hringdrifi/skjar/README.md

# SKJÁR

**SKJÁR** は、横長のタッチディスプレイと小型 Linux コンピュータを一体にした、40% のメカニカルキーボード / Cyberdeck です。

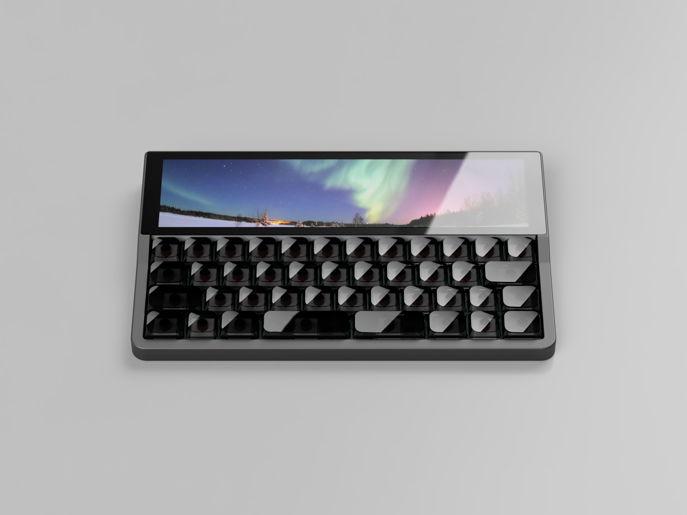
[picture p1: docs/images/render.png]
SKJÁR のレンダリング：上部に横長のディスプレイ、下に 42 キーの 40% キーボードを収めたケース


物理キーは文字入力に必要な最小限にとどめ、数字列・F キー・マクロ・メディア操作・ステータス表示などはタッチディスプレイ側に持たせます。PC につなげば普通の USB キーボードとして動き、本体側では Linux のアプリケーションが動きます。

> [!WARNING]
> **開発中のプロジェクトです。** 回路図・基板はまだ試作も動作確認もしていません。誤りが含まれている可能性が高いので、**このままの設計データで基板を発注したり、部品を買いそろえたりしないでください。** 内容は予告なく大きく変わります。

**状態：** 回路図を作成中。基板は部品の仮置きまで（配線は未着手）。決めたことは [docs/design-decisions.md](docs/design-decisions.md)、残っていることは [docs/open-items.md](docs/open-items.md) にあります。

---

## 名前の由来

古ノルド語の `skjár` から取りました。中世アイスランドで、半透明の膜を張った採光用の窓を指した言葉です。現代アイスランド語では「screen / display」を意味します。横長のディスプレイを主役にした本機に合わせた名前です。

---

## 設計思想

SKJÁR では、ディスプレイを「おまけ」として扱いません。物理キーとタッチ UI を合わせて、1つの入力システムにします。

一般的な 60% キーボードに画面を足すのではなく、

**必要最小限の物理キー ＋ 状況に応じて変わるソフトウェアキー**

という構成を基本にします。

---

## コンセプト

- 40% のコンパクトな物理キーボード
- 上部に 8.8″ の横長タッチディスプレイ
- Linux を搭載
- PC からは普通の USB HID キーボードとして見える
- 本体の Linux からも普通のキーボードとして見える（HID over I²C。素の Raspberry Pi OS のドライバで動く）
- キーごとの RGB バックライト
- タッチ UI を物理キーの拡張として使う
- Cyberdeck 的な自由度
- ケーブル1本でも全機能が動く（相手が 5 V / 1.5 A 以上を出せる場合）

---

## 構成

SKJÁR の構成：USB-C 2 口を TPS2121 で切り替え、RP2040 と CM0 を UART と I²C HID でつなぐ

| 部分 | 内容 |
|---|---|
| メインコンピュータ | Raspberry Pi Compute Module 0（CM0100000：CM0Lite、Cortex-A53 ×4 / 1 GHz、512 MB、Wi-Fi / BT）。microSD から起動 |
| キーボード用マイコン | RP2040（PC への USB HID、CM0 への HID over I²C、キーの RGB、電源の判断、CC の判定） |
| キー | Kailh Choc V2 系（ホットスワップ）×42。キーごとに RGB LED（SK6812MINI-E） |
| ディスプレイ | Waveshare 8.8inch DSI LCD または 8.8-DSI-TOUCH-A（480×1920、10点タッチ、DSI 2レーン） |
| 電源 | USB-C ×2、5 V 専用（PD なし）、上限 15 W。TPS2121 で切り替え |
| RTC | PCF8563T ＋ 32.768 kHz 水晶 ＋ CR2032 |
| 音声 | TLV320DAC3100（I²S コーデック。スピーカーアンプとイヤホン出力を内蔵）＋ スピーカー ＋ 3.5 mm イヤホンジャック |
| OS | Raspberry Pi OS Lite。デスクトップ環境は使わず、専用 UI を直接起動する。カーネルとドライバは標準のまま、オーバーレイと `config.txt` だけで大体の機能が動くようにする |

詳しい仕様と理由は [docs/design-decisions.md](docs/design-decisions.md) を見てください。

---

## タッチ UI でやりたいこと

数字列、F1〜F12、マクロキー、レイヤーの表示と切り替え、メディア操作、音量スライダー、輝度調整、アプリランチャー、PC のステータス表示、時計、CPU / RAM / ネットワークの表示、WPM 表示、アニメーション、動画再生、トラックパッドモード、ジェスチャ入力、アプリごとに変わる UI。

---

## リポジトリの構成

```text
README.md                 この文書
LICENSE, LICENSES/        ライセンスの説明と全文
docs/                     文書（CC BY-SA 4.0）
├─ design-decisions.md    設計判断の記録
├─ open-items.md          残件
├─ protocol.md            RP2040 ↔ CM0 の通信仕様
├─ pin-assignment.md      ピンの割り当てとシート間の信号
├─ schematic/             回路図のシートごとの仕様（部品、接続、定数）
├─ images/                図（構成図など）
└─ references/README.md   参照した一次資料の出典と要点
hardware/                 ハードウェア（CERN-OHL-S-2.0）
├─ pcb/                   KiCad 10 のプロジェクト（lib/：専用部品、production/：製造用データ）
├─ layout/                キー配列
└─ case/                  ケース
firmware/                 ファームウェア（MIT）
└─ rp2040/                キーボードと電源管理
software/                 CM0 側のソフトウェア（MIT）
├─ ui/                    専用 UI
└─ os/                    OS の設定とイメージ作成
```

他社の資料（データシート、図面、技適の試験成績書など）は、著作権の都合でリポジトリに含めていません。出典のリンクは [docs/references/README.md](docs/references/README.md) にあります。

---

## ライセンス

| 対象 | ライセンス |
|---|---|
| ハードウェア（回路図、基板、ケースの設計データ） | [CERN-OHL-S-2.0](LICENSES/CERN-OHL-S-2.0.txt) |
| ソフトウェア（ファームウェア、UI、スクリプト） | [MIT](LICENSES/MIT.txt) |
| 文書（この README と docs/ 以下） | [CC BY-SA 4.0](LICENSES/CC-BY-SA-4.0.txt) |

詳しくは [LICENSE](LICENSE) を見てください。
