hringdrifi/skjar/hardware/README.md

# hardware

SKJÁR のハードウェア設計データ。ライセンスは [CERN-OHL-S-2.0](../LICENSES/CERN-OHL-S-2.0.txt)。

| フォルダ | 内容 |
|---|---|
| [pcb/](pcb/) | KiCad 10 のプロジェクト（回路図と基板） |
| [layout/](layout/) | キー配列 |
| [case/](case/) | ケースの設計データ |
