hringdrifi/skjar/hardware/case/README.md

# case

ケースの設計データを置く。タイピングアングル、ケースの材質はまだ決まっていない（[docs/open-items.md](../../docs/open-items.md)）。
