hringdrifi/skjar/hardware/pcb/production/README.md

# production

JLCPCB に発注した版ごとの製造用データ（ガーバー、BOM、CPL）を置く。

フォルダ名は `rev<版>-<日付>`（例：`revA-20261201`）にする。
