hringdrifi/skjar/docs/schematic/rp2040.md

# RP2040 シート（rp2040.kicad_sch）

回路図を描くための仕様。GPIO の割り当ては [pin-assignment.md](../pin-assignment.md) の「3. RP2040 の GPIO」、決めた理由は [design-decisions.md](../design-decisions.md) を参照。

**[要決定]** は描く前に決める項目、**[要確認]** は描きながらデータシートで確かめる項目。

**手本：** [rp2040-reference.pdf](rp2040-reference.pdf)（画像は [rp2040-reference.png](rp2040-reference.png)）。2026-11-06 の回路図から書き出した版。回路図を変えたら書き出し直す。正は `hardware/pcb/rp2040.kicad_sch`。部品番号は 100 番台（U101、R101、C101 など）。

---

## 1. 部品

| 記号 | 部品 | シンボル | LCSC | 区分 |
|---|---|---|---|---|
| U101 | RP2040 | `MCU_RaspberryPi:RP2040`（QFN-56） | C2040 | Extended（Basic の代わりはない） |
| U102 | W25Q128JVPIQ（16 MB、WSON-8 6 × 5 mm） | `Skjar:W25Q128JVP`（自作。`Memory_Flash:W25Q128JVS` に露出パッドの 9 番（GND）を足したもの。`Package_SON:WSON-8-1EP_6x5mm_P1.27mm_EP3.4x4.3mm`） | C190862 | Extended（手持ち） |
| Y101 | 12 MHz 水晶 TAITIEN XXHBBCNANF-12.000000MHZ（負荷容量 20 pF、±10 ppm） | `Device:Crystal_GND24`（`Crystal_SMD_3225-4Pin_3.2x2.5mm`） | C521581 | Extended（手持ち） |
| SW101 | タクトスイッチ（BOOTSEL） | `Switch:SW_Push` | [要決定] | |
| 抵抗・コンデンサ | 0402 か 0603 | — | — | Basic から選ぶ |

## 2. 電源まわり（`+3V3` から）

| ピン | 接続 | 部品 |
|---|---|---|
| IOVDD（1, 10, 22, 33, 42, 49） | `+3V3` | **各ピンに 100 nF**（ピンの近くに置く） |
| USB_VDD（48） | `+3V3` | 専用のパスコンなし。隣の IOVDD（49）とピンの外ですぐにつなぎ、49 の 100 nF で兼ねる |
| ADC_AVDD（43） | `+3V3` | 100 nF |
| VREG_VIN（44） | `+3V3` | 1 µF |
| VREG_VOUT（45） | DVDD（23, 50）へ | VREG_VOUT に 1 µF、DVDD の各ピンに 100 nF |
| TESTEN（19） | GND | |
| GND（57、裏面のパッド） | GND | |

- **1.1 V のコア電源：** RP2040 内蔵のレギュレータで作る（VREG_VOUT → DVDD）。ネット `+1V1` は電源記号（`power:+1V1`）で描く。外付けのレギュレータは要らない。
- **USB_VDD のパスコンを省いた理由：** 右辺（43〜50）はピンが 2.6 mm に集まり、パスコンを置く場所が足りない。1 個減らせば残りをピンに近づけられる。USB はフルスピード（12 Mbps）だけで電流も小さいので、隣の 49 番の 100 nF（QSPI 側で電流の変化が大きいほう）を近くに置いて兼ねる。部品番号 C108 は欠番。
- **ADC_AVDD の雑音対策：** CC の判定は電圧の範囲が広いので、RC フィルタは入れずにコンデンサだけにする。

## 3. 水晶（12 MHz）

| ピン | 接続 |
|---|---|
| XIN（20） | 水晶の一端、負荷コンデンサで GND へ |
| XOUT（21） | 直列抵抗を通して水晶のもう一端へ、負荷コンデンサで GND へ |
| 水晶の GND 端子（2, 4） | GND |

- **負荷コンデンサ：** **27 pF**（C0G、C107045）を各 1 個。前に作った基板（Segl）で、同じ水晶・27 pF・1 kΩ の組み合わせで動いた実績がある。計算上の値（2 ×（20 pF − 浮遊容量 3〜5 pF）≒ 30〜33 pF）より少し小さいので、周波数はわずかに高めになるが、発振の余裕は増える。
- **XOUT の直列抵抗：** 1 kΩ（Raspberry Pi の設計資料と Segl と同じ）。起動が不安定なら、小さくすると余裕が増える。
- **Raspberry Pi の推奨回路との違い：** 設計資料の回路は ABM8-272-T3（負荷容量 10 pF・ESR 50 Ω）に 15 pF。負荷容量 20 pF の水晶は大きなコンデンサが要るぶん発振の余裕が小さいが、実績を優先した。駄目なら ABM8-272-T3（C20625731）と 15 pF に替える（フットプリントは同じ）。
- **ファームウェア側の対策：** 水晶の起動が遅い場合に備えて、pico-sdk の `PICO_XOSC_STARTUP_DELAY_MULTIPLIER` を大きめ（例：64）にしておく。

## 4. QSPI フラッシュ（W25Q128JVPIQ、WSON-8 6 × 5 mm）

裏面の露出パッド（9 番）は GND につなぐ（データシートでは未接続か GND でよい）。はんだの固定と放熱のため。基板ではパッドの中に GND のビアを打つ。

| RP2040 | W25Q128 | 
|---|---|
| QSPI_SS（56） | /CS（1） |
| QSPI_SD1（55） | DO / IO1（2） |
| QSPI_SD2（54） | /WP / IO2（3） |
| QSPI_SD0（53） | DI / IO0（5） |
| QSPI_SCLK（52） | CLK（6） |
| QSPI_SD3（51） | /HOLD / IO3（7） |
| `+3V3` | VCC（8）、100 nF |
| GND | GND（4）、露出パッド（9） |

- **配置：** RP2040 のすぐ近くに置き、配線は短く揃える。

## 5. BOOTSEL と RUN

| 信号 | 接続 |
|---|---|
| QSPI_SS（56） | **BOOTSEL スイッチ**を 1 kΩ を介して GND へ。押しながら Port A を挿すと UF2 の書き込みモードになる |
| RUN（26） | 10 kΩ で `+3V3` にプルアップ。テストパッドを付ける（GND に落とすとリセット） |
| SWCLK（24）/ SWDIO（25） | テストパッドだけ（CM0 にはつながない） |

- **普段のファーム更新：** CM0 から UART のコマンドで「UF2 の書き込みモードで再起動」を送れるので、BOOTSEL スイッチは、初回の書き込みとファームが壊れたときの復旧用。

## 5.1 CM0 の USB ブート要求

| 信号 | 接続 |
|---|---|
| `BOOT_EN`（GPIO23） | cm0 シートの Q202（2N7002）のゲートへ。High で CM0 の nRPI_BOOT を Low に引く |

- 要求はキーの組み合わせで出す（専用のスイッチ SW102 とプルアップ R104 は廃止。GPIO20 はキーの RGB に回した）。
- RP2040 は要求を受けたら、`BOOT_EN` を High にしてから GLOBAL_EN を解除する（電流宣言が Default でも、CM0 だけ ON にする）。

## 5.2 キーの RGB

| 信号 | 接続 |
|---|---|
| `RGB_DATA`（GPIO14） | keymatrix シートのバッファ（SN74AHCT1G125）へ。PIO で出す |
| `RGB_EN`（GPIO20） | keymatrix シートの 2N7002 のゲートへ。High で `+5V_LED` が ON（プルダウンは keymatrix シート側） |

- LED の電源を切っているときは、`RGB_DATA` を Low にしておく。

## 6. USB（Port A）

| RP2040 | 接続 |
|---|---|
| USB_DP（47） | 27 Ω を介して `USB_A_D+`（power シートから） |
| USB_DM（46） | 27 Ω を介して `USB_A_D-`（power シートから） |

- **27 Ω の位置：** RP2040 の近くに置く。
- **PC がつながっているかの判定：** `CC1_A` / `CC2_A` の電圧で判定し、つながっていないときは USB を有効にしない（自分で給電しているデバイスなので、相手がいないときに D+ をプルアップしてはいけないため）。

## 7. GPIO

| GPIO | ピン | 信号 | 接続先 | 備考 |
|---|---|---|---|---|
| 0 | 2 | `COL5` | keymatrix | 出力（RMK の COL2ROW で、順に High にする） |
| 1 | 3 | `COL4` | keymatrix | 出力（RMK の COL2ROW で、順に High にする） |
| 2 | 4 | `COL3` | keymatrix | 出力（RMK の COL2ROW で、順に High にする） |
| 3 | 5 | `COL2` | keymatrix | 出力（RMK の COL2ROW で、順に High にする） |
| 4 | 6 | `COL0` | keymatrix | 出力（RMK の COL2ROW で、順に High にする） |
| 5 | 7 | `COL1` | keymatrix | 出力（RMK の COL2ROW で、順に High にする） |
| 6 | 8 | `ROW1` | keymatrix | 入力。内部のプルダウンを使う |
| 7 | 9 | `ROW3` | keymatrix | 入力。内部のプルダウンを使う |
| 8 | 11 | `ROW5` | keymatrix | 入力。内部のプルダウンを使う |
| 9 | 12 | `ROW6` | keymatrix | 入力。内部のプルダウンを使う |
| 10 | 13 | `ROW0` | keymatrix | 入力。内部のプルダウンを使う |
| 11 | 14 | `ROW2` | keymatrix | 入力。内部のプルダウンを使う |
| 12 | 15 | `ROW4` | keymatrix | 入力。内部のプルダウンを使う |
| 13 | 16 | `KB_INT` | cm0 | オープンドレインで Low に引くだけ（プルアップは cm0 シート側）。テストパッド TP108 |
| 14 | 17 | `RGB_DATA` | keymatrix | キーの RGB のデータ（PIO） |
| 15 | 18 | `CM0_PWROFF` | cm0 | ゲートのプルアップは cm0 シート側 |
| 16 | 27 | `RP_TXD` | cm0 | UART0 TX。cm0 シートのバッファへ |
| 17 | 28 | `CM0_TXD` | cm0 | UART0 RX。**プルなし** |
| 18 | 29 | `LCD_EN` | power | プルダウンは power シート側 |
| 19 | 30 | `PWR_ST` | power | プルアップは power シート側 |
| 20 | 31 | `RGB_EN` | keymatrix | High でキーの RGB の電源が ON（プルダウンは keymatrix シート側） |
| 21 | 32 | `CM0_RUN_PG` | cm0 | **プルなし** |
| 22 | 34 | `CM0_HALT` | cm0 | **プルなし** |
| 23 | 35 | `BOOT_EN` | cm0 | Q202 のゲートへ（プルダウンは cm0 シート側） |
| 24〜25 | 36〜37 | `KB_SDA` / `KB_SCL` | cm0 | I2C0（ターゲット）。**プルなし**（プルアップは cm0 シート側）。テストパッド TP106 / TP107 |
| 26〜29 | 38〜41 | `CC1_A` / `CC2_A` / `CC1_B` / `CC2_B` | power | 各 1 kΩ の直列抵抗を介して ADC へ |

- **CC の直列抵抗（1 kΩ）：** 過電圧保護でその入力が遮断され、RP2040 の電源が切れているときでも、相手の Rp から ADC のピンに電流が流れ込みすぎないようにするため。
- **キーマトリクスの並び：** 基板で配線しやすい順に GPIO0〜12 を割り当てた（2026-11-06）。番号の順にはなっていないので、ファームウェアのピン定義はこの表（または [pin-assignment.md](../pin-assignment.md)）から取る。

## 8. テストパッド

`+3V3`、GND、RUN、SWCLK、SWDIO、`KB_SDA` / `KB_SCL`（GPIO24 / 25。TP106 / TP107）、`KB_INT`（GPIO13。TP108）。

## 9. シート外とつなぐグローバルラベル

| ラベル | 向き |
|---|---|
| `USB_A_D+` / `USB_A_D-` | 双方向（↔ power） |
| `CC1_A` / `CC2_A` / `CC1_B` / `CC2_B` | 入力（← power） |
| `PWR_ST` | 入力（← power） |
| `LCD_EN` | 出力（→ power） |
| `CM0_PWROFF` / `BOOT_EN` / `RP_TXD` / `KB_INT` | 出力（→ cm0） |
| `KB_SDA` / `KB_SCL` | 双方向（↔ cm0） |
| `CM0_TXD` / `CM0_RUN_PG` / `CM0_HALT` | 入力（← cm0） |
| `ROW0`〜`ROW6`、`RGB_DATA`、`RGB_EN` | 出力（→ keymatrix） |
| `COL0`〜`COL5` | 入力（← keymatrix） |
