hringdrifi/skjar/docs/schematic/display.md

# ディスプレイシート（display.kicad_sch）

**手本：** [display-reference.pdf](display-reference.pdf)（画像は [display-reference.png](display-reference.png)）。

## 1. 22 ピン DSI コネクタ（J301、0.5 mm ピッチ）

Raspberry Pi 5 / CM4 と同じピン配置（2026-11-05 に戻した。11-03〜11-05 は逆順だった）。8.8-DSI-TOUCH-A を付属の 22 ピン FFC（両端で接点の向きが逆）でつなぐと、基板の n 番がパネルの 23 − n 番につながる。

| ピン | 信号 | ピン | 信号 |
|---|---|---|---|
| 1 | GND | 12 | `DSI_D2_P` |
| 2 | `DSI_D0_N` | 13 | GND |
| 3 | `DSI_D0_P` | 14 | `DSI_D3_N` |
| 4 | GND | 15 | `DSI_D3_P` |
| 5 | `DSI_D1_N` | 16 | GND |
| 6 | `DSI_D1_P` | 17 | 未接続 |
| 7 | GND | 18 | 未接続 |
| 8 | `DSI_CK_N` | 19 | GND |
| 9 | `DSI_CK_P` | 20 | `I2C_DSI_SCL` |
| 10 | GND | 21 | `I2C_DSI_SDA` |
| 11 | `DSI_D2_N` | 22 | `+3V3_CM0`（100 nF） |

- **ピン番号の決め方：** どちらの端が 1 番かは、J301 の向きと割り当てで自由に決められる。決まっているのは、FFC の線の物理的な並び（ディスプレイの向きと通し方で決まる）。今の通し方では、J301 の端で 3V3 の線が基板の上側（奥）に来るので、奥の端の 22 番を 3V3 にした。ケーブルをねじらずに済む。
- **TOUCH-A 側のピン配置と照合済み：** [Wiki の Interfaces の図](https://www.waveshare.com/wiki/8.8-DSI-TOUCH-A)では、パネル側は 1 番 3V3、2 番 I2C_SDA、3 番 I2C_SCL … 22 番 GND。基板の n 番がパネルの 23 − n 番につながるので、22 本すべてが一致する。
  - 未接続の 17 / 18 番は、パネルの 6 / 5 番（RESERVE）に当たる。
  - 上下両面に接点があるコネクタだと、FFC を裏返して挿しても接点が当たり、電源と GND が入れ替わる。正しい面にしか接点が当たらない片面接点のコネクタにする。
- **3V3 は `+3V3_CM0` から取る：** CM0 が OFF のときはパネル側の I²C にも電圧がかからないので、CM0 に逆電圧がかからない。
- **コネクタの部品：** **Hirose FH12A-22S-0.5SH(55)**（2026-11-05。片面接点の上接点、フロントフリップ、高さ 2.0 mm、LCSC C3168813）。上接点（ケーブルの接点を基板と反対に向けて挿すもの）で、はんだ付けの足が差し込み口と反対側にある。ランドパターンは FH12 と共通で、1 番の位置も同じなので、フットプリントは KiCad 標準の `Connector_FFC-FPC:Hirose_FH12-22S-0.5SH_1x22-1MP_P0.50mm_Horizontal` のまま。本体は FH12 より少し幅が広い（22 ピンで 15.5 mm、FH12 は 15.1 mm）。
  - 置き方：基板の裏、CM0 の右。差し込み口が左（FFC の穴の方）、足が右、1 番が手前、22 番（3V3）が奥に来る向き（90°）。
  - FFC の通し方（2026-11-05）：ディスプレイは 0° で付ける（コネクタは左寄り）。TOUCH-A の背面のコネクタからケーブルは左に出る（3V3 の線は奥）。ディスプレイと基板の間で右へ折り返し、CM0 の上を通って、J301 の左の穴を S 字にくぐり、基板の裏で J301 に左から挿す。折り返しでケーブルの長さを調整する。折り目はどれもケーブルの長さの向きに直角で、斜めには折らない。
  - 面の向き：折り返し 1 回で面が 1 回裏返り、S 字では裏返らない。J301 の端ではケーブルの接点が基板と反対を向くので、上接点を使う（2 回裏返る前の通し方では下接点の FH12 だった）。
  - 線の並び：直角に折っても、穴をくぐっても、線の上下（奥と手前）の並びは変わらない。J301 の端では、奥から 3V3、SDA、SCL … D3、D2、CK、D1、D0、GND と並ぶ。
  - DSI の配線：CM0 は 180° 回して置くので、右の辺の DSI のピンは上から D3、D2、CK、D1、D0（各ペアは P が上）で、J301 の並びと同じ。J301 の足は CM0 と反対（右）を向くので、配線は FFC の穴の端を回り、J301 の下を F.Cu で通って、足の先でビアを打って折り返し、パッドに入れる。1 本ずつ同じ高さで折り返すので交差しない。
  - 実物が届いたら、挿す前に面と向きを確かめる。斜めに折ったりひねったりすると、接点の面と線の並びが変わる。

## 2. LCD の電源（J302）

ライトアングルの 2.54 mm 1×3 ピンヘッダ（`Connector_PinHeader_2.54mm:PinHeader_1x03_P2.54mm_Horizontal`）。1 番 `+5V_LCD`、2 番 `+5V_LCD`、3 番 GND（Raspberry Pi の 2・4・6 番と同じ並び）。挿し込み口を基板の穴の方に向けて配置する。

## 3. シートをまたぐネット

- グローバルラベル：`DSI_*`（10 本、入力）、`I2C_DSI_SDA` / `I2C_DSI_SCL`（双方向）
- 電源記号：`+5V_LCD`（power シートから）、`+3V3_CM0`（cm0 シートから）、GND
