hringdrifi/skjar/docs/open-items.md

# 残件

2026-11-01 時点。決まったことは [design-decisions.md](design-decisions.md) にある。

## 基板の配置の前に決めること
- [ ] 基板は仮の配置まで済み（`hardware/pcb/skjar.kicad_pcb`、228.6 × 146.2 mm。キー 12 個分の幅で、最下段の手前で切る。ディスプレイ（240.5 mm）は左右に約 6 mm ずつはみ出すので、ケースの縁で支える）。キーの間隔は仮に 19.05 mm、部品はすべて裏面。2026-11-05 にディスプレイを 0° に戻し、CM0 を中央へ移した（[design-decisions.md](design-decisions.md) の 4 章）。決めること：LCD の電源ケーブルの穴、USB-C・microSD・イヤホンジャックを基板の縁に合わせる微調整、移した部品の細かい位置
- [ ] キーのフットプリント（`CPG135001S30_<幅>U`。1U・1.25U・1.75U・2.25U・2.75U）は Choc V2 専用（V1 用の左右の足の穴は消した。スタビライザーとキーキャップが V2 前提のため）。ソケットのパッドが部品面（F.Cu）にあるので、基板では裏返して置いた。裏返したときに、スイッチのピンの位置が上から見て正しいかを確かめる
- [ ] キーの間隔（19.05 mm か 18 mm か）
- [ ] スペース（2.75u、2.25u）用の Choc スタビライザー：Kailh の Choc V2 用（CPG1353G24D01。Chosfox のクロスコアや Keebio の Choc V2 スタビと同じもの）を前提に、基板の穴（`CPG1353G24D01_<幅>U`）を置いた。Kailh の図面は見つからなかった。実物を測った値：左右の中心は 12 mm、基板に刺さる部分は 5.9 × 7.8 mm、プレートを通る部分は幅 5.9 mm・高さ約 14.2 mm。基板の穴は Keebio のフットプリント（中心から左右 12 mm、6.5 × 9.5 mm）に合わせ、角は 0.5 mm で丸めた。穴がソケットのパッド 1 に 0.25 mm かかるのは承知の上。プレートの穴（`CPG1353G24D01_<幅>U_Plate`。2.25U と 2.75U で穴は同じで、Fab の外形だけ違う）は実寸を元に描いた 1 つの輪郭で、スタビライザーの穴 6.0 × 14.05 mm（中心から左右 12 mm）、スイッチの穴 14.0 × 14.0 mm、その上側をつなぐワイヤーの溝（高さ 1.5 mm）。3D モデルはない。試作のプレートで、はまり具合を確かめる
- [ ] Choc ホットスワップソケット：仮に Kailh CPG135001S30（C5333465、Extended。ソケット自体は Choc V1 / V2 両対応だが、基板は V2 専用）を割り当てた。手持ちがあればそれにする
- [ ] キーの RGB（SK6812MINI-E）の配置：位置は決めた（スイッチの中心から 4.93 mm 上、[design-decisions.md](design-decisions.md) の 6.1）。基板に置くときに、穴が 1 個ずつ開いているかを確かめる。数珠つなぎの順番は回路図で行ごとに折り返した（1→12、23→13、24→34、42→35）ので、基板の配置もこれに合わせる
- [ ] Lofree Wizard に LED 窓があるか（光を通すか）を実物で確かめる。資料は見つからなかった
- [ ] ケース（タイピングアングルは 3.5° に決めた。[design-decisions.md](design-decisions.md) の 7 章）：[hardware/case/](../hardware/case/) に仮の形を作った。決めること：
  - 基板を留めるねじの位置（今は仮の 12 か所。部品の配置に合わせて 3 か所動かした（2026-11-03））。基板に穴を開けて、ほかの部品をよける
  - 厚さ（手前 15.4 mm、奥 24.8 mm）と、ガラスのまわりの縁の幅（1.4 mm）
  - 基板を斜めに差し込んで寝かせられるか（部品の配置を変えたあとに、傾ける・手前へずらす・上へ抜く動きで当たりを確かめる。2026-11-05 の配置では、5° まで傾け、5 mm ずらし、10 mm 上げるまで当たりなし。3D モデルのない J402・U4・Y402・SW101 は確かめていない）
  - USB-C・イヤホン・microSD の穴の大きさと高さ（USB-C は寸法図から 3D モデルを作った（2026-11-05）。イヤホンと microSD は寸法を仮に置いた）
  - BOOTSEL（SW101）を底の穴から押せるか（穴から約 10 mm 奥にある）
  - ディスプレイのスタッドのねじ（M2.5 の雌ねじと仮定）
- [ ] 2層・1枚（1.2 mm、差動線は GCPW。[design-decisions.md](design-decisions.md) の 7 章）で、USB（Port B → CM0）を 2〜3 cm 以内、DSI（CM0 → FPC）を 3〜5 cm 以内に引けるかを、配線して確かめる
- [ ] LCD の電源ケーブルの穴（まだ開けていない）。J302（x 118.1、y 52.6）の奥、x 116.3〜124.9、y 63.2〜67.6 に開ける前提で部品をよけてある（Cmts.User に印）。FFC の穴は J301 の左に開けた（x 167.4〜173.4、y 37.1〜57.3、2026-11-05）。J301（x 201.6、y 47.15）の高さは、8.8inch DSI LCD の DSI コネクタ（x 109.5、y 47.15）にそろえた。TOUCH-A のコネクタは x 101.1、y 45.5。付属の FFC は約 200 mm
- [ ] DSI（CM0 → J301）は FFC の穴の端を回るので、まっすぐより長くなる（見込み 40 mm 前後）。穴の長さ（20.3 mm）を FFC の幅（約 12 mm）に近づければ短くできる
- [ ] 作業済みのキーの配線のうち、COL2（B.Cu）がディスプレイの穴（DISP2 の右下、x 201.6、y 79.8）にかかる（DRC で 1 か所）。ディスプレイを 0° に戻して、前の 7 か所は消えた。配線を穴の外へ引き直す
- [x] 基板の取り付け穴（H1〜H12、`Skjar:MountingHole_M2_CaseBoss`）を、ケースのスクリプトの仮の 12 か所に置いた（2026-11-03）。M2 を上から締めて、ケースの柱（Ø5、インサート）に留める。部品・配線・ディスプレイの穴とキーのスイッチに当たらないこと、キーキャップを押し込んでもねじの頭（Ø4 以下）から 2.7 mm 以上離れることを確かめた。make_case.py は H の位置から柱を立てる。部品を動かして当たるようになったら、穴の方を動かしてケースを作り直す
- [x] J301 のピンの割り当てを Raspberry Pi と同じ順に戻した（2026-11-05。11-03 からは逆順だった）。ディスプレイを 0° に戻して FFC の通し方が変わり、3V3 の線が基板の上側（奥）に来るので、奥の端を 22 番（3V3）にした（[schematic/display.md](schematic/display.md)）
- [ ] ディスプレイの取り付け（TOUCH-A と 8.8inch DSI LCD の両方。[design-decisions.md](design-decisions.md) の 4 章）：スタッドを通す穴のフットプリント `Waveshare_8.8-DSI-TOUCH-A_Studs`（DISP1）と、確認用の 8.8inch DSI LCD のモデルと穴（DISP2）を、基板の中央・キーの上に置いた。コネクタやカバーの出っ張りの穴は、モデルを見ながら手で開ける。決めること：
  - ディスプレイと基板の間の高さ（ケースの設計と合わせて決める。3D モデルの高さもそれに合わせる。今はスタッドの底が基板の表面）
  - 基板上のフットプリントの位置（J301 と、TOUCH-A の FPC の位置を合わせる）
  - 8.8inch DSI LCD を 0° で付けたとき（DISP2 の今の高さ。2026-11-03 に公式 STEP から調べた 180° のときの範囲を、ディスプレイの中心で点対称に移したもの、2026-11-05）：
    - DSI コネクタは基板の座標で x 107〜112、y 35.5〜58.5 に来る。J301 までは約 70 mm で、Pi 5 用の「DSI-Cable-12cm」（15 → 22 ピン）は上での折り返しと穴の S 字を入れて届くかが際どい。実物で確かめる。このケーブルも TOUCH-A のケーブルも、Pi 5 の 22 ピンにそのまま挿せる作りなので、22 ピン側の端の接点の面と信号の並びの関係は同じ
    - ドライバ基板の部品のうち、次のものは基板の表面より下まで出るので、基板に穴が要る：DSI コネクタ（上の範囲）、40 ピンのコネクタ（x 199〜205、y 37.5〜61.5）、USB-C（x 97〜103.5、y 61.5〜70.5）、4 ピンのコネクタ（x 105〜117、y 74.5〜83）、2 ピンのヘッダ（x 119〜124、y 78.5〜82.5）、スイッチ（x 145〜153、y 77〜83）、小さな部品（x 200.5〜204、y 65.5〜74.5 と x 116〜120、y 65〜67）。今の配置では、どれも裏の部品のコートヤードにかからない
  - 2D 図面の背面図は上下が逆に描かれている（8.8inch DSI LCD の公式 STEP と比べてわかった）。TOUCH-A の自作 3D モデルは図面から起こしたので、FPC コネクタの上下が逆の可能性がある。実物で確かめる
- [ ] 電池ホルダーの向き（MY-2032-08 か -08-R か）
- [ ] アンテナの貼り付け位置（CM0 から 60 mm 以内。TOUCH-A のアルミ背面を避ける）
- [ ] 熱の逃がし方（裏面の CM0 からケースの底板へ逃がす案）
- [ ] ケースの材質
- [ ] microSD のスロットを、ケースの外からカードを抜き差しできる位置に置く。2026-11-05 に TF-01A（プッシュプッシュ）に変え、本体の前を基板の縁にそろえた（[schematic/cm0.md](schematic/cm0.md) の 5a）。後ろの壁（厚さ 2.43 mm）のままだと、ロックしたカードは壁の外面より約 0.4 mm 内側、飛び出したカードは外へ約 2.7 mm。壁を J201 の前だけ 1 mm ほど削れば、ロック時に約 0.6 mm、飛び出し時に約 3.7 mm 出る。削るかを決める
- [ ] 3.5 mm イヤホンジャックの位置（ケースの外から挿せる位置）

## 回路図を描きながら決めること
- [x] 22ピン FPC コネクタ（J301）：Hirose FH12A-22S-0.5SH(55)（C3168813、片面の上接点）にした（2026-11-05。11-03 からは下接点の FH12-22S-0.5SH(55)、C597981）。FFC の通し方が変わり、J301 の端で接点が基板と反対を向くため。両面接点だと、FFC を裏返して挿しても接点が当たり、3V3 と GND が入れ替わるので使わない。向きは [schematic/display.md](schematic/display.md)。実物の FFC で、接点を基板と反対に向けて挿したときに 3V3 の線が 22 番（奥）に来るかを確かめる
- [ ] タクトスイッチ（SW101、BOOTSEL）：仮に TS-1187A-B-A-B（C318884、Basic、5.1 × 5.1 × 1.5 mm）を割り当てた。ケースの穴から押せるかで確定する
- [ ] 22 ピン DSI の FFC の向き（1 番ピンと接点の面）を実物で確かめる。ピン配置は CM4 IO ボードの資料（J16）と、8.8-DSI-TOUCH-A の Wiki のピン表（FFC で反転）の両方と一致を確認済み。8.8″ 液晶はカーネルのドライバで 2 レーン・480 × 1920（D2 / D3 は配線するが使わない）
- [ ] スピーカーとコネクタ（J401）：コネクタは仮に PicoBlade 53261-0271（C177225、1.25 mm）を割り当てた。スピーカーの候補は 3520BOXCF-2P1.25（C49247026、35 × 20 × 3.7 mm、8 Ω 1 W）など。プラグが PicoBlade 互換かを図面で確かめる
- [ ] TPS2121 出力側のコンデンサ（C4）：仮に 470 µF 10 V ポリマー MA10V470M6X8（C46550459、6.3 × 7.7 mm）を割り当てた。1000 µF にしても切り替え時の電圧の落ち込みはほとんど変わらず、突入電流（ソフトスタートで約 0.37 A → 0.78 A）が増えるだけ
- [ ] RTC の時計の精度の確認（PCF8563 のデータシートの特性は負荷容量 8 pF の水晶が前提。選んだ水晶は 9 pF なので差は小さいが、OSCI に調整用のコンデンサが要るか、試作で測って判断する）
- [ ] 電池ホルダーのパッド寸法の確認
- [ ] 自作フットプリントの寸法の確認（LCSC / EasyEDA から作ったもの）：U3 TPS2121（`Skjar:Texas_RUX_VQFN-HR-12_2.5x2mm_P0.5mm`。TI の推奨ランドパターンと照合する）、U201 CM0（`Skjar:RaspberryPi_CM0_Castellated`。データシートの推奨と同じ 0.6 × 2.4 mm・1 mm ピッチ）、J301、BT401
- [ ] J402（PJ-320D-4A）の S 端子が、プラグのスリーブに触れる端子かを図面で確かめる（イヤホンの検出はスリーブで R2 と S がつながることを使う）
- [ ] 12 MHz 発振器（Y402）の部品：仮に YXC OT2EL89CJI-111YLC-12M（C5280582、3225 4 ピン、1.8〜3.3 V）。手持ちがあればそれにする
- [ ] **RP2040 がリセットされると、CM0 の電源がいきなり切れる**（2026-11-12、死活の整理で気づいた）。`GLOBAL_EN` を引く N-MOSFET のゲートはプルアップで、RP2040 が何もしなければ CM0 は OFF（[design-decisions.md](design-decisions.md) の 2.5）。RP2040 のリセット中（ウォッチドッグでの再起動、UF2 での書き換え、BOOTSEL）はピンが手放しになるので、Linux が書き込み中でも電源が落ちる。案：ゲートの抵抗の向きを変えて手放しのときは ON にする（電源を入れた瞬間、電流の判定より前に CM0 が起動する）、リセットをまたいで状態を保つ部品を足す、ファームの書き換えは CM0 を止めてからに限る（運用で避ける）

## 実物で確認すること
- [ ] LCD の最大電流と突入電流（バックライト 0〜100%）
- [ ] 4.5〜4.7 V で LCD と CM0 が正常に動くか
- [ ] 最大負荷のときの電圧（テストパッドで測る）
- [ ] CM0 のシャットダウン時間
- [ ] CM0 で DSI が 60 Hz で出るか
- [ ] CM0 の外形寸法の照合。フットプリントの F.Fab に描いた CPU・無線モジュール・アンテナコネクタの位置（データシートの図 2 から）と eMMC の位置（BGA153 の 13 × 11.5 mm。EDATEC の資料の 10 ページの上面図の枠を基準に、eMMC 付きの写真で読んだ枠の中のずれ（チップは枠の下端に寄り、上に約 0.45 mm の隙間）を当てはめた。CM0Lite では未実装）、3D モデルの基板の厚さ（仮に 1.0 mm）と部品の高さも確かめる
- [ ] 1.5 A のときのバックライト上限値
- [ ] TOUCH-A の取り付け穴の位置
- [ ] ED-ANT-C の入手（EDATEC への問い合わせ）
- [ ] rpiboot で、CM0Lite の SD カードを USB ストレージとしてパソコンに見せられるか
- [ ] 使う microSD カードの選定（A1 / A2、高耐久品）と、起動の確認

## ソフトウェア
- [ ] TLV320DAC3100 のデバイスツリーのオーバーレイ。下書きは [software/os/overlays/](../software/os/overlays/)。MCLK（12 MHz の発振器）を使い、コーデックをクロックを出す側にしたので、標準の `simple-audio-card` だけで動く見込み。実機で確かめる
- [ ] キーボードモードとサイバーデックモード（[protocol.md](protocol.md) の 2.6）の残り：PC への USB HID で実際に出力先を分ける、サイバーデックモードのキーマップ（レイヤー 3〜5。いまはレイヤー 0〜2 の写し）を決める、今のモードをキーの RGB でも示すか
- [ ] USB のリモートウェイクアップ：PC がスリープしているとき（`USB,0`）にキーを押したら PC を起こす。いまはスリープで「PC につないで」の表示になる。RMK と embassy-usb の対応を調べる
- [ ] コンソールの自動ログイン（`raspi-config` の Boot / Auto Login）にするか。UI を閉じるたびにログインするのは手間。ルートを読み取り専用にするときの扱いと合わせて決める
- [ ] 起動の速さ（OS のイメージを作るときに直す）。試作機（Pi 4B、Raspberry Pi OS Lite 64-bit、2026-11-11）で `systemd-analyze` は 41 秒（カーネル 4 秒＋ユーザー空間 37 秒）。分かったこと：
  - Zero 2 W（CM0 と同じ SoC、2026-11-12）では 48.5 秒（カーネル 5.8 秒＋ユーザー空間 42.7 秒、cloud-init は止めていない）。`systemd-analyze blame` で NetworkManager 20.4 秒、cloud-init 4.9 秒、rpi-resize-swap-file 3.5 秒、skjar-weather 3.0 秒と、下の 4B と同じ原因で、CPU が遅い分だけ長い。UI 自体の起動は約 0.9 秒（うち背景の絵が 0.7 秒）、電光掲示板が流れている間の CPU は 1 コアの 13〜15%
  - cloud-init（Raspberry Pi Imager のカスタマイズ）が毎回の起動で約 5 秒。`/etc/cloud/cloud-init.disabled` で止めて 31 秒になった。イメージには cloud-init を入れない
  - 残りの大半は NetworkManager の約 18 秒。接続の設定（eth0 と Wi-Fi）が netplan（`/etc/netplan/90-NM-*.yaml`）にあり、NetworkManager が起動のたびに書き直す。そのたびに netplan が `systemctl daemon-reload`（1 回約 3 秒）を頼み、4 回で約 17 秒。イメージでは、接続の設定を NetworkManager の keyfile（`/etc/NetworkManager/system-connections/`）だけで持ち、netplan を通さない（試作機では、SSH が切れると困るので試していない）
  - systemd-resolved は入っていない。NetworkManager の `dns-mgr: DNS plugin did not become ready` の警告は、待たされた結果で、原因ではなかった
  - `skjar-ui@.service` は `After=systemd-user-sessions.service` で、これが `network.target` の後なので、UI もネットワークの準備を待つ。UI はネットワークを使わないので、フレームバッファ・タッチ・UART が揃えば出すように並べ直す
  - 待ち時間を感じさせない案：RP2040 がキーの RGB で起動中の光り方を出す（CM0 の `HELLO` まで）。虹色の画面（`disable_splash=1`）とカーネルの文字・ロゴ（`quiet logo.nologo vt.global_cursor_default=0`）を消す。UI をネットワークより先に出す。それでも黒い時間が長ければ、Plymouth で SKJÁR のロゴ（パネルが縦長なので回す設定が要る）
  - `skjar-weather` / `skjar-news` が、タイマー（起動の 1 分後）より前の起動直後に動いている。path ユニットが、起動時に `.request` があると動かしているらしい。起動直後の取得でよいか、やめるかを決める
- [ ] HID over I²C を確かめる（ファームは [firmware/rp2040/](../firmware/rp2040/)、オーバーレイは [software/os/overlays/](../software/os/overlays/)。アドレス 0x2C、レジスタの番地とレポートは [protocol.md](protocol.md) の 2 章に試作の値を書いた）。確かめたら、値を決定にする
  - 2026-11-12、XIAO RP2040 と Pi 4B（i2c-gpio、約 100 kHz）で、`i2c-hid` が `I2C HID v1.00 Keyboard [hid-over-i2c 1209:0001]` として認識し、`evtest` で物理キー（`KEY_Q`）の押した・離したが届いた。UI のタッチキー（F1、F6）も、UART の `TK` から RMK を通って I²C で届いた。UI の Pad（トラックパッド）も、`PTR` からマウス（`hid-over-i2c 1209:0001 Mouse`、`REL_X` / `REL_Y`）として届いた。ただし動きのレポートの間隔が 20〜30 ms（UI は 10 ms ごとに送る）で、I²C の速さで間引かれているらしい
  - `delay-us` 2（約 250 kHz）も試した（2026-11-12）：認識はされるが、マウスの間隔は 20〜30 ms のままで、動かしている途中でレポートが止まった（dmesg にエラーなし）。100 kHz（`delay-us` 5）のままにする。間隔はパネルのタッチで決まっていた：Goodix（`10-005d Goodix Capacitive TouchScreen`）の報告がちょうど 24 ms ごと（約 42 回 / 秒）で、マウスのレポートはその 1 回に 1〜2 個（1 回の動きが ±127 を超えると分けて送る）。I²C は 1 レポート約 1.5 ms で余裕がある。24 ms ちょうどなので、パネルのドライバが一定の間隔で読む方式かもしれない（速くできるかは未確認）
  - 止まったとき、RP2040 のログは `hid_i2c: queue full, dropping the oldest report` の繰り返し（Pi が読みに来ない）。Pi を再起動しても `i2c_hid_of` がキーボードを登録できず、RP2040 を抜き差しするまで戻らなかった。I²C の読み出しが 1 回こじれると、RP2040 の I²C のターゲットが固まるらしい。RP2040 側で立ち直る仕組み（読みに来ない・バスが止まったままなら I²C をやり直す、など）が要る
  - 残り：Caps Lock の LED（出力レポート）、Consumer Control（音量キー）（`delay-us` 2 で約 250 kHz）、CM0（Zero 2 W）でも同じか
  - RP2040 だけが再起動すると（ファームの書き換えなど）、キーが効かなくなる。RP2040 は `i2c-hid` の `RESET` を受けるまで入力を捨てるが、`i2c-hid` が `RESET` を送るのは見つけたときの 1 回だけ（2026-11-12、XIAO を書き換えたあとに起きた。`/sys/bus/i2c/drivers/i2c_hid_of/` の unbind / bind で戻った）。案：UI が UART で RP2040 の再起動に気づいたら（`ALIVE` の番号が 0 に戻る、`HELLO` を送り直す）、同じ unbind / bind をする
- [ ] RMK のレポートの行き先に、USB と並べて HID over I²C を足す仕組み（RMK の改造か、上流への提案）
- [ ] Vial を有効にする（RMK の `vial` と `storage`。PC への USB HID を作るときに合わせて。[design-decisions.md](design-decisions.md) の 3 章）。キーマップのフラッシュの領域と、Vial 用の JSON（`VIAL_JSON_PATH`）
- [ ] キーボードモードのトラックパッド：UI の Pad タブ（指の判定、スクロールの帯、L / M / R）、UART の `PTR` / `WHEEL`、RP2040 のマウスのレポート（HID over I²C のレポート ID 3）は試作した。残り：実機のタッチパネルでのマルチタッチの確認と、速さ・加速・スクロールの量の調整、PC への USB HID、オートマウスレイヤーを使うか、トラックパッドを出力先が PC のときだけにするか
- [ ] キーの RGB の明るさの上限（電流宣言ごと。全点灯で約 1.5 A）を実測で決める
- [ ] CC の判定の時間の扱い（[design-decisions.md](design-decisions.md) の 2.3 には電圧の範囲しか決めていない）。数値は USB Type-C の規格のもの
  - **つないだとき：** 相手は Rp を出してから最大 275 ms で VBUS を出す（tVBUSON）。相手が DRP なら、役割が決まるまで Rp が点いたり消えたりする。CC が 100〜200 ms 安定してから判定する（tCCDebounce）。RP2040 には VBUS を直接見る線がない。B は `PWR_ST` で間接的にわかるが、B から給電しているときに A の VBUS があるかは見えない
  - **抜いたとき：** Rp はすぐ消えるが、VBUS はコンデンサのぶん遅れて下がる。CC が 10〜20 ms 消えたら抜けたとみなす（tPDDebounce）
  - **つないだまま宣言が下がったとき**（PC が 3 A から 1.5 A に下げるなど）：受ける側は 60 ms 以内に電流を減らす（tSinkAdj）。下げる判定は速く、上げる判定はゆっくりにする
  - Rp を VBUS から取っている安い充電器や変換ケーブル（56 kΩ）では、VBUS の立ち上がりや電圧の落ち込みにつれて CC の電圧も動く。判定がふらつかないよう、範囲の境目にヒステリシスを持たせる
  - 起動したときは CM0 も LCD も初期状態が OFF なので、判定が済むまで待てば安全側に倒れる。危ないのは、動いている最中の変化（上の 3 つ目と、今より弱い電源を B につないだとき）
  - 今より弱い電源を B につないだときは、CC_B を見て先回りで負荷を落とすと決めた（[design-decisions.md](design-decisions.md) の 2.4）。USB-A → C の変換ケーブルで、後追いの対処（`PWR_ST` の割り込みで LCD を切る）が間に合うかを実物で確かめる
- [ ] CM0 の USB ブート要求のキーの組み合わせ（SW102 の代わり）
- [ ] タッチ UI の試作（LVGL、[software/ui/](../software/ui/)）を実機で確かめる：パネルとタッチの向き、描き換えの速さと CPU の負荷、バックライトのデバイス
- [ ] タッチキー（Keys タブ、2 段 × 12 キー。[design-decisions.md](design-decisions.md) の 4 章）の使い勝手：実物の画面で 18.32 mm のピッチと、外側の列のずれ（約 4 mm）が気にならないか。レイヤー 1・2 のタッチキーの割り当て（いまは仮）
- [ ] Vial でタッチキーを変えられるようにする：Vial 用の JSON に 7〜10 行目を 2 段 × 12 キーとして並べる、Vial で変えたあとに `TKL` を送り直す
- [ ] Widget strip（Keys タブの、ヘッダーとタッチキーの間の 1920 × 80 px。[design-decisions.md](design-decisions.md) の 4 章）。ポモドーロ・タイマー、ニュースの電光掲示板、打鍵の速さ、天気は試作した。残り：
  - **次の予定**（カレンダー）：連携の仕掛けを決める。候補は、iCal（.ics）の URL を取ってくる道具（ニュースや天気と同じく、ファイルに書いて UI が読む）、Google カレンダーの API（認証が要る）、PC 側から送る、など。非公開の予定の URL や認証情報をどこに置くか（リポジトリには入れない）も決める
  - 天気：場所はウィジェットの一覧から選べるようにした（2026-11-10）。一覧にない場所を画面で入れるか（いまは `ui.conf` に書く）。打鍵の速さ：今日の打鍵数を、UI を起動し直しても残すか
  - microSD の音楽の再生（再生・止める・次の曲、曲名の表示。音は TLV320DAC3100。曲を置く場所は、データのパーティション）
  - ポモドーロ：時間（25 / 5 / 15 分）を変えられるようにするか、終わったときに音も鳴らすか、Keys 以外のタブにいるときに残り時間をヘッダーにも出すか
  - ニュース：ジャンルはウィジェットの一覧から選べるようにした（2026-11-10）。一覧にない RSS を画面で足すか（いまは `fetch_news.py --feed <URL>`）。ルートを読み取り専用にしたあと、news.txt をデータのパーティションに置く。実機に IPA ゴシック（`fonts-ipafont-gothic`）を入れるのを、OS のイメージを作る手順に入れる。CM0 で日本語のフォントを丸ごと読むメモリ（IPA ゴシックで約 6 MB）と、字を描く重さ
  - 実機のタッチパネルでのスワイプの具合（`widgets.c` の `SWIPE_START` / `SWIPE_MIN`）と、電光掲示板を流し続けたときの CPU の負荷
- [ ] 隠し機能の動画（UI の時計を 5 回叩く）を実機で確かめる：CM0 で 30 fps で描けるか（640 × 480 を回して描く）、音とコマのずれ（aplay が鳴り始めるまでの遅れ）、キーのライトの向きと順番（LED の数珠つなぎの順は基板から求めた）、明るさの上限（いまは 1 色 48/255）
- [ ] 背景の画像と半透明のボタン（試し。UI の System タブの Look）を続けるか：実機で描き換えの速さを見て決める。続けるなら、画像の選び方（UI から選ぶ、など）
- [ ] 透過キーの表示：UI には一番上のレイヤーしか届かないので、透過キーは「今のレイヤー → レイヤー 0」の順に見ている。レイヤーを 2 つ以上重ねる使い方をするなら、有効なレイヤーの一覧を送る
- [ ] CM0 と RP2040 の間の UART の形式は案を書いた（[protocol.md](protocol.md) の 1 章）。CM0 側（UI）と RP2040 側（`cm0_link.rs`）の試作がある。2026-11-12、XIAO RP2040 と Pi 4B で、`HELLO` から状態（`USB`、`OUT`、`LAYER`）のやり取りまで通じた（RP2040 が「PC がない」と言い続ける不具合を直した：USB の接続前に来たサスペンドの記録が残っていた）。タッチキー（`TK`）、`ACT`（Typing の打鍵数）、モードの切り替え（Open console で `OUT,CM0`）も通じた。出力レポート（Caps Lock の LED）も届いた。`USER` と Consumer Control（音量キー）は、XIAO ではレイヤー 2 のキーが押せないので未確認。`PWR` と、シャットダウンの依頼（I²C の電源キー）を出すきっかけは、CC と電源の判定を作るときに足す
  - **モードの決め方を作り直した（2026-11-12）：** Open console で UI が閉じて `ALIVE` が止まると、3 秒後にキーボードモードに戻ってしまう穴があった。RP2040 がモードを決め、「UI が出ているか（`HELLO` / `ALIVE` / `BYE`）」と「CM0 のカーネルが I²C を読みに来るか」から送り先を決める形にした（[protocol.md](protocol.md) の 2.6）。実機で確かめること：Open console ですぐコンソールにキーが行くか、UI が落ちても PC へのキーが途切れないか、UI が落ち続けたらコンソールに移るか、Pi で `systemctl kill` で UI を固めたとき、ウォッチドッグで起動し直すか、`KEY_POWER` で `poweroff` するか（systemd-logind が i2c-hid のキーボードを電源キーとして見るか）。UI の起動時間は Zero 2 W で約 0.9 秒（落ちてから戻るまで約 2 秒）だったので、UI がいないとみなすまでを 3 秒にした
- [ ] CM0 のウォッチドッグ（「動作中」の信号が途絶えたときの扱い）
- [ ] いきなりの電源断への備えの細部（方針は [design-decisions.md](design-decisions.md) の 1.5）：パーティションの分け方と容量、Overlay File System の設定、データの領域を書き込みにする・戻す仕組み、書き込み中の表示、OS の更新を Port B の給電があるときだけにする仕組み
