hringdrifi/skjar/docs/protocol.md

# RP2040 ↔ CM0 通信仕様

RP2040 と CM0 の間のやり取りを、ここに1か所だけ定義する。RP2040 のファームウェアと CM0 のソフトウェアは、どちらもこの文書に従う。

| 経路 | 線 | 使い道 |
|---|---|---|
| UART | `RP_TXD` / `CM0_TXD`（CM0 の GPIO15 / 14） | 状態のやり取り、タッチキー、コンソール（1 章） |
| HID over I²C | `KB_SDA` / `KB_SCL` / `KB_INT`（CM0 の GPIO23 / 24 / 25） | 物理キーを CM0 の Linux に渡す（2 章） |

詳しい背景は [design-decisions.md](design-decisions.md) の「3. RP2040 ↔ CM0 の接続」を参照。

---

## 1. UART

**形式は案（2026-11-09）。** CM0 側は [software/ui/](../software/ui/)、RP2040 側は [firmware/rp2040/](../firmware/rp2040/)（`cm0_link.rs`）の試作が使っている。どちらも実機では未確認。

### 決まっているやり取り

| 方向 | 内容 |
|---|---|
| CM0 → RP2040 | タッチキーの入力（RP2040 が HID として PC に送る） |
| CM0 → RP2040 | 「動作中」の定期的な通知（途絶えたときの扱いは未定） |
| RP2040 → CM0 | シャットダウンの要求 |
| RP2040 → CM0 | 1.5 A のときのバックライトの上限値 |
| RP2040 → CM0 | 電源の状態（使用中のポート、電流宣言） |
| CM0 → RP2040 | LCD の電源を切る依頼（長時間の待機時など） |
| CM0 → RP2040 | RP2040 を UF2 の書き込みモードで再起動する要求 |

- 物理キーの入力は UART では送らない（2 章の HID over I²C で送る）。
- CM0 の起動の早い段階のログ（コンソール）も、この UART に出る。やり取りの形式は、ログが混ざっても読み飛ばせるように決める。

### 1.1 線の設定

- 115200 bps、8N1、フロー制御なし。CM0 側は mini UART（`/dev/serial0` → `ttyS0`）。PL011 は Bluetooth が使う。
- CM0 のカーネルのログ（`console=serial0,115200`）は残す。シリアルのログイン（`serial-getty@ttyS0`）は止めて、UART は UI（`skjar-ui`）が開く。
- カーネルのログは UI の書き込みの途中にも割り込みうる。そのため、どちらの向きも、下の形の行だけを読み、それ以外の行と、壊れた行は捨てる。

### 1.2 行の形

```
$SK,<コマンド>[,<引数>...]*<CRC>\n
```

- ASCII の 1 行で 1 メッセージ。`\r` は無視する。1 行は 64 バイトまで。
- 受ける側は、行の中の最後の `$SK,` から読む（ログが改行なしで前に付いても拾えるように）。
- `<CRC>`：`$` の次から `*` の前まで（`SK,` を含む）の CRC-8（多項式 0x07、初期値 0x00、反転なし）を、16 進の大文字 2 桁で書く。
- 数値は、特に書かないかぎり 10 進。HID の使用法のページとコードは 16 進（`0x` を付けない）。
- 知らないコマンドは捨てる（新しいコマンドを足しても、古い相手が止まらないように）。
- 例：`$SK,ALIVE,0*3E`、`$SK,KEY,07,1E,1*9B`（タッチキーの「1」を押した）。CRC の確認値は、`123456789` で 0xF4。

### 1.3 CM0 → RP2040

| コマンド | 引数 | 内容 |
|---|---|---|
| `HELLO` | — | UI が起動した（RP2040 とつながり直したときも送る）。RP2040 は UI が出ているとみなし（2.6）、今の状態（`PWR`、`BLMAX`、`USB`、`OUT`、`TKL`、`LAYER`）をすべて送り直し、押されたままのタッチキーをすべて離す。`OUT` が返事になる：`PC` なら UI のまま、`CM0`（PC がない）なら、電源を入れたときの UI は閉じてコンソールへ、手で起動した UI は「PC につないで」を出す |
| `ALIVE` | `<seq>`（0〜255、毎回 1 増やす） | UI が動いている。1 秒ごと。**UI だけが送る**（コンソールの間は誰も送らない）。RP2040 は 3 秒途絶えたらタッチキーとボタンを離し、UI がいないとみなす（2.6） |
| `BYE` | — | UI を閉じる（Open console）。RP2040 は `ALIVE` の途切れを待たずに、UI がいないとみなす。届かなくても、`ALIVE` が途切れれば同じことになる（速くするためだけ） |
| `TK` | `<index>,<1 か 0>` | 画面のタッチキー（Keys タブの 2 段 × 12 キー）を押した（1）・離した（0）。`index` は 0〜23（上の段が 0〜11、下の段が 12〜23、どちらも左から）。RP2040 は、キーマップの 7 + index / 6 行目、index % 6 列目のキーとして RMK に渡す（レイヤーと Vial が効く） |
| `KEY` | `<page>,<usage>,<1 か 0>` | 割り当てが固定のキー（Media タブのボタン）を押した（1）・離した（0）。`page` は `07`（キーボード。修飾キーは E0〜E7）か `0C`（Consumer） |
| `LEDF` | `<42 文字の 16 進>` | キーのライトの 1 コマ（隠し機能の動画と、ポモドーロの区切りの点滅）。1 文字が 1 キーの明るさ 0〜15 で、キーの順は RMK のマトリクスの 行 × 6 ＋ 列。30 回 / 秒ほど送る（1 行 55 バイト、約 1.7 KB / 秒）。RP2040 は白で光らせ、0.3 秒届かなければ消して LED の電源を切る |
| `PTR` | `<dx>,<dy>,<buttons>` | トラックパッドの動きとボタン。`dx` / `dy` は −127〜127 の相対値（右・下が正）。`buttons` はビット 0 が左、1 が右、2 が中のボタンで、押している間ずっと立てる |
| `WHEEL` | `<v>,<h>` | スクロール（−127〜127）。`v` は正で上へ、`h` は正で右へ（HID のマウスのホイールと AC Pan と同じ向き） |
| `LCD` | `0` / `1` | LCD の電源を切る・入れる依頼 |
| `UF2` | — | RP2040 を UF2 の書き込みモードで再起動する |

- タッチキーは、物理キーの出力先にかかわらず、いつも UART で RP2040 に送る。RP2040 は、物理キーと同じ出力先（PC の USB HID か、CM0 への HID over I²C）に出す。
- トラックパッド（`PTR`、`WHEEL`）も同じ。RP2040 はマウスのレポートにして、物理キーと同じ出力先に出す。`HELLO` を受けたときと、`ALIVE` が 3 秒途絶えたときは、ボタンをすべて離す。
- 指の動きの判定（1 本指で移動、叩いて左クリック、2 本指でスクロール、2 本指で叩いて右クリックなど）は CM0 の UI がする。RP2040 は届いた値をそのまま出すだけ。

### 1.4 RP2040 → CM0

| コマンド | 引数 | 内容 |
|---|---|---|
| `ALIVE` | `<seq>`（0〜255） | 動作中の通知。1 秒ごと。CM0 は 3 秒途絶えたら、RP2040 とつながっていないものとして、状態の表示を消す |
| `PWR` | `<A か B>,<3A / 1.5A / DEF>` | 使用中のポートと、その電流宣言 |
| `BLMAX` | `<0〜255>` | バックライトの上限（255 で上限なし。1.5 A のとき下げる。2.4） |
| `USB` | `<1 か 0>` | PC につながっているか（PC の USB に認識されていて、スリープしていない）。変わったときと `HELLO` を受けたときに送る。UI は 0 なら「PC につないで」を出す |
| `OUT` | `<PC / CM0>` | キーとトラックパッドの今の送り先。`PC` がキーボードモード（Port A の USB HID）、`CM0` がサイバーデックモード（HID over I²C）。決めるのは RP2040（2.6）。変わったときと `HELLO` を受けたときに送る |
| `LAYER` | `<n>` | RMK の今のレイヤー（有効なレイヤーのうち一番上） |
| `TKL` | `<layer>,<index>,<code>` | タッチキー `index` の、レイヤー `layer` での割り当て。`HELLO` を受けたときに、すべてのレイヤー・すべてのタッチキーの分を送る（Vial でキーマップを変えたあとも送り直す予定）。`code` は下の表 |
| `USER` | `<n>,<1 か 0>` | Vial の USER キー（RMK の `User(n)`）を押した・離した。UI は USER0〜3 で Keys / Pad / Media / System のタブを開く |
| `ACT` | — | 文字や機能のキー（修飾キー、レイヤーキー、USER キー、メディアキー、マウスキー以外）が押された。UI は設定によって元のタブに戻る。続けて押されたぶんは 1 回にまとめる |
| （`SHUTDOWN`） | — | 使わない（2026-11-12）。シャットダウンの依頼は、UART ではなく HID over I²C の電源キー（Consumer の Power、Linux の `KEY_POWER`）で出す。UI がいない（コンソールの）間も、カーネルが動いていれば systemd-logind が `poweroff` する。終わると `CM0_HALT`（GPIO26）が High になる |

`TKL` の `code`（キーの動作。UI がキーの表示にする。software/ui/src/keylabel.c）：

| 形 | 内容 |
|---|---|
| `K<hh>` | キー（RMK の `HidKeyCode` の 16 進。0x04〜0xE7 は HID の使用法と同じ、0xA5〜0xBE はシステム・メディア） |
| `K<hh>+<mm>` | 修飾キー付きのキー（`mm` は修飾キーのビット。ビット 0 が LCtrl … 7 が RGui） |
| `C<hhh>` / `S<hh>` | Consumer / System Control |
| `M<mm>` | 修飾キーだけ |
| `L<n>` / `G<n>` / `D<n>` / `O<n>` | レイヤー（押している間 / 切り替え / 既定 / 1 回だけ） |
| `U<n>` | USER キー |
| `<tap>/<hold>` | タップとホールドで違う動作（例：`K2C/L1` はタップでスペース、長押しでレイヤー 1） |
| `-` / `T` / `?` | 何もしない / 透過（下のレイヤーを見る） / 表示できない種類 |

---

## 2. キー入力（HID over I²C）

RP2040 が I²C の HID デバイス（ターゲット）になり、CM0 の Linux は標準の `i2c-hid` ドライバで普通のキーボードとして扱う。プロトコルは Microsoft の「HID over I2C Protocol Specification」v1.0 に従う。

### 2.1 バス

| 項目 | 内容 |
|---|---|
| CM0 側 | `i2c-gpio`（ソフトウェアの I²C）。SDA = GPIO23、SCL = GPIO24（標準のオーバーレイの初期値）。速度は約 100 kHz |
| RP2040 側 | I2C0 のターゲット。SDA = GPIO24、SCL = GPIO25 |
| 割り込み | `KB_INT`：RP2040 の GPIO13 → CM0 の GPIO25。**Low で通知**（レベル） |
| プルアップ | `KB_SDA` / `KB_SCL` は 4.7 kΩ、`KB_INT` は 10 kΩ。どれも `+3V3_CM0` へ |
| I²C のアドレス | **0x2C**（試作の値）。このバスには RP2040 しかいないので、自由に決めてよい |

- **`i2c-gpio` にする理由：** Raspberry Pi の I²C ハードウェアはクロックストレッチに正しく対応しておらず、ターゲットの RP2040 は読み出しのたびに SCL を引き延ばすため。
- **帯域：** 入力レポート 1 回は 11 バイト程度（長さ 2 ＋ レポート ID 1 ＋ キーボード 8）で、100 kHz で約 1 ms。キー入力には十分。

### 2.2 RP2040 のピンの約束（CM0 に電流を流し込まないため）

CM0 が OFF のときは `+3V3_CM0` が 0 V になり、3 本とも 0 V になる。RP2040 は常に電源が入っているので、次を守る。

- **High を出さない。** I²C はもともとオープンドレイン。`KB_INT` も、出力値を 0 に固定し、出力の有効・無効を切り替えてオープンドレインを真似る（RP2040 には本物のオープンドレインがない）。
- **内部プルアップを使わない。** pico-sdk のサンプルにある `gpio_pull_up()` を真似しない。リセット直後の初期設定のプルダウンも切る。

### 2.3 レジスタ

HID ディスクリプタのレジスタの番地だけを、デバイスツリーの `hid-descr-addr` で Linux に伝える。ほかのレジスタの番地は、HID ディスクリプタの中で RP2040 が決める。CM0 は 2 バイト（リトルエンディアン）の番地を書いてから、続けて読む。

| レジスタ | 内容 |
|---|---|
| HID ディスクリプタ | 30 バイト。各レジスタの番地、レポートディスクリプタの長さ、最大の入力 / 出力の長さ、VID / PID |
| レポートディスクリプタ | HID のレポートの定義（2.4） |
| 入力 | CM0 が番地なしで読むと、先頭 2 バイトの長さに続いて入力レポートが返る |
| 出力 | CM0 から出力レポート（LED の状態）を受け取る |
| コマンド / データ | `RESET`、`SET_POWER`、`GET_REPORT`、`SET_REPORT` |

試作では次の番地にしている（[firmware/rp2040/src/hid_i2c.rs](../firmware/rp2040/src/hid_i2c.rs)）。

| レジスタ | 番地 |
|---|---|
| HID ディスクリプタ | 0x0001 |
| レポートディスクリプタ | 0x0002 |
| 入力 | 0x0003 |
| 出力 | 0x0004 |
| コマンド | 0x0005 |
| データ | 0x0006 |

- 最大の入力の長さは 11 バイト、最大の出力の長さは 4 バイト（長さ 2 ＋ レポート ID 1 ＋ LED 1）。
- VID / PID は、試作では pid.codes のテスト用（0x1209 / 0x0001）。製品の値は未定。

### 2.4 レポート（案）

| レポート ID | 向き | 内容 |
|---|---|---|
| 1 | 入力 | キーボード（修飾キー 1 バイト、予約 1 バイト、キー 6 個） |
| 1 | 出力 | キーボードの LED（Num / Caps / Scroll Lock など）。キーの RGB で表示できる |
| 2 | 入力 | Consumer Control（音量、メディア操作など） |
| 3 | 入力 | マウス（ボタン 5 個、X、Y、ホイール、AC Pan。どれも −127〜127 の相対値）。トラックパッド（1 章の `PTR` / `WHEEL`）と RMK のマウスキー |

### 2.5 動作の流れ

1. **CM0 が OFF のとき**（`CM0_RUN_PG` が Low）：I²C のターゲットを止め、`KB_INT` は離しておく（Low に引かない）。たまったキー入力は捨てる。
2. **CM0 が起動したとき：** Linux が `SET_POWER`（ON）と `RESET` を送る。RP2040 は `RESET` を受けたら `KB_INT` を Low にし、長さ 0 の入力（2 バイトとも 0）を返す。RP2040 は `RESET` を待たずに入力を積む（RP2040 だけが再起動したとき、i2c-hid は `RESET` を送り直さないため。2026-11-12）。Linux の起動時は、`RESET` で積んだものを捨てる。
3. **キーを押したとき：** RP2040 が入力レポートを用意して `KB_INT` を Low にする。CM0 が入力レジスタを読んだら、次のレポートがなければ `KB_INT` を離す。RP2040 は、CM0 が最後に読み切った時刻を覚えておく（カーネルが生きているかの目安。2.6）。
4. **出力レポート**（Caps Lock などの LED）を受けたら、キーの RGB に反映する。
5. **CM0 が止まるとき：** シャットダウンや再起動のとき、i2c-hid が `SET_POWER`（SLEEP）を送ってくる。RP2040 は止まる途中とみなし、積むのをやめる。止まり終わったら（`CM0_HALT` か `CM0_RUN_PG` の変化）1 に戻る。
6. **シャットダウンの依頼：** RP2040 は電源キー（Consumer の Power、0x30。Linux の `KEY_POWER`）を押して離したことにする。systemd-logind が `poweroff` する。

### 2.6 キーの送り先（モード）

物理キー・タッチキー・トラックパッドは、PC（Port A の USB HID）か CM0（この章の HID over I²C）のどちらかに送る。どちらに送っていても、UART（1 章）は状態のやり取りとタッチキーに使う。

| モード | 送り先 | 画面（tty1） | キーマップ |
|---|---|---|---|
| キーボードモード | PC（USB HID） | タッチ UI | レイヤー 0〜2 |
| サイバーデックモード | CM0（HID over I²C） | コンソール | レイヤー 3〜5 |

**決めるのは RP2040**（2026-11-12）。いつも電源が入っていて、UI や CM0 が落ちても動き続けるため。Linux 側は、画面を変える操作（Open console、`skjar`）と、UI が出ていることの知らせ（`HELLO` / `ALIVE` / `BYE`）だけを送る。一度きりの依頼で切り替えるのではなく、「UI が出ているか」という続いている信号から決めるので、行が届かなくても、ずれたまま残らない。

**決まり（RP2040）：**

| 状態 | 送り先 |
|---|---|
| UI が出ている（`HELLO` か `ALIVE` を受けて、まだ `BYE` も 3 秒の途切れもない） | PC があれば USB、なければ I²C（UI は「PC につないで」を出している） |
| UI がいない（`BYE` を受けた、`ALIVE` が 3 秒途切れた）、CM0 のカーネルが生きている | I²C（コンソール） |
| UI がいない、カーネルが生きていない（CM0 の電源 OFF・起動中・止まる途中・固まった） | PC があれば USB、なければ I²C |

- **カーネルが生きているか：** UI がいない間だけ、RP2040 は 2 秒ごとに、今と同じ内容のキーボードのレポートを I²C に置く（キーの状態は変わらないので、Linux では何も起きない）。i2c-hid が 6 秒以内に読みに来れば生きている。`SET_POWER`（SLEEP）を受けたあと（止まる途中）は、生きていないとみなす。
- **3 秒（`UI_TIMEOUT`）：** UI が落ちて systemd が起動し直す（`RestartSec=1` ＋ UI の起動）より長くする。その間は USB のままなので、PC で打っているキーは途切れない。Zero 2 W（CM0 と同じ SoC）で、UI の起動は約 0.9 秒（うち背景の絵が 0.7 秒）、落ちてから戻るまで約 2 秒だった（2026-11-12）。押されたままのタッチキーとボタンも、同じ 3 秒で離す。
- **`BYE`：** Open console で UI を閉じるとき、3 秒を待たずにすぐ切り替えるためだけに送る。届かなくても、3 秒後には同じになる。
- **`HELLO` の返事（`OUT`）：** PC があれば `OUT,PC`。なければ `OUT,CM0` で、電源を入れたときの UI（`skjar-ui@boot`）は閉じてコンソールへ移り（`BYE` を送る）、手で起動した UI（`skjar`）は「PC につないで」を出して残る。
- **キーマップ：** RMK の「既定のレイヤー」を送り先に合わせる。USB ならキーボードモードの 0、I²C ならサイバーデックモードの 3。RP2040 は、キーマップの 11 行目（マトリクスにない行）に置いた `DF(0)` / `DF(3)` のキーを押したことにして切り替える。既定のレイヤーより下のレイヤーは効かないので、2 つのキーマップは混ざらない。どちらも Vial で変えられる。
- **切り替えるとき**は、元の送り先に「全部離した」を送ってから、新しい送り先に今の状態を送り直す。
- **PC がつながっているか**は、USB の状態（認識された・スリープした・リセットされた）で見て、UART の `USB` で UI に知らせる。本番では、Port A の CC の電圧で、何かが挿さっているかも見る（挿さっていないときは USB を有効にしない）。
- 表示：今の送り先は、タッチ画面のヘッダーの札で示す。キーの RGB で示すかは未定。

**場合ごとの動き：**

| 場合 | 動き |
|---|---|
| 電源を入れた、Port A に PC | CM0 の起動中も、物理キーは PC で使える。UI が `HELLO` → `OUT,PC` → UI のまま |
| 電源を入れた、PC なし | UI が `HELLO` → `OUT,CM0` → UI を閉じてコンソール |
| キーボードモードで PC を抜いた | I²C になる。UI は「PC につないで」と Open console を出す |
| Open console | UI が `BYE` → すぐ I²C → UI が閉じて getty |
| コンソールで `skjar` | UI が `HELLO` → PC があれば `OUT,PC` ですぐ USB |
| UI が落ちた | systemd が 1 秒後に起動し直す。3 秒以内に `HELLO` が来るので、USB のまま。画面にはコンソールが一瞬出る |
| UI が落ち続けた | systemd が 60 秒に 5 回で諦め、コンソールが残る → 3 秒後に I²C（画面と揃う）。`skjar` で再挑戦できる |
| UI が固まった | 3 秒後に I²C。systemd のウォッチドッグ（`WatchdogSec=5`）が止めて起動し直す |
| CM0 が固まった | カーネルが読みに来ないので、PC があれば USB。CM0 は自分のハードウェアのウォッチドッグで再起動する。本番では、RP2040 も CM0 の電源を入れ直す（下） |
| シャットダウン（`poweroff`、UI の Power off、電源が弱いときの電源キー） | i2c-hid の `SET_POWER`（SLEEP）で止まる途中と分かる。PC があれば USB |
| RP2040 だけが再起動した | `RESET` を待たずに I²C を送れるので、キーはすぐ効く。UI が出ていれば `ALIVE` で USB、コンソールならカーネルが読みに来るので I²C |

**CM0 の電源を入れ直す（本番。試作は線がないので、ログに出すだけ）：**
- 動いていた CM0 が固まった：UI がいない状態で確かめ始めてから 6 秒、カーネルが一度も読みに来ない（止まる途中ではない）。
- 起動の途中で止まった：RP2040 が自分で CM0 の電源を入れてから 2 分たっても、カーネルが読みに来ない。RP2040 だけが再起動した（CM0 の電源を入れていない）ときは見ない。
- 入れ直しは 3 回まで（1 回目はすぐ、2 回目は 1 分後、3 回目は 5 分後）。それでも戻らなければ、CM0 の電源を切ったままにし、キーボードとしてだけ動かす（キーの光で知らせる）。回数は、CM0 が `ALIVE` を送ってきたら（正常に戻ったら）0 に戻す。

### 2.7 CM0 側の設定

`i2c-gpio` のバスの下に、`hid-over-i2c` のデバイスを定義するオーバーレイ（[skjar-keyboard-overlay.dts](../software/os/overlays/skjar-keyboard-overlay.dts)）。

```dts
keyboard@2c {
	compatible = "hid-over-i2c";
	reg = <0x2c>;                  /* I²C のアドレス */
	hid-descr-addr = <0x0001>;     /* HID ディスクリプタのレジスタの番地 */
	interrupt-parent = <&gpio>;
	interrupts = <25 8>;           /* GPIO25、IRQ_TYPE_LEVEL_LOW */
};
```
