hringdrifi/skjar/docs/pin-assignment.md

# ピンの割り当てとシート間の信号

回路図を描くための叩き台（2026-10-30）。基板の配置を決めるときに、配線が素直になるよう入れ替える可能性がある。

決めた理由は [design-decisions.md](design-decisions.md) を参照。

---

## 1. 電源のネット

| ネット名 | 作るところ | 内容 | 使うところ |
|---|---|---|---|
| `VBUS_A` / `VBUS_B` | power | 各 USB-C の VBUS | power（TPS2121 の IN2 / IN1） |
| `+5V` | power | TPS2121 の出力。常に入っている 5V | 全シート |
| `+5V_LCD` | power | LCD 用の負荷スイッチ（TPS22965）の出力 | display |
| `+5V_LED` | keymatrix | キーの RGB 用。`+5V` を P-MOSFET（AO3401A）で切った出力 | keymatrix のみ |
| `+3V3` | power | `+5V` から作る常時 ON の 3.3V（RP2040 用のレギュレータ） | rp2040、peripherals（RTC の電源の片側）、プルアップ |
| `+3V3_CM0` | cm0 | CM0 の 3.3V 出力。CM0 が OFF のときは 0V | cm0（GPIO_VREF、UART のバッファ）、display（FPC の 3V3） |
| `VBAT` | peripherals | CR2032 | peripherals のみ |

---

## 2. シート間の信号（グローバルラベル）

回路図では、シートをまたぐ信号はグローバルラベル、`+5V` / `+3V3` / GND は電源記号、シートの中だけのネットはローカルラベルで扱う。グローバルラベルは、各シートの中でネットごとに最低1つ残す（同じシートの中のピン同士は線でつないでよい）。

| 信号名 | 出す側 → 受ける側 | 内容 |
|---|---|---|
| `USB_A_D+` / `USB_A_D-` | power → rp2040 | Port A の USB（Full Speed） |
| `USB_B_D+` / `USB_B_D-` | power → cm0 | Port B の USB（High Speed、90 Ω 差動） |
| `CC1_A` / `CC2_A` / `CC1_B` / `CC2_B` | power → rp2040 | 各ポートの CC の電圧（ADC で読む） |
| `PWR_ST` | power → rp2040 | TPS2121 の ST（High：Port B から給電、Low：Port A から給電） |
| `LCD_EN` | rp2040 → power | LCD 用の負荷スイッチの ON。プルダウンして初期状態は OFF |
| `CM0_PWROFF` | rp2040 → cm0 | GLOBAL_EN を Low に引く N-MOSFET のゲート。**High で CM0 が OFF**。プルアップして初期状態は OFF |
| `BOOT_EN` | rp2040 → cm0 | CM0 の USB ブート要求。cm0 シートの N-MOSFET（Q202）で nRPI_BOOT を Low に引く。要求はキーの組み合わせで出す |
| `RP_TXD` | rp2040 → cm0 | RP2040 の UART TX。cm0 シートのバッファ（SN74LVC1G125、+3V3_CM0 で動作）を通して CM0 の GPIO15 へ |
| `CM0_TXD` | cm0 → rp2040 | CM0 の GPIO14 → RP2040 の UART RX |
| `CM0_RUN_PG` | cm0 → rp2040 | CM0 の RUN_PG（電源正常、CPU 動作中） |
| `CM0_HALT` | cm0 → rp2040 | シャットダウン完了の通知（CM0 の `gpio-poweroff`） |
| `DSI_D0_P/N` 〜 `DSI_D3_P/N`、`DSI_CK_P/N` | cm0 → display | DSI（4レーン分を配線。100 Ω 差動） |
| `I2C_DSI_SDA` / `I2C_DSI_SCL` | cm0 ↔ display | パネルのタッチとバックライト（CM0 の SDA0 / SCL0） |
| `I2C1_SDA` / `I2C1_SCL` | cm0 ↔ peripherals | RTC と音声 IC（TLV320DAC3100、0x18） |
| `RTC_INT` | peripherals → cm0 | RTC の割り込み（アラーム） |
| `I2S_BCLK` / `I2S_LRCLK` | peripherals → cm0 | I²S のクロック。TLV320DAC3100 が 12 MHz の MCLK から作って出す（コーデックがマスター） |
| `I2S_DOUT` | cm0 → peripherals | TLV320DAC3100 へのデジタル音声 |
| `CODEC_RST` | cm0 → peripherals | TLV320DAC3100 のリセット（Low でリセット。100 kΩ でプルダウン） |
| `HP_DET` | peripherals → cm0 | イヤホンの検出（Low で挿入。100 kΩ で `+3V3_CM0` にプルアップ） |
| `KB_SDA` / `KB_SCL` | rp2040 ↔ cm0 | キー入力の I²C（HID over I²C。CM0 側は `i2c-gpio`。4.7 kΩ で `+3V3_CM0` にプルアップ） |
| `KB_INT` | rp2040 → cm0 | キー入力の割り込み（Low で通知。10 kΩ で `+3V3_CM0` にプルアップ） |
| `ROW0`〜`ROW6`、`COL0`〜`COL5` | rp2040 ↔ keymatrix | キーマトリクス（7 行 × 6 列 ＝ 42 キー、13 本） |
| `RGB_DATA` | rp2040 → keymatrix | キーの RGB（SK6812MINI-E）のデータ。keymatrix シートのバッファ（SN74AHCT1G125、`+5V_LED` で動作）で 5 V にする |
| `RGB_EN` | rp2040 → keymatrix | キーの RGB の電源（`+5V_LED`）の ON。High で ON。プルダウンして初期状態は OFF |

---

## 3. RP2040 の GPIO

| GPIO | 信号 | 方向 | 備考 |
|---|---|---|---|
| 0 | `COL5` | 出力 | キーマトリクスの列 |
| 1 | `COL4` | 出力 | キーマトリクスの列 |
| 2 | `COL3` | 出力 | キーマトリクスの列 |
| 3 | `COL2` | 出力 | キーマトリクスの列 |
| 4 | `COL0` | 出力 | キーマトリクスの列 |
| 5 | `COL1` | 出力 | キーマトリクスの列 |
| 6 | `ROW1` | 入力（プルダウン） | キーマトリクスの行 |
| 7 | `ROW3` | 入力（プルダウン） | キーマトリクスの行 |
| 8 | `ROW5` | 入力（プルダウン） | キーマトリクスの行 |
| 9 | `ROW6` | 入力（プルダウン） | キーマトリクスの行 |
| 10 | `ROW0` | 入力（プルダウン） | キーマトリクスの行 |
| 11 | `ROW2` | 入力（プルダウン） | キーマトリクスの行 |
| 12 | `ROW4` | 入力（プルダウン） | キーマトリクスの行 |
| 13 | `KB_INT` | 出力（オープンドレイン） | Low で CM0 にキー入力を知らせる |
| 14 | `RGB_DATA` | 出力 | キーの RGB のデータ（PIO） |
| 15 | `CM0_PWROFF` | 出力 | High で CM0 が OFF |
| 16 | `RP_TXD` | 出力 | UART0 TX |
| 17 | `CM0_TXD` | 入力（**プルなし**） | UART0 RX |
| 18 | `LCD_EN` | 出力 | |
| 19 | `PWR_ST` | 入力（割り込み） | |
| 20 | `RGB_EN` | 出力 | High でキーの RGB の電源が ON |
| 21 | `CM0_RUN_PG` | 入力（**プルなし**） | |
| 22 | `CM0_HALT` | 入力（**プルなし**） | |
| 23 | `BOOT_EN` | 出力 | High で CM0 の nRPI_BOOT を Low に引く |
| 24 | `KB_SDA` | I2C0 SDA（ターゲット、**プルなし**） | HID over I²C |
| 25 | `KB_SCL` | I2C0 SCL（ターゲット、**プルなし**） | HID over I²C |
| 26 | `CC1_A` | ADC0 | |
| 27 | `CC2_A` | ADC1 | |
| 28 | `CC1_B` | ADC2 | |
| 29 | `CC2_B` | ADC3 | |

- **合計：** 30 / 30 本（予備なし）。GPIO20 は、CM0 の USB ブート要求のスイッチ（`BOOT_SW`）を廃止して空けた。
- **CM0 から来る信号はプルなしにする：** CM0 が OFF のときに、RP2040 から CM0 に電圧をかけないため。
- **キーマトリクスの並び：** 基板で配線しやすい順に GPIO0〜12 を割り当てた（2026-11-06）。番号の順にはなっていないので、ファームウェアのピン定義はこの表から取る。
- **キーマトリクスの向き：** RMK の COL2ROW は、列を順に High にして、行をプルダウンで読む（QMK の COL2ROW の逆）。ダイオードの向き（列 → 行）は同じ。
- **UART0：** TX / RX は GPIO16 / 17 を使う（RP2040 で UART0 を割り当てられるピンの組）。

---

## 4. CM0 の GPIO と専用ピン

| GPIO（ピン番号） | 信号 | 備考 |
|---|---|---|
| GPIO2（114）/ GPIO3（113） | `I2C1_SDA` / `I2C1_SCL` | RTC。CM0 の内部で 1.8 kΩ のプルアップあり |
| GPIO14（110） | `CM0_TXD` | UART の TX |
| GPIO15（108） | ← `RP_TXD` | UART の RX。バッファの出力を受ける |
| GPIO18（105） | `I2S_BCLK` | PCM_CLK（入力。コーデックから受ける） |
| GPIO19（79） | `I2S_LRCLK` | PCM_FS（入力。コーデックから受ける） |
| GPIO21（73） | `I2S_DOUT` | PCM_DOUT |
| GPIO17（107） | `HP_DET` | イヤホンの検出 |
| GPIO22（102） | `CODEC_RST` | 音声 IC のリセット |
| GPIO23（101）/ GPIO24（98） | `KB_SDA` / `KB_SCL` | `i2c-gpio`（標準のオーバーレイの初期値）。4.7 kΩ で `+3V3_CM0` にプルアップ |
| GPIO25（94） | `KB_INT` | キー入力の割り込み。10 kΩ で `+3V3_CM0` にプルアップ |
| GPIO26（76） | `CM0_HALT` | `gpio-poweroff` |
| GPIO27（104） | `RTC_INT` | |
| SDA0（42）/ SCL0（43） | `I2C_DSI_SDA` / `I2C_DSI_SCL` | GPIO44 / 45。内部で 1.8 kΩ のプルアップあり |
| DSI（2〜15） | `DSI_*` | |
| USB_P（36）/ USB_N（35） | `USB_B_D+` / `USB_B_D-` | |
| USB_OTG（38） | 未接続 | 内部でプルアップされ、デバイスとして動く |
| GLOBAL_EN（62） | ← N-MOSFET のドレイン | 内部で 10 kΩ を介して 5V にプルアップされている |
| RUN_PG（61） | `CM0_RUN_PG` | テストパッドも付ける |
| nRPI_BOOT（121） | ← N-MOSFET（Q202）のドレイン | 内部でプルアップあり。RP2040 の `BOOT_EN` で Low に引く |
| WiFi_ON（116）/ BT_ON（117） | 未接続 | 内部でプルアップされ、有効になる |
| LED_nACT（118） | テストパッド（または LED） | |
| GPIO_VREF（120） | `+3V3_CM0` | 3.3V の信号にする |
| SD_VREF（122） | `+3V3_CM0` | SD カードは 3.3 V の信号 |
| SD_CLK / SD_CMD / SD_DAT0〜3（124〜131） | microSD スロット（J201） | CM0Lite 専用。eMMC 版では使われない |
| GPIO0〜1、4〜13、16、20、23〜25 | 未使用 | テストパッドを付ける候補 |

---

## 5. 自作したシンボル（`hardware/pcb/lib/skjar.kicad_sym`）

| シンボル | ピン | 照合した資料 |
|---|---|---|
| `RaspberryPi_CM0` | 132（4ユニット：Power / Display/Camera / GPIO / System） | CM0 データシート Table 5 |
| `TPS2121RUX` | 12 | TPS2121 データシート 6章（RUX パッケージ） |
| `TPS22965DSG` | 9（8 ＋ 裏面の放熱パッド＝GND） | TPS22965 データシート 6章 |
| `TLV320DAC3100` | 33（32 ＋ 裏面の放熱パッド＝GND） | TLV320DAC3100 データシート（SLAS671C）の Pin Functions |

- **同じ名前のピンが複数ある場合：** 2本目以降を同じ位置に重ねて非表示にしている。
  - CM0：5V（67, 68）、CM0_3.3V（41, 119）、CM0_1.8V（64, 65）、GND（43本。データシートの Table 5 で確認済み。Power ユニットの下側）、NC（70, 71）
  - TPS2121：OUT（1, 8）
  - TPS22965：VIN（1, 2）、VOUT（7, 8）、GND（5, 9）
  - TLV320DAC3100：SPKVDD（21, 24）、SPKP（22, 26）、SPKM（19, 23）、SPKVSS（20, 25）
  - シンボルエディタでは、重ねたピンの番号が灰色で重なって表示される。
- **フットプリント：** TLV320DAC3100 は KiCad 標準の `Texas_RHB0032E_VQFN-32-1EP_5x5mm_P0.5mm_EP3.45x3.45mm` を設定済み。ほかは、回路図がある程度できてから用意する。
