hringdrifi/skjar/firmware/README.md

# firmware

マイコンのファームウェア。ライセンスは [MIT](../LICENSES/MIT.txt)。

| フォルダ | 内容 |
|---|---|
| [rp2040/](rp2040/) | キーボード（HID）と電源管理のファームウェア |
