hringdrifi/skjar/software/README.md

# software

CM0（Linux）側のソフトウェア。ライセンスは [MIT](../LICENSES/MIT.txt)。

| フォルダ | 内容 |
|---|---|
| [ui/](ui/) | 専用 UI |
| [os/](os/) | OS の設定とイメージを作るスクリプト |
