hringdrifi/skjar/docs/schematic/cm0-reference.png

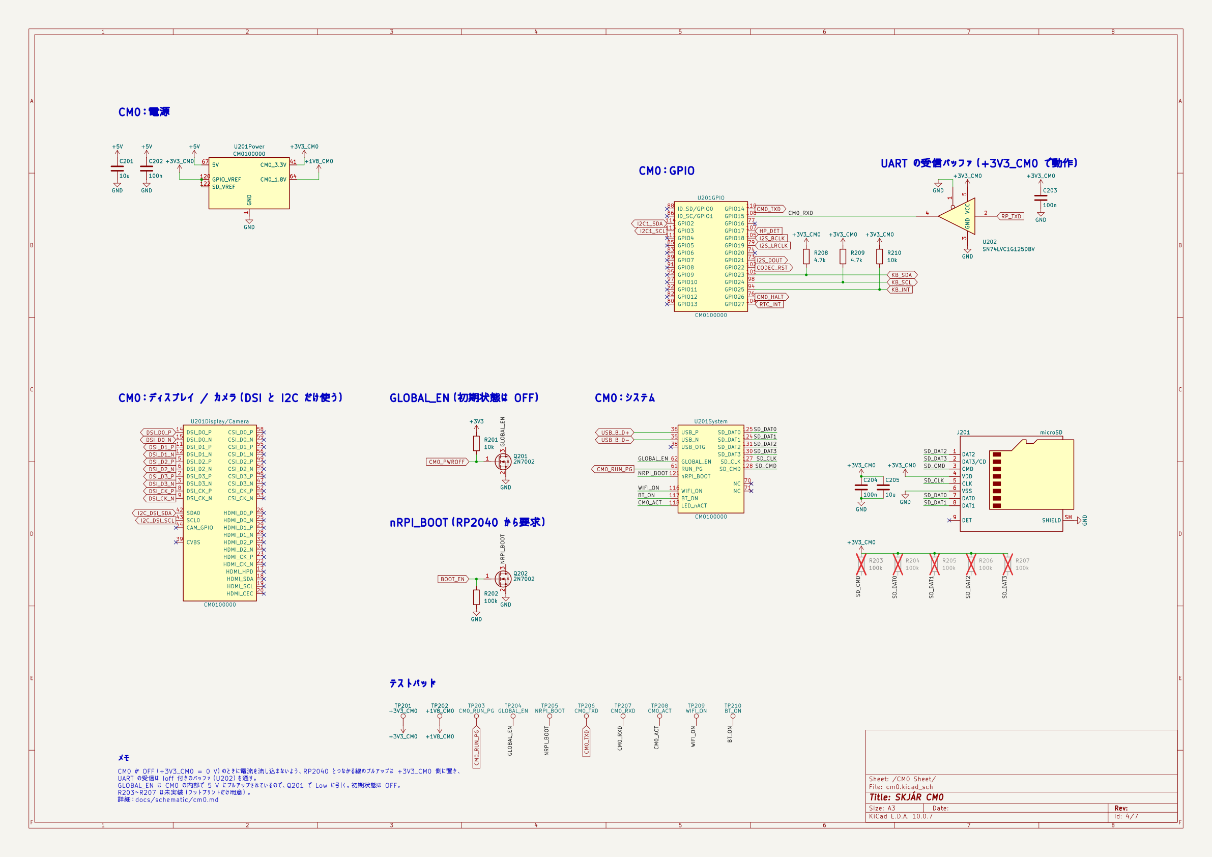
docs/schematic/cm0-reference.png
