hringdrifi/skjar/docs/schematic/display-reference.png

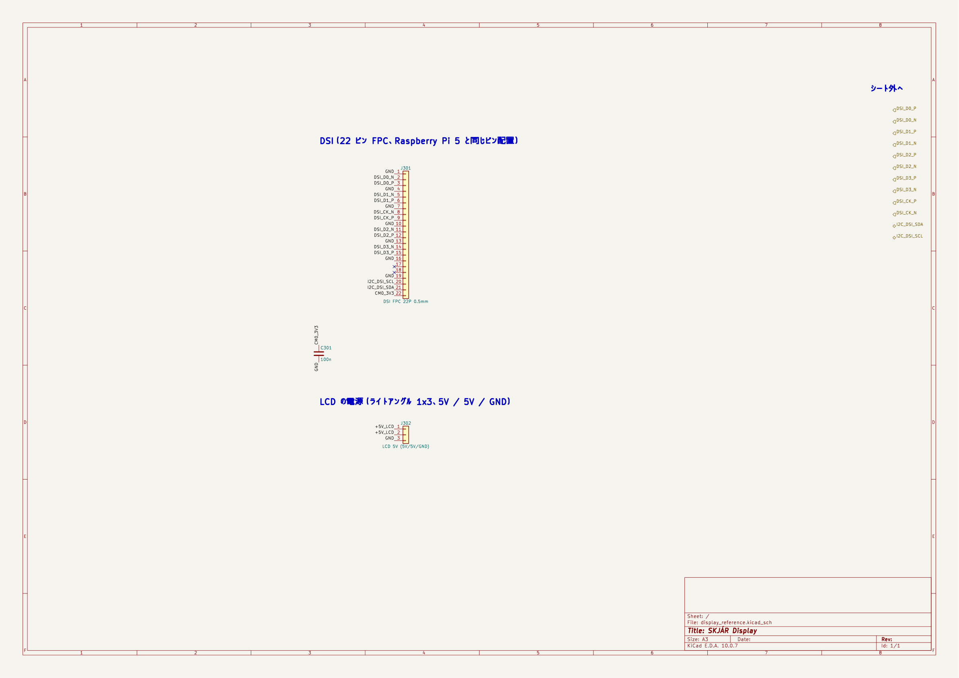
docs/schematic/display-reference.png
