hringdrifi/skjar/docs/schematic/peripherals-reference.png

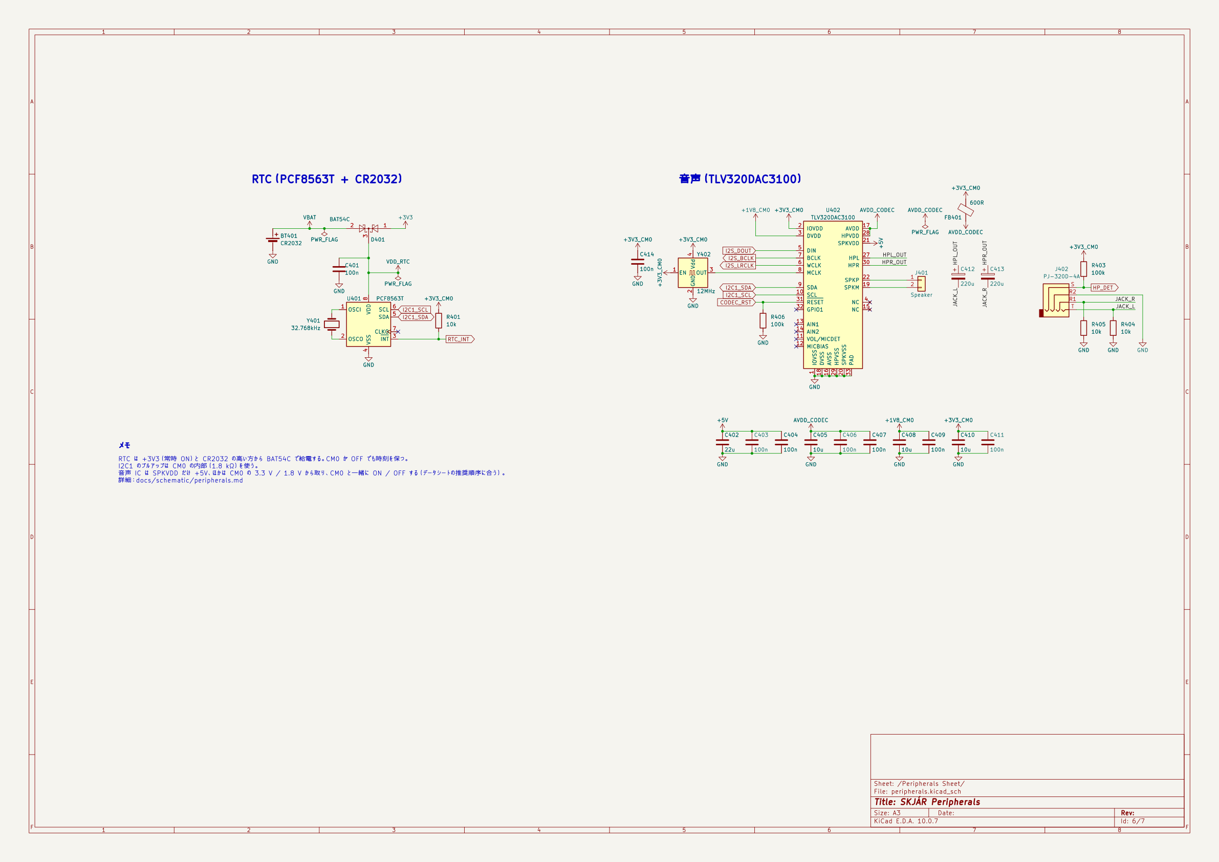
docs/schematic/peripherals-reference.png
