hringdrifi/skjar/docs/schematic/power-reference.png

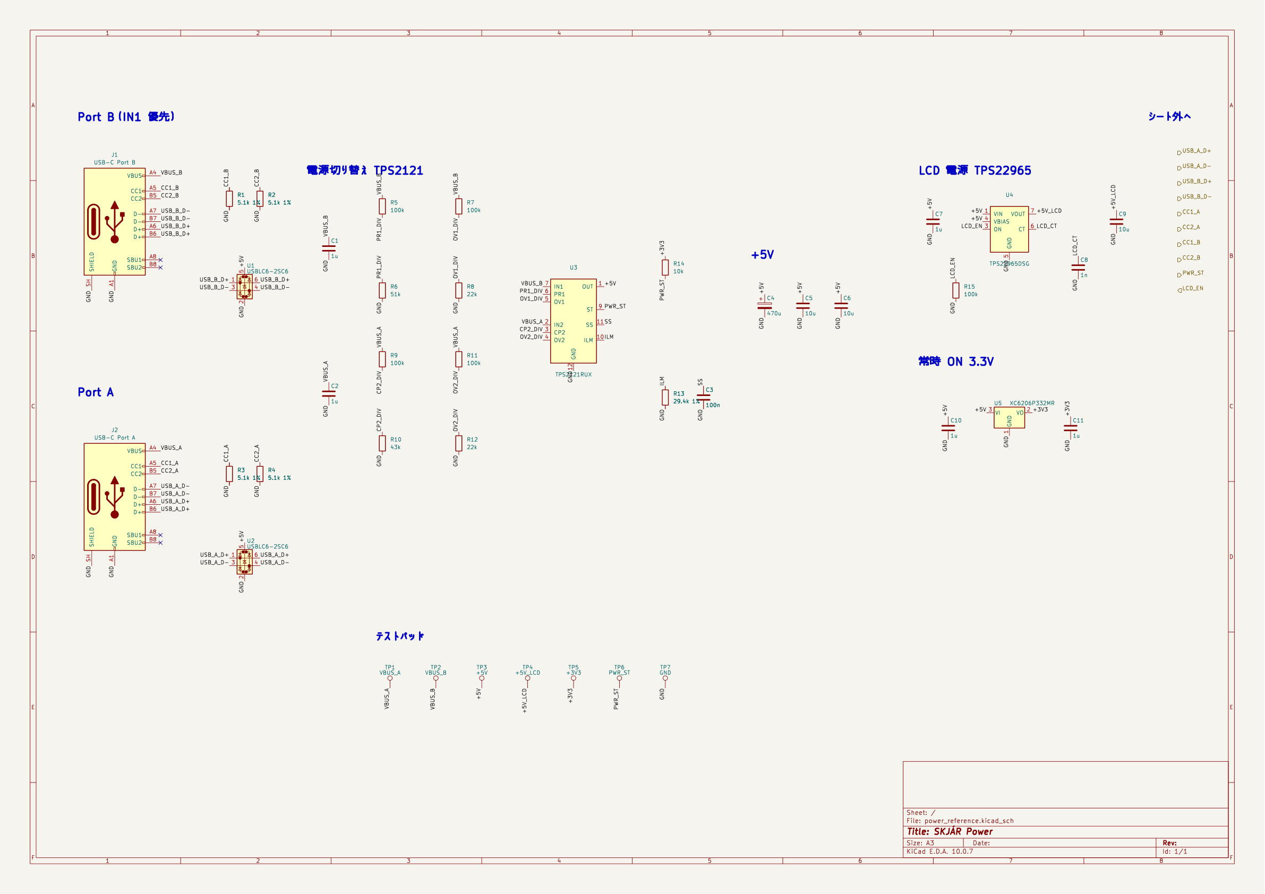
docs/schematic/power-reference.png
