hringdrifi/skjar/docs/schematic/rp2040-reference.png

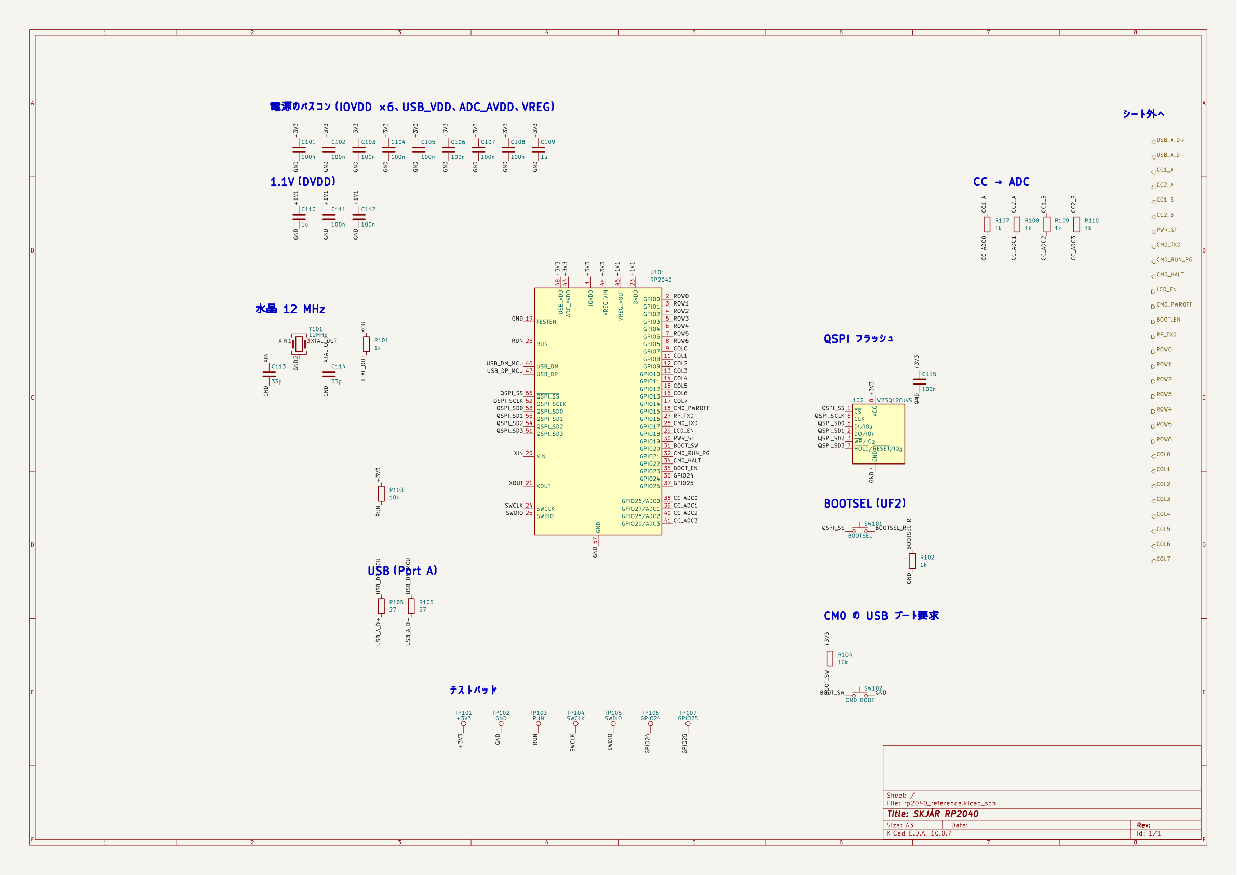
docs/schematic/rp2040-reference.png
