hringdrifi/skjar/hardware/case/skjar-case-onepiece.step

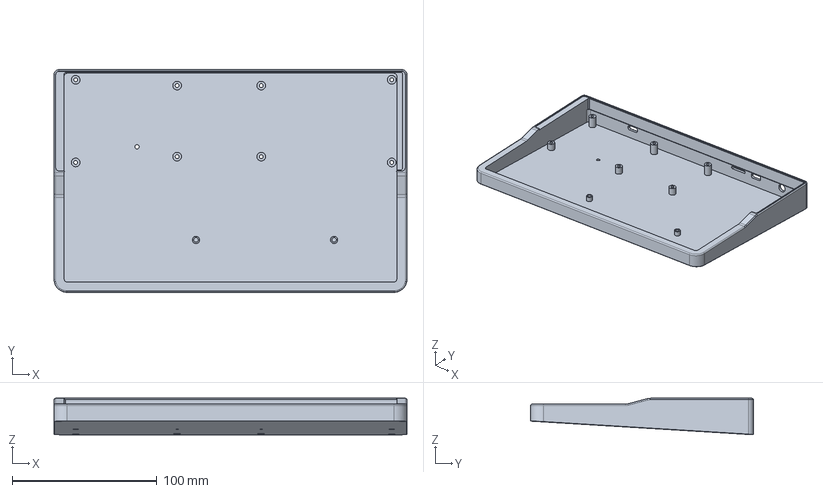
[picture p7: CAD file, 2026-11-06]
hardware/case/skjar-case-onepiece.step
243.5 x 153.6 x 25.2 mm
