hringdrifi/skjar/(list of files, cad)

Other CAD files:
hardware/case/skjar-case.step
