hringdrifi/skjar/docs/schematic/cm0-reference.pdf

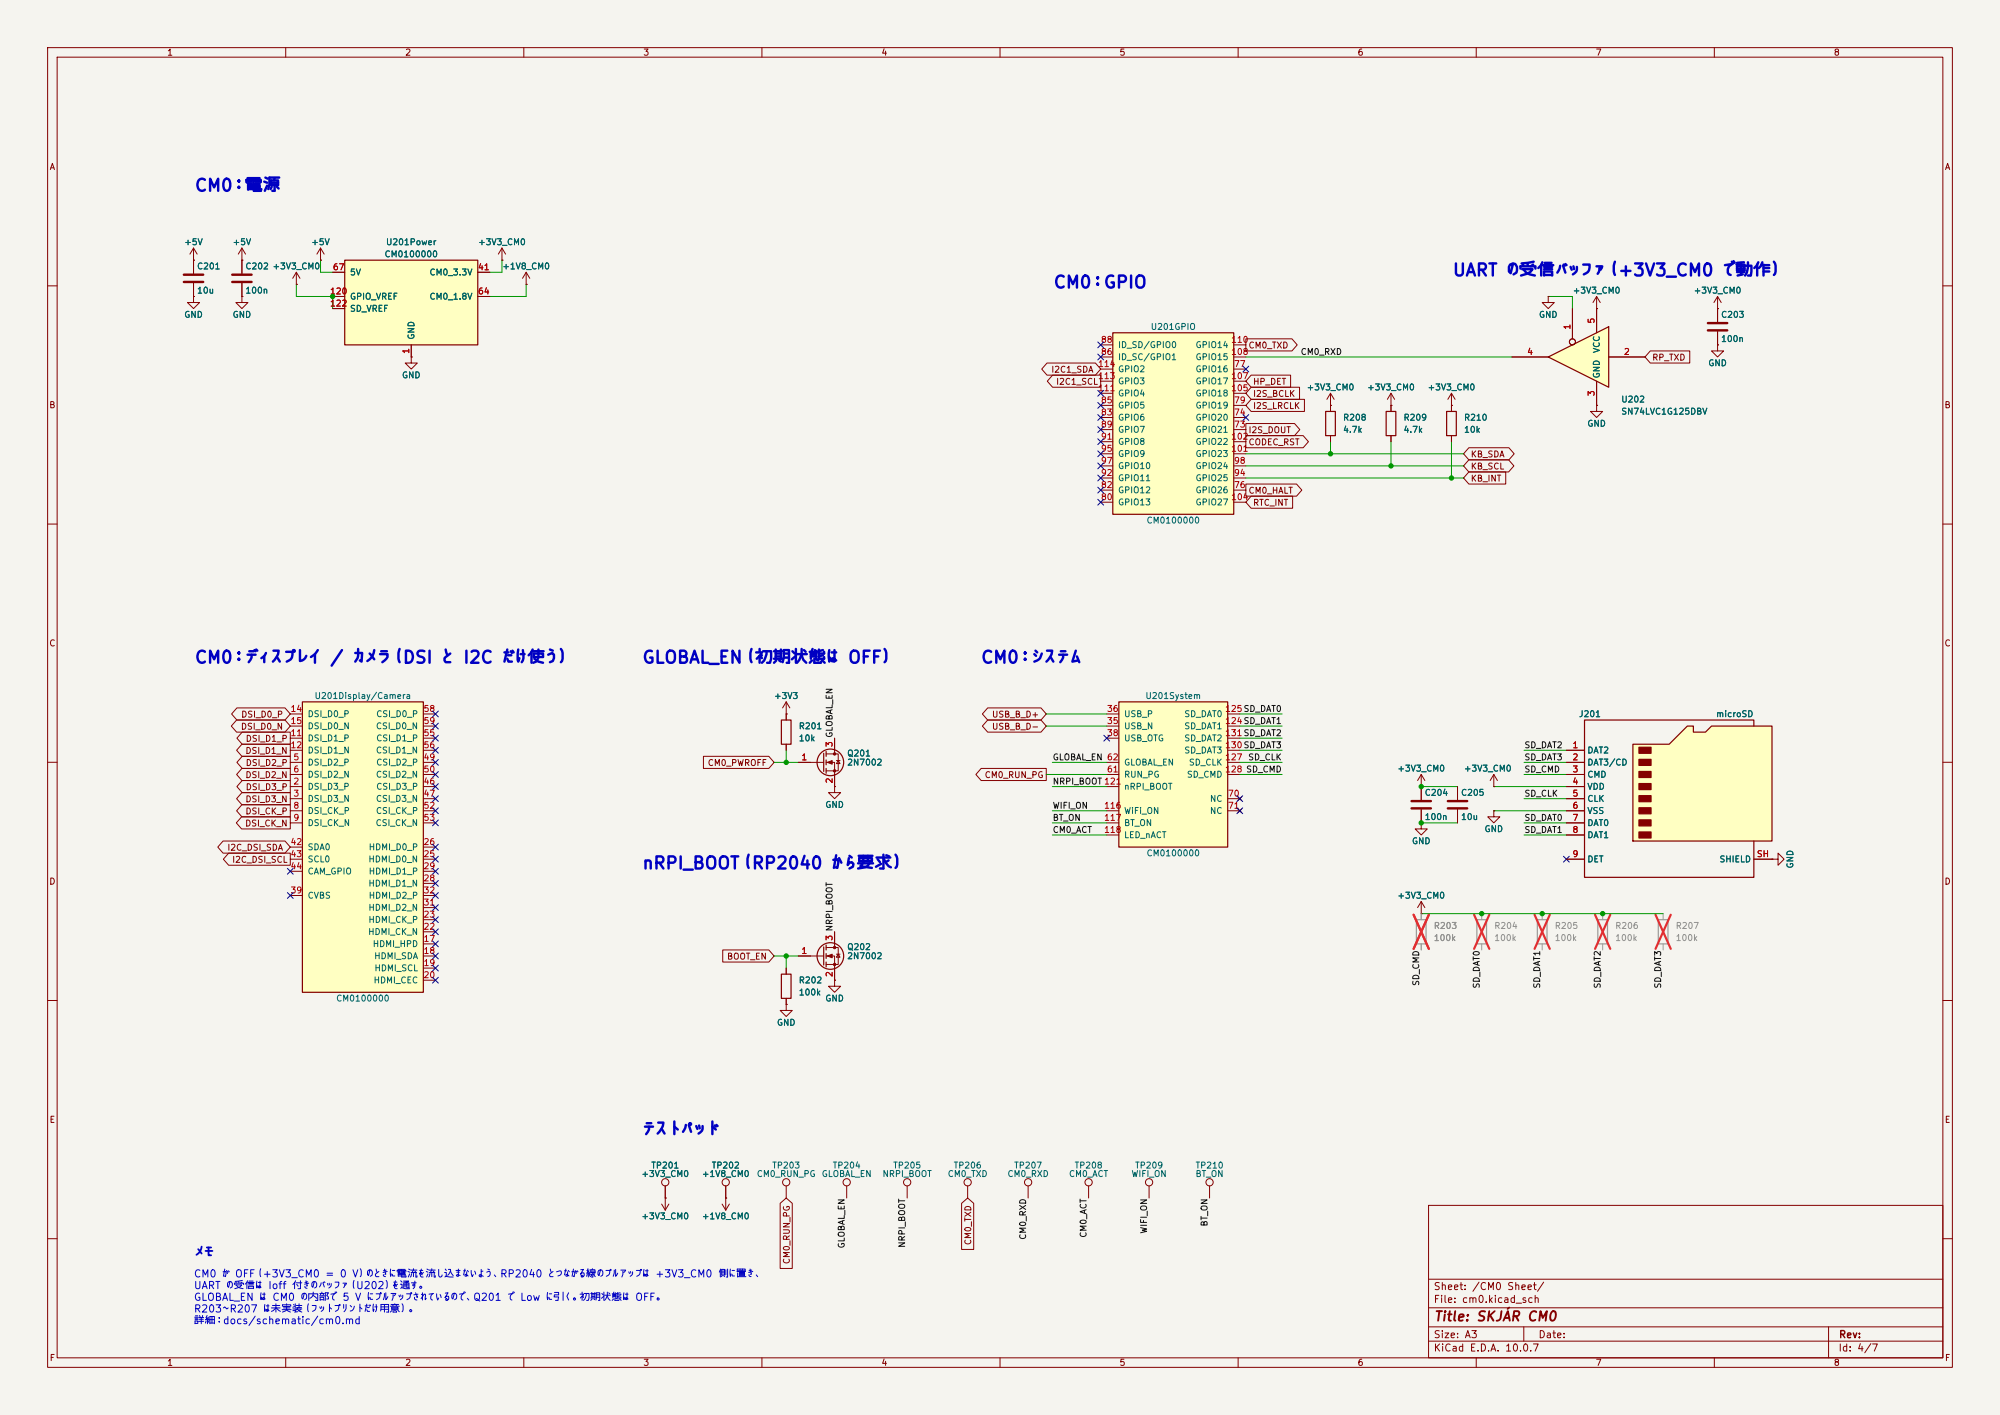
[picture p8: page 1]

CM0：ディスプレイ / カメラ（DSI と I2C だけ使う）

CM0_ACT CM0 が OFF（+3V3_CM0 = 0 V）のときに電流を流し込まないよう、RP2040 とつながる線のプルアップは +3V3_CM0 側に置き、

UART の受信は Ioff 付きのバッファ（U202）を通す。
GLOBAL_EN は CM0 の内部で 5 V にプルアップされているので、Q201 で Low に引く。初期状態は OFF。
R203〜R207 は未実装（フットプリントだけ用意）。
詳細：docs/schematic/cm0.md

Size: A3 | Rev: | F Date:
KiCad E.D.A. 10.0.7 | Id: 4/7
