hringdrifi/skjar/docs/schematic/rp2040-reference.pdf

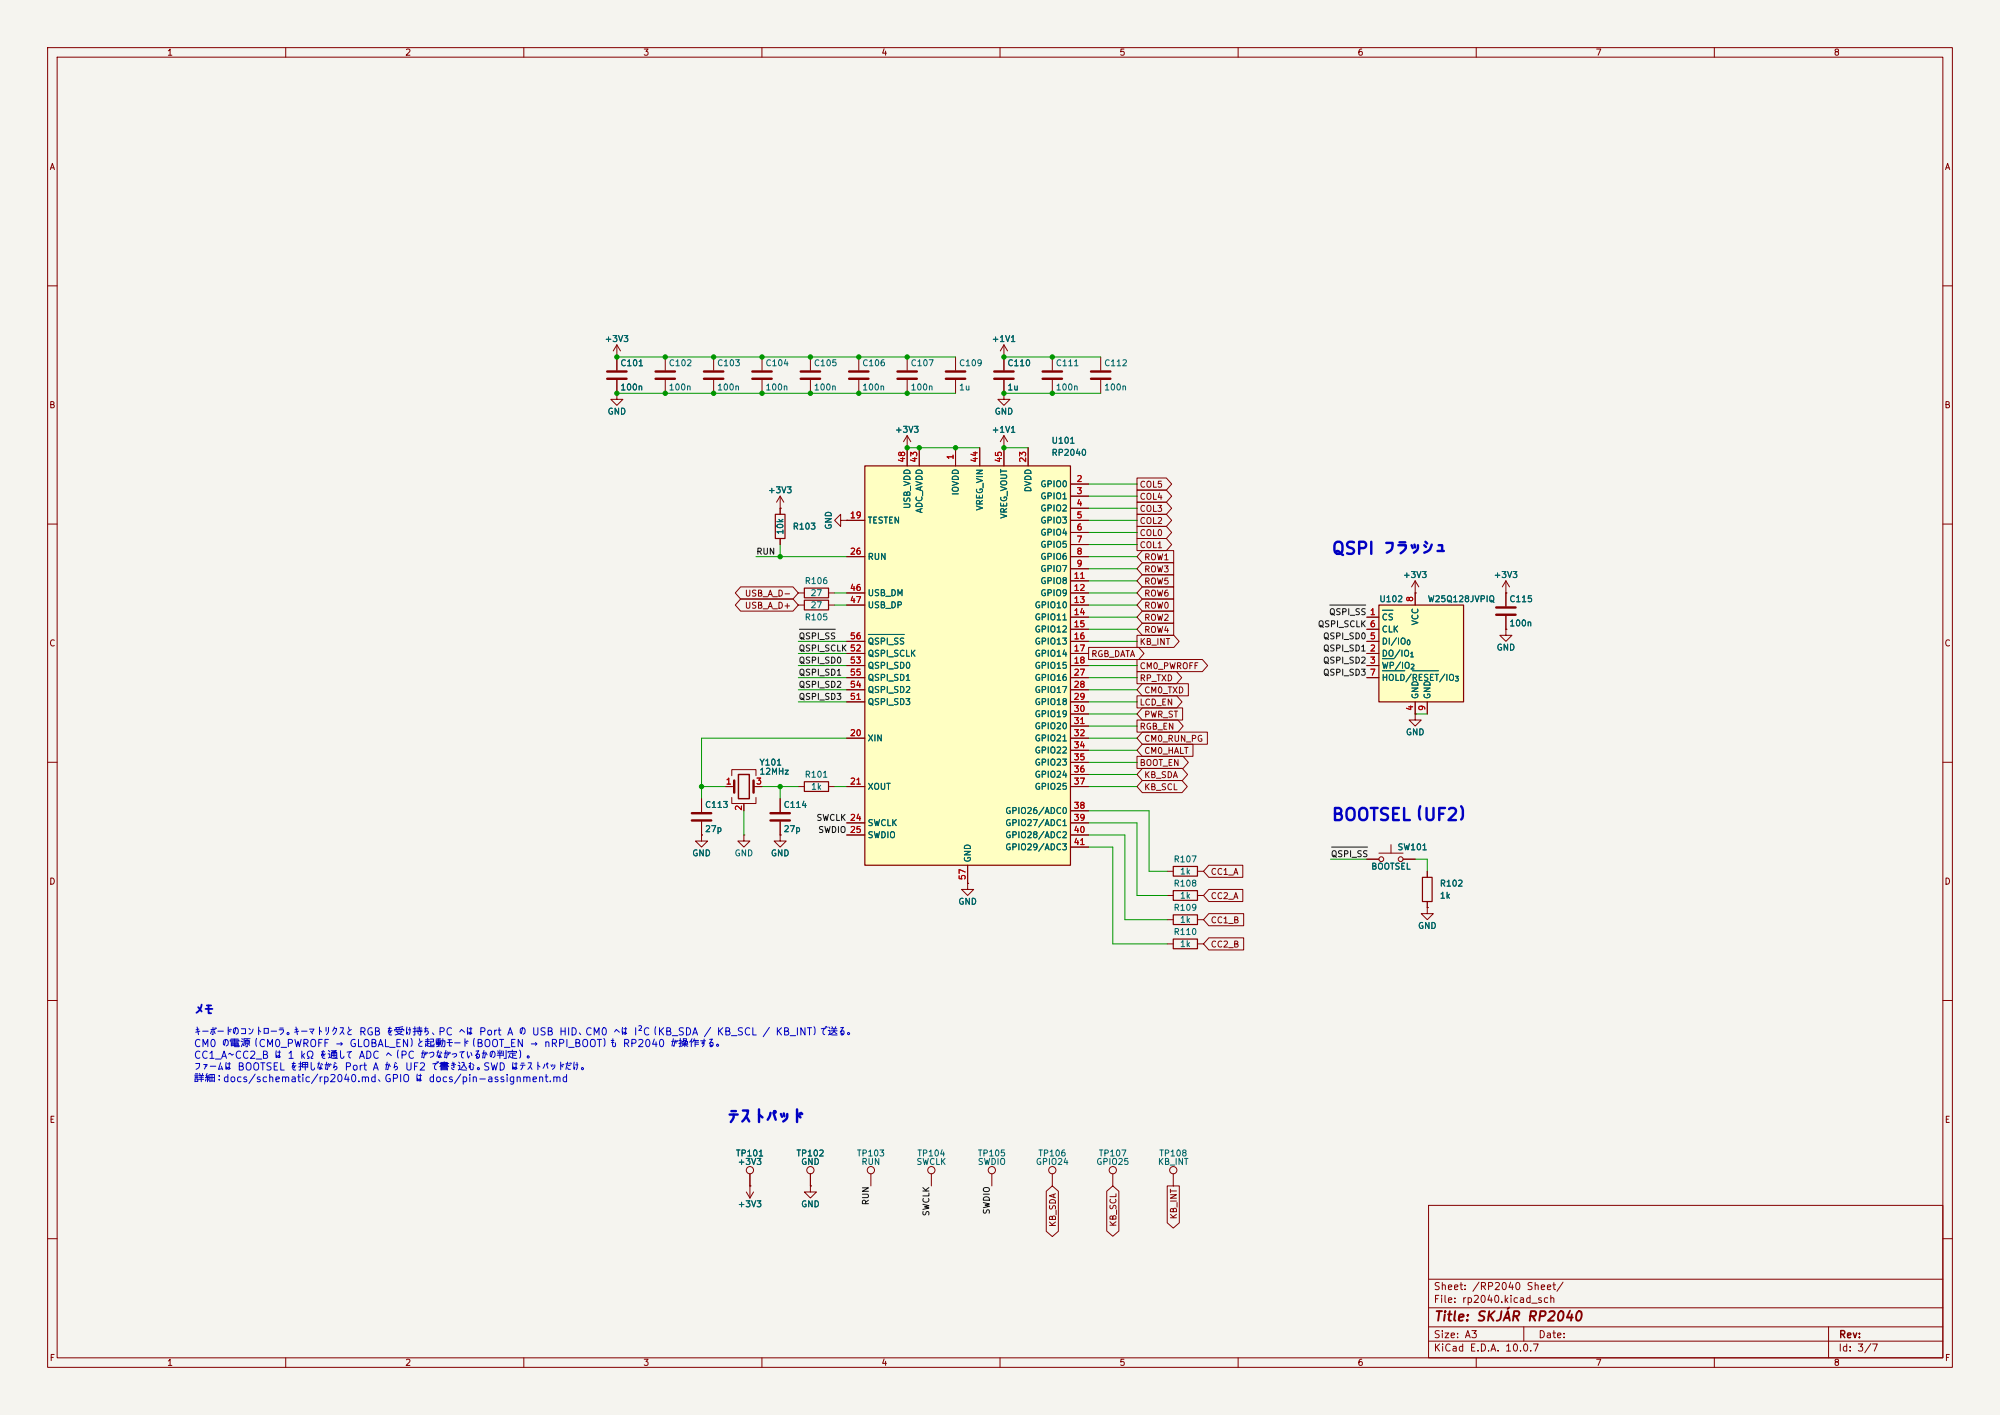
[picture p9: page 1]

4 DI/IO0 5 CLK 6 HOLD/RESET/IO3 7 VCC

キーボードのコントローラ。キーマトリクスと RGB を受け持ち、PC へは Port A の USB HID、CM0 へは I²C（KB_SDA / KB_SCL / KB_INT）で送る。
CM0 の電源（CM0_PWROFF → GLOBAL_EN）と起動モード（BOOT_EN → nRPI_BOOT）も RP2040 が操作する。
CC1_A〜CC2_B は 1 kΩ を通して ADC へ（PC がつながっているかの判定）。
ファームは BOOTSEL を押しながら Port A から UF2 で書き込む。SWD はテストパッドだけ。
詳細：docs/schematic/rp2040.md、GPIO は docs/pin-assignment.md

Size: A3 | Rev: | F Date:
KiCad E.D.A. 10.0.7 | Id: 3/7
