hringdrifi/skjar/docs/schematic/keymatrix-reference.pdf

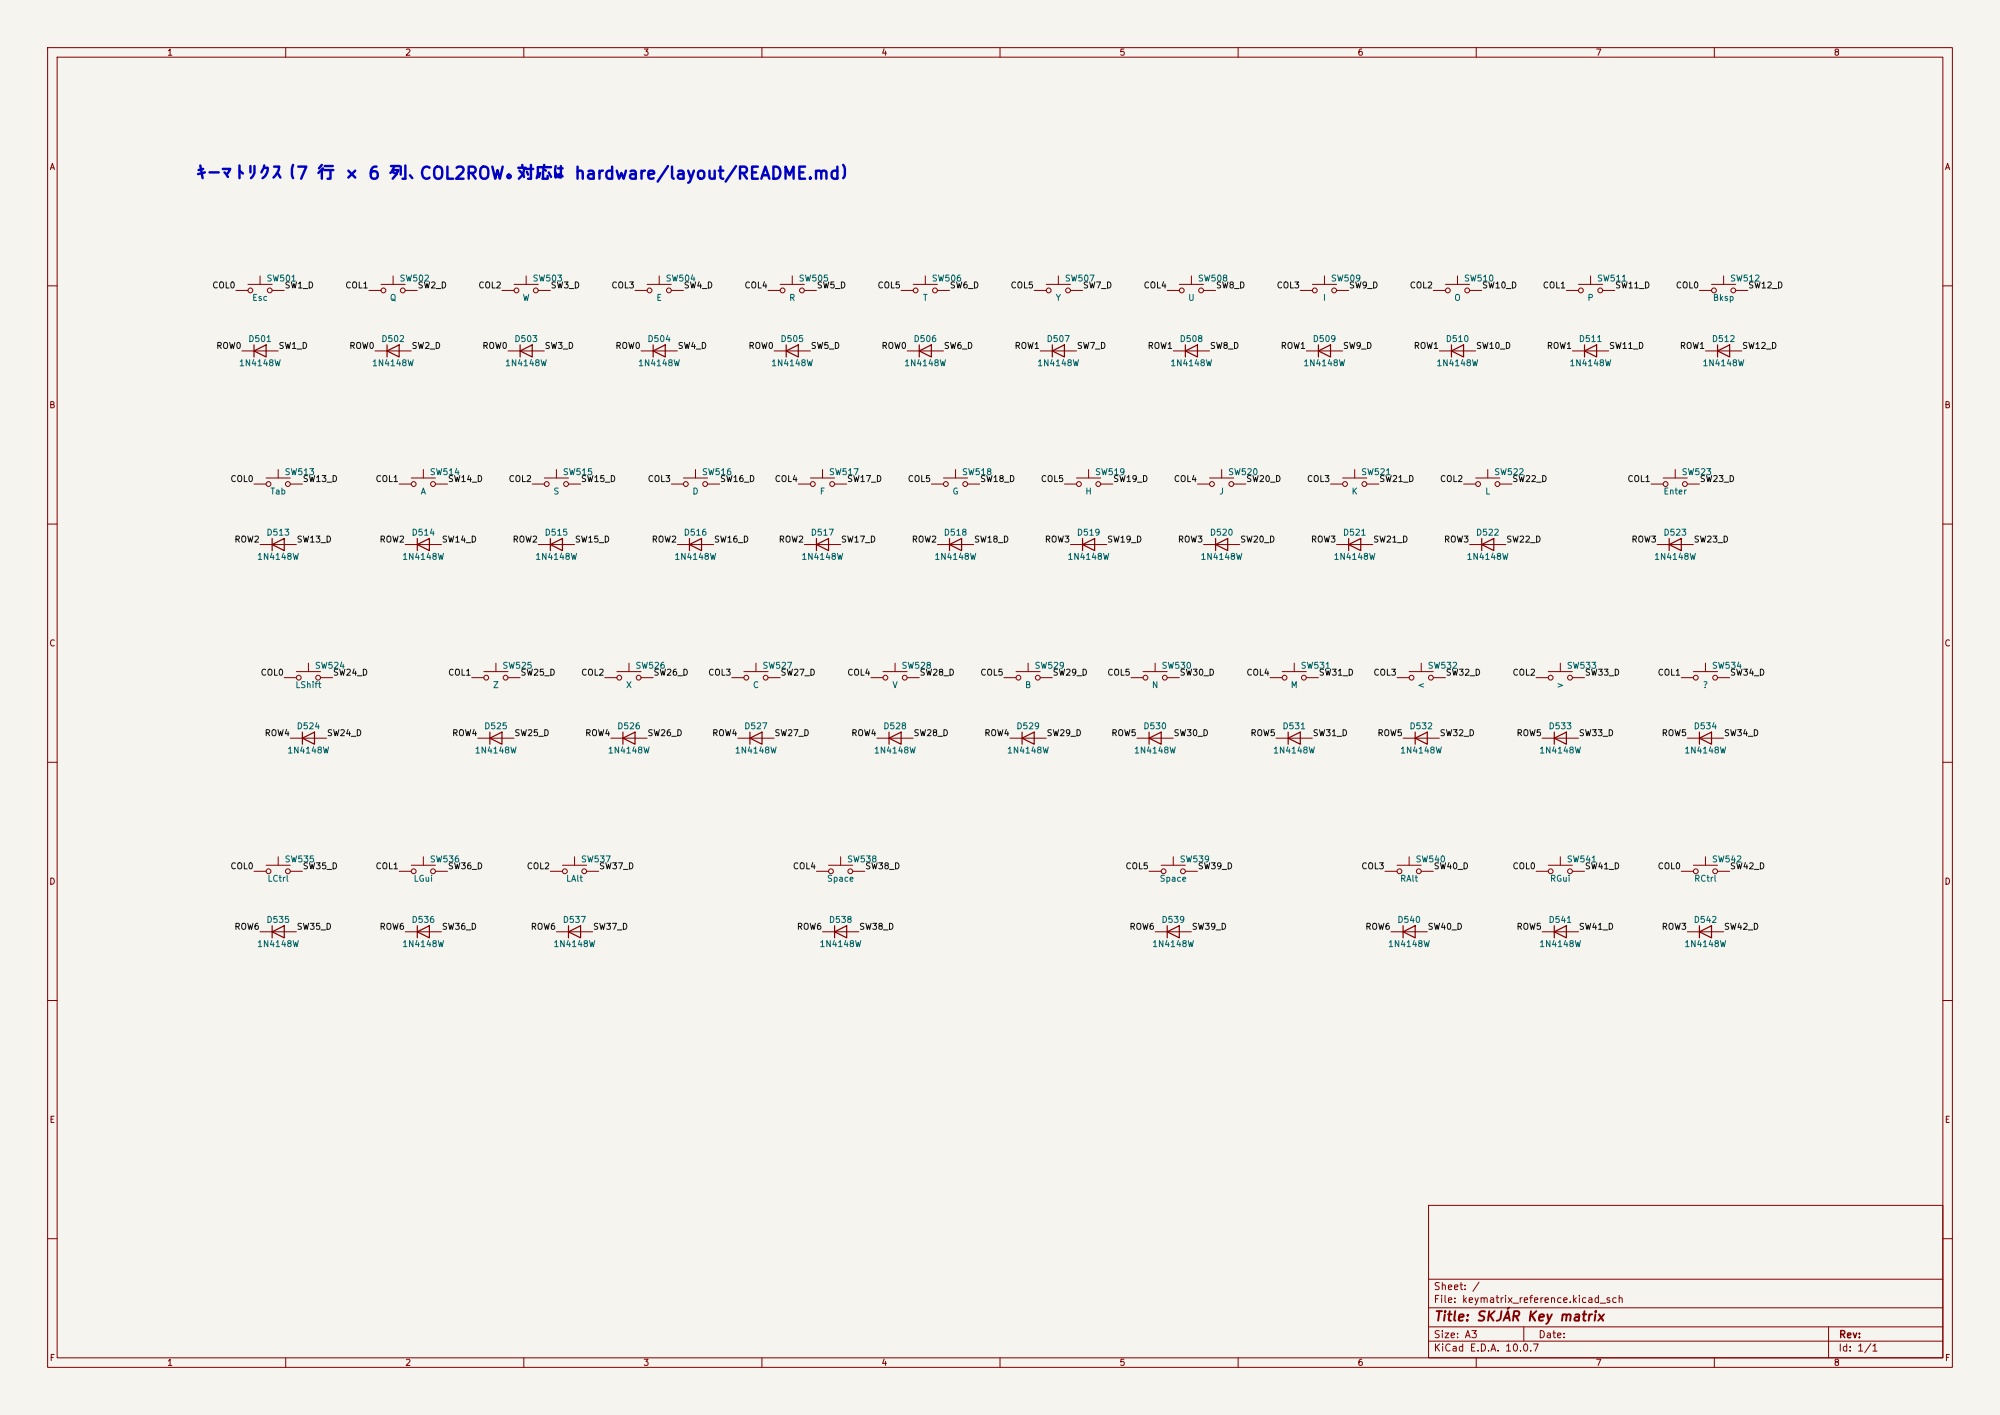
[picture p10: page 1]

SW19_D キーマトリクス（7 行 × 6 列、COL2ROW。対応は hardware/layout/README.md）

Sheet: /
File: keymatrix_reference.kicad_sch
Title: SKJÁR Key matrix

Size: A3 | Rev: | F Date:
KiCad E.D.A. 10.0.7 | Id: 1/1
