hringdrifi/skjar/docs/schematic/display-reference.pdf

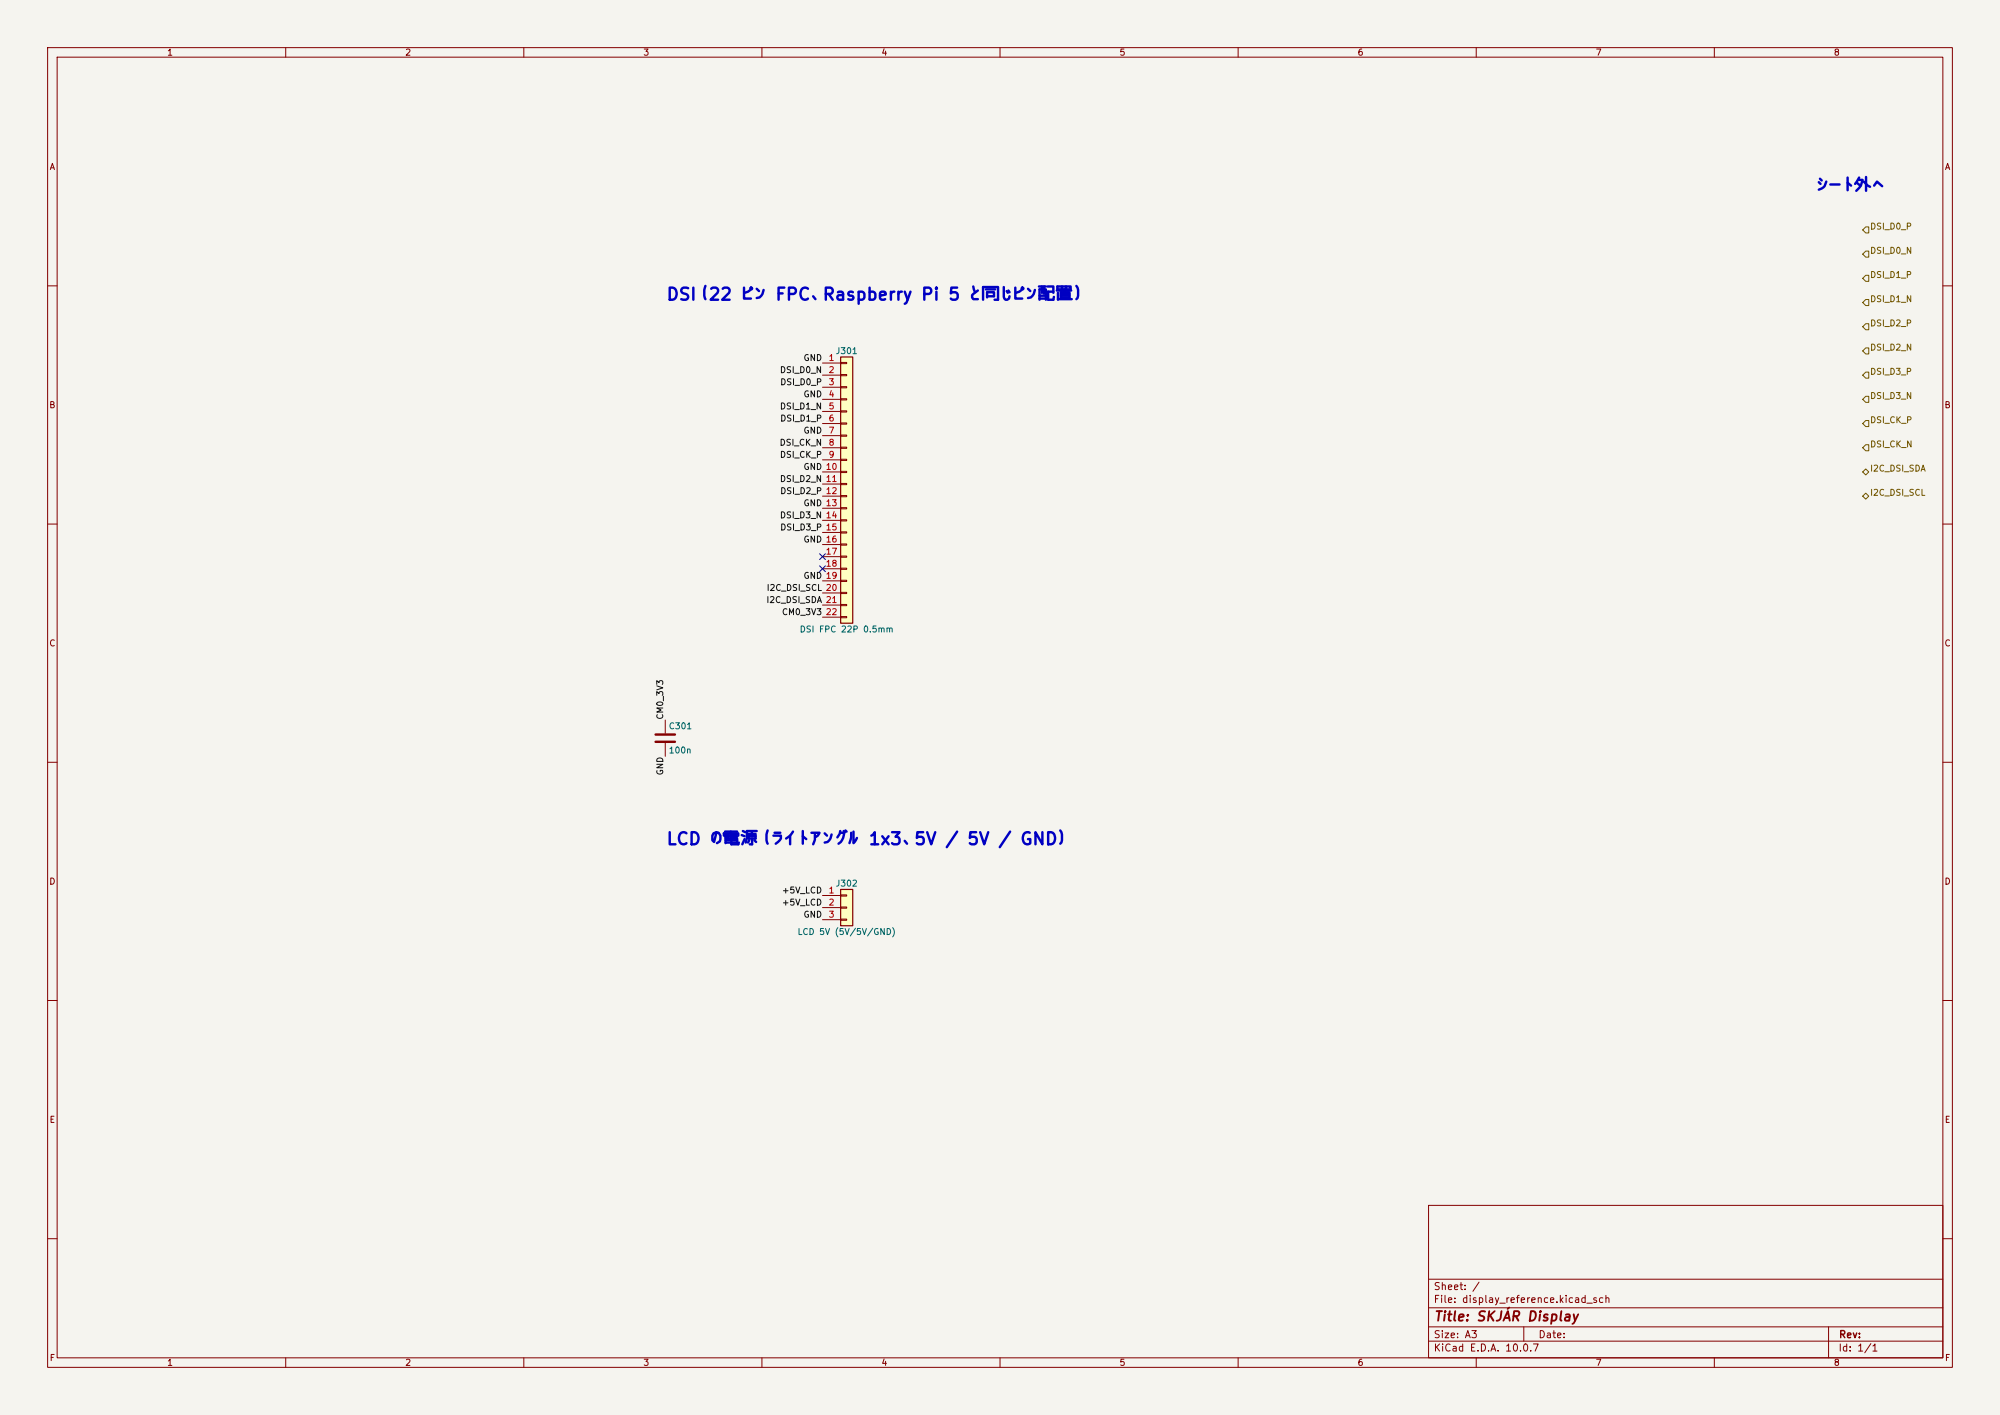
[picture p11: page 1]

DSI（22 ピン FPC、Raspberry Pi 5 と同じピン配置）

LCD の電源（ライトアングル 1x3、5V / 5V / GND）

Size: A3 | Rev: | F Date:
KiCad E.D.A. 10.0.7 | Id: 1/1
