hringdrifi/skjar/docs/schematic/peripherals-reference.pdf

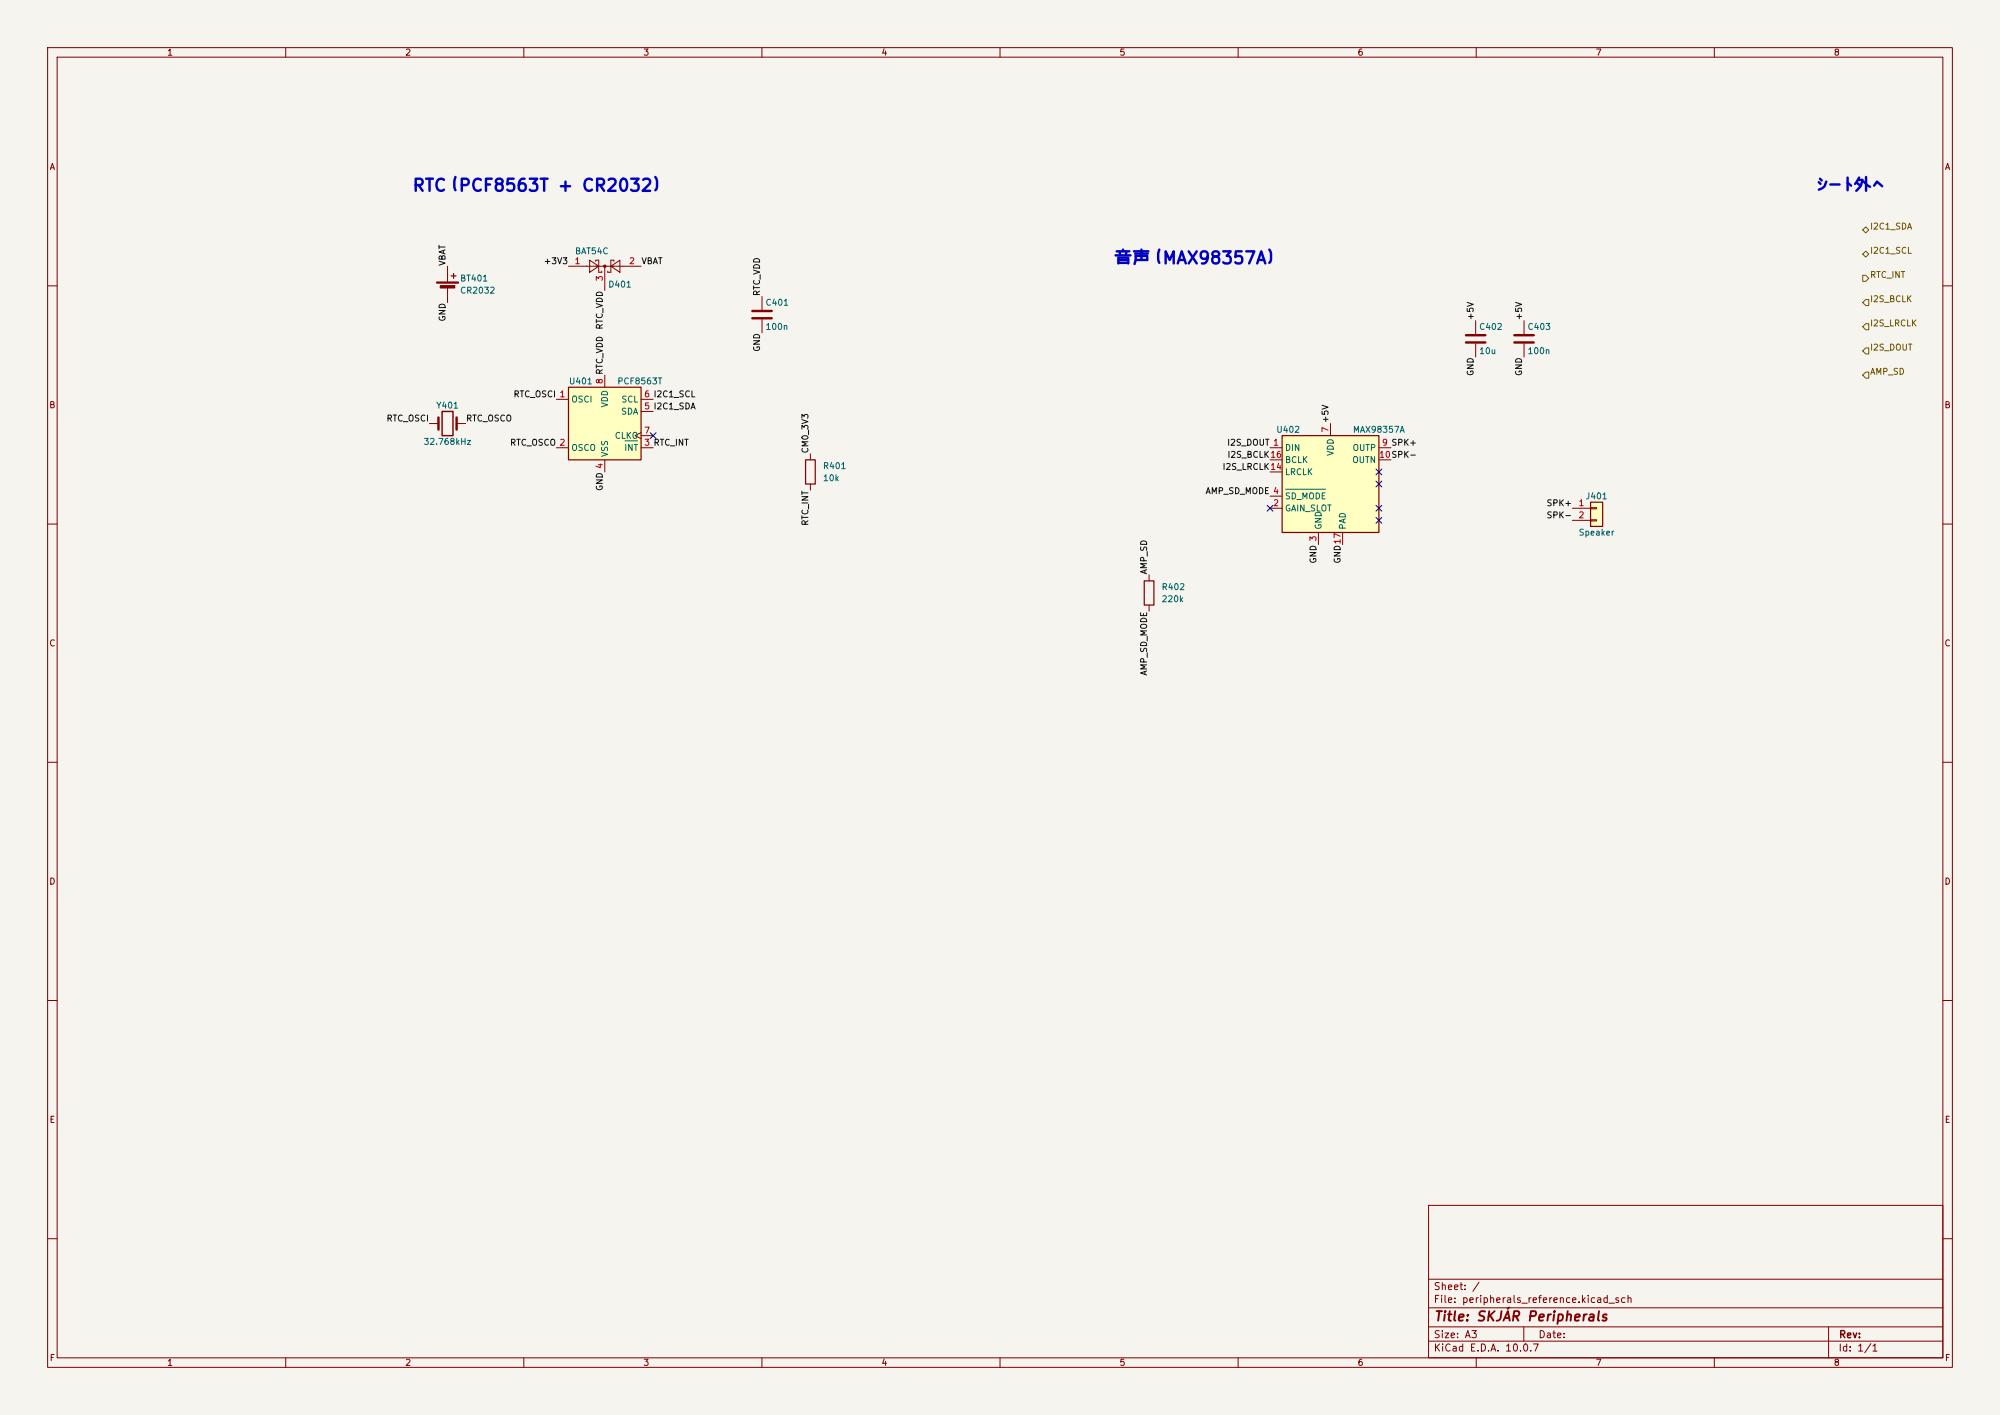
[picture p12: page 1]

Size: A3 | Rev: | F Date:
KiCad E.D.A. 10.0.7 | Id: 1/1
