hringdrifi/skjar/firmware/rp2040/src/main.rs

//! SKJÁR の RP2040 ファームウェア（試作）。
//!
//! いまの段階で確かめること：RMK のキーボード処理の出力を HID over I²C で
//! Linux（CM0、試作では Pi Zero 2 W）に渡し、`i2c-hid` で普通のキーボードとして使えるか。
//!
//! - キーマトリクスと RMK のキーボード処理（レイヤー、タップ・ホールドなど）
//! - RMK が USB 用に出すレポートを受け取り、タッチキーと合わせて HID over I²C に流す（[`reports`]、[`hid_i2c`]）
//! - CM0 との UART（タッチキー、状態のやり取り。[`cm0_link`]）
//! - PC への USB（[`usb_hid`]）：キーボード、マウス・メディアキー、ログ用のシリアル（CDC-ACM）。
//!   キーボードモードでは、キーとトラックパッドを PC に、サイバーデックモードでは CM0 に出す（[`reports`]）
//!
//! 基板は cargo の feature で選ぶ：`pico`（Raspberry Pi Pico で試す。初期値）、`xiao`（Seeed Studio
//! XIAO RP2040 で試す）、`skjar` のどれか 1 つ。

#![no_std]
#![no_main]

mod cm0_link;
mod hid_i2c;
mod keymap;
mod reports;
mod rgb;
mod usb_hid;

use embassy_executor::Spawner;
use embassy_futures::join::join;
use embassy_rp::gpio::{Flex, Input, Level, Output, Pull};
use embassy_rp::i2c_slave::{self, I2cSlave};
use embassy_rp::peripherals::{DMA_CH0, PIO0, UART0, USB};
use embassy_rp::pio::Pio;
use embassy_rp::pio_programs::ws2812::{Grb, PioWs2812, PioWs2812Program};
use embassy_rp::uart::{self, BufferedUart};
use embassy_rp::usb::{self, Driver};
use embassy_rp::bind_interrupts;
use log::{info, warn};
use panic_halt as _;
use rmk::channel::USB_REPORT_CHANNEL;
use rmk::config::{BehaviorConfig, PositionalConfig};
use rmk::debounce::default_debouncer::DefaultDebouncer;
use rmk::hid::Report;
use rmk::keyboard::Keyboard;
use rmk::matrix::Matrix;
use rmk::types::connection::UsbState;
use rmk::{KeymapData, initialize_keymap, run_all};
use static_cell::StaticCell;

use crate::keymap::{COL, MATRIX_ROW, NUM_LAYER, ROW};

#[cfg(any(
    all(feature = "pico", feature = "skjar"),
    all(feature = "pico", feature = "xiao"),
    all(feature = "xiao", feature = "skjar"),
))]
compile_error!("feature の `pico`、`xiao`、`skjar` は、どれか 1 つだけを選ぶ（`xiao` と `skjar` は --no-default-features と一緒に）");

// キー入力の I²C。SKJÁR は I2C0（GPIO24 / 25）。Pico と XIAO では GPIO24 / 25 が外に出ていないので
// I2C1（GPIO26 / 27。XIAO では D0 / D1）を使う。
#[cfg(feature = "skjar")]
type KbI2c = embassy_rp::peripherals::I2C0;
#[cfg(not(feature = "skjar"))]
type KbI2c = embassy_rp::peripherals::I2C1;

#[cfg(feature = "skjar")]
bind_interrupts!(struct Irqs {
    USBCTRL_IRQ => usb::InterruptHandler<USB>;
    I2C0_IRQ => embassy_rp::i2c::InterruptHandler<KbI2c>;
    UART0_IRQ => uart::BufferedInterruptHandler<UART0>;
    PIO0_IRQ_0 => embassy_rp::pio::InterruptHandler<PIO0>;
    DMA_IRQ_0 => embassy_rp::dma::InterruptHandler<DMA_CH0>;
});
#[cfg(not(feature = "skjar"))]
bind_interrupts!(struct Irqs {
    USBCTRL_IRQ => usb::InterruptHandler<USB>;
    I2C1_IRQ => embassy_rp::i2c::InterruptHandler<KbI2c>;
    UART0_IRQ => uart::BufferedInterruptHandler<UART0>;
    PIO0_IRQ_0 => embassy_rp::pio::InterruptHandler<PIO0>;
    DMA_IRQ_0 => embassy_rp::dma::InterruptHandler<DMA_CH0>;
});

/// PC への USB（キーボード、マウス・メディアキー、ログ）。usb_hid.rs
#[embassy_executor::task]
async fn usb_task(driver: Driver<'static, USB>) {
    usb_hid::run(driver).await
}

#[embassy_executor::task]
async fn rgb_task(leds: PioWs2812<'static, PIO0, 0, { rgb::LEDS }, Grb>, power: Output<'static>) {
    rgb::run(leds, power).await
}

#[embassy_executor::task]
async fn hid_i2c_task(i2c: I2cSlave<'static, KbI2c>) {
    hid_i2c::run_target(i2c).await
}

/// RMK が出すレポートを、タッチキーと合わせて出力先に送る。
#[embassy_executor::task]
async fn report_bridge_task() {
    loop {
        match USB_REPORT_CHANNEL.receive().await {
            Report::KeyboardReport(r) => reports::rmk_keyboard(r.modifier, r.keycodes),
            Report::MediaKeyboardReport(r) => reports::rmk_consumer(r.usage_id),
            Report::MouseReport(r) => reports::rmk_mouse(r.buttons, r.x, r.y, r.wheel, r.pan),
            _ => warn!("bridge: report type not supported over I2C yet"),
        }
    }
}

#[embassy_executor::main]
async fn main(spawner: Spawner) {
    let p = embassy_rp::init(Default::default());

    // ログ（USB の仮想シリアル）
    spawner.spawn(usb_task(Driver::new(p.USB, Irqs)).unwrap());

    // KB_INT（GPIO13。XIAO では D2 の GPIO28）：Low で CM0 に知らせる。オープンドレインを真似る（hid_i2c 参照）。
    #[cfg(not(feature = "xiao"))]
    hid_i2c::init_int_pin(Flex::new(p.PIN_13));
    #[cfg(feature = "xiao")]
    hid_i2c::init_int_pin(Flex::new(p.PIN_28));

    // キー入力の I²C。内部プルアップは使わない（プルアップは CM0 の 3.3V 側にある）。
    let mut i2c_config = i2c_slave::Config::default();
    i2c_config.addr = hid_i2c::I2C_ADDR;
    i2c_config.general_call = false;
    i2c_config.sda_pullup = false;
    i2c_config.scl_pullup = false;
    #[cfg(feature = "skjar")]
    let i2c = I2cSlave::new(p.I2C0, p.PIN_25, p.PIN_24, Irqs, i2c_config);
    #[cfg(not(feature = "skjar"))]
    let i2c = I2cSlave::new(p.I2C1, p.PIN_27, p.PIN_26, Irqs, i2c_config);
    spawner.spawn(hid_i2c_task(i2c).unwrap());

    // CM0 との UART（UART0：GPIO16 TX → CM0 の GPIO15、GPIO17 RX ← CM0 の GPIO14。
    // XIAO では GPIO16 / 17 が基板の LED なので、D6 の GPIO0 TX と D7 の GPIO1 RX）。
    // TX は CM0 の 3.3V で動くバッファを通るので、CM0 が OFF でも電流は流れ込まない。
    // RX には内部のプルを付けない（embassy-rp の初期化はプルを有効にしない）。
    static UART_TX_BUF: StaticCell<[u8; 256]> = StaticCell::new();
    static UART_RX_BUF: StaticCell<[u8; 256]> = StaticCell::new();
    let mut uart_config = uart::Config::default();
    uart_config.baudrate = 115_200;
    #[cfg(not(feature = "xiao"))]
    let (uart_tx, uart_rx) = (p.PIN_16, p.PIN_17);
    #[cfg(feature = "xiao")]
    let (uart_tx, uart_rx) = (p.PIN_0, p.PIN_1);
    let uart = BufferedUart::new(
        p.UART0,
        uart_tx,
        uart_rx,
        Irqs,
        UART_TX_BUF.init([0; 256]),
        UART_RX_BUF.init([0; 256]),
        uart_config,
    );
    // CM0 とのやり取りはキーマップを読むので、キーマップを作ったあと、キーボードと並べて動かす（下）

    // RMK は USB がつながったときだけ USB 用のチャンネルにレポートを出す。RMK の USB は使わず
    // （usb_hid.rs が自分で組む）、いつもつながったことにしてチャンネルを横取りし、タッチキーと
    // 合わせてモードで PC か CM0 に送り分ける（reports.rs）。
    rmk::state::set_usb_state(UsbState::Configured);
    spawner.spawn(report_bridge_task().unwrap());

    // キーの RGB（GPIO14 RGB_DATA を PIO0 で、GPIO20 RGB_EN は High で電源 ON。初めは OFF）。
    // Pico で試すときは、同じ GP14 / GP20 に WS2812 のテープ LED などをつなぐ
    let mut pio = Pio::new(p.PIO0, Irqs);
    let ws2812 = PioWs2812Program::new(&mut pio.common);
    let leds = PioWs2812::new(&mut pio.common, pio.sm0, p.DMA_CH0, Irqs, p.PIN_14, &ws2812);
    let rgb_power = Output::new(p.PIN_20, Level::Low);
    spawner.spawn(rgb_task(leds, rgb_power).unwrap());

    // キーマトリクス（7 行 × 6 列、ダイオードは列 → 行）。キーマップは、これにタッチキーの 4 行を足した 11 行（keymap.rs）。
    // RMK の COL2ROW は、列を High に駆動して行を読む（行はプルダウン）。
    #[cfg(not(feature = "xiao"))]
    let rows = [
        Input::new(p.PIN_10, Pull::Down), // ROW0
        Input::new(p.PIN_6, Pull::Down),  // ROW1
        Input::new(p.PIN_11, Pull::Down), // ROW2
        Input::new(p.PIN_7, Pull::Down),  // ROW3
        Input::new(p.PIN_12, Pull::Down), // ROW4
        Input::new(p.PIN_8, Pull::Down),  // ROW5
        Input::new(p.PIN_9, Pull::Down),  // ROW6
    ];
    #[cfg(not(feature = "xiao"))]
    let cols = [
        Output::new(p.PIN_4, Level::Low), // COL0
        Output::new(p.PIN_5, Level::Low), // COL1
        Output::new(p.PIN_3, Level::Low), // COL2
        Output::new(p.PIN_2, Level::Low), // COL3
        Output::new(p.PIN_1, Level::Low), // COL4
        Output::new(p.PIN_0, Level::Low), // COL5
    ];
    // XIAO：外に出ている 6 本を 3 行 × 3 列にして、ROW2・ROW4・ROW6 の 1・2・5 列目（9 キー）を試す。
    // 親指の段（ROW6）の 5 列目がレイヤー 2（押し続ける）なので、レイヤー 2 の音量キー（ROW2）と
    // USER キー（ROW4）も試せる。ほかの行と列は、外に出ていない（何もつながっていない）ピンにする。
    // 行はプルダウンなので押されることはない。GPIO11 / 12（基板の RGB LED の電源とデータ）と
    // 16 / 17 / 25（基板の LED）は避ける
    #[cfg(feature = "xiao")]
    let rows = [
        Input::new(p.PIN_10, Pull::Down), // ROW0  （出ていない）
        Input::new(p.PIN_8, Pull::Down),  // ROW1  （出ていない）
        Input::new(p.PIN_6, Pull::Down),  // ROW2  D4：A S G（レイヤー 2 で Mute、音量 −）
        Input::new(p.PIN_9, Pull::Down),  // ROW3  （出ていない）
        Input::new(p.PIN_7, Pull::Down),  // ROW4  D5：Z X B（レイヤー 2 で USER0、USER1）
        Input::new(p.PIN_13, Pull::Down), // ROW5  （出ていない）
        Input::new(p.PIN_29, Pull::Down), // ROW6  D3：LGui LAlt Space（押し続けるとレイヤー 2）
    ];
    #[cfg(feature = "xiao")]
    let cols = [
        Output::new(p.PIN_15, Level::Low), // COL0  （出ていない）
        Output::new(p.PIN_4, Level::Low),  // COL1  D9
        Output::new(p.PIN_3, Level::Low),  // COL2  D10
        Output::new(p.PIN_18, Level::Low), // COL3  （出ていない）
        Output::new(p.PIN_19, Level::Low), // COL4  （出ていない）
        Output::new(p.PIN_2, Level::Low),  // COL5  D8
    ];
    let mut matrix = Matrix::<_, _, _, MATRIX_ROW, COL, true>::new(rows, cols, DefaultDebouncer::new());

    static KEYMAP_DATA: StaticCell<KeymapData<ROW, COL, NUM_LAYER, 0>> = StaticCell::new();
    static BEHAVIOR: StaticCell<BehaviorConfig> = StaticCell::new();
    static POSITIONAL: StaticCell<PositionalConfig<ROW, COL>> = StaticCell::new();
    let keymap_data = KEYMAP_DATA.init(KeymapData::new(keymap::get_default_keymap()));
    let behavior = BEHAVIOR.init(BehaviorConfig::default());
    let positional = POSITIONAL.init(PositionalConfig::default());
    let keymap = initialize_keymap(keymap_data, behavior, positional).await;
    let mut keyboard = Keyboard::new(&keymap);

    info!("SKJÁR RP2040 started");
    join(run_all!(matrix, keyboard), cm0_link::run(uart, &keymap)).await;
}
