hringdrifi/skjar/firmware/rp2040/build.rs

//! memory.x をリンカが見つけられる場所に置き、リンカスクリプトを指定する。

use std::path::PathBuf;
use std::{env, fs};

fn main() {
    let out = PathBuf::from(env::var_os("OUT_DIR").unwrap());
    fs::copy("memory.x", out.join("memory.x")).unwrap();
    println!("cargo:rustc-link-search={}", out.display());
    println!("cargo:rerun-if-changed=memory.x");
    println!("cargo:rustc-link-arg-bins=--nmagic");
    println!("cargo:rustc-link-arg-bins=-Tlink.x");
}
