hringdrifi/skjar/(commit log)

2026-10-30 Initial design documentation for SKJÁR
    Add the updated specification, design decisions, open items, and
    reference summaries for the 40% keyboard / cyberdeck with an 8.8"
    DSI touch display, Raspberry Pi CM0, and RP2040.
    Third-party datasheets and drawings are excluded via .gitignore;
    docs/references/README.md links to their original sources.
    Licensing: CERN-OHL-S-2.0 (hardware), MIT (software),
    CC BY-SA 4.0 (documentation).
2026-10-30 Add KiCad project, custom symbols, and labeled schematics
    - KiCad 10 project skeleton with six hierarchical sheets and a
    project library (CM0, TPS2121, TPS22965 symbols; Choc hotswap
    footprint)
    - Every pin on the power, RP2040, CM0, display, and peripherals
    sheets is connected with power symbols, global labels, or local
    labels, ready to be replaced by wires; the full project netlist
    matches the 101 intended nets and ERC reports no errors
    - Per-sheet schematic specs and labeled reference PDFs/PNGs in
    docs/schematic, plus pin assignment and RP2040-CM0 protocol stubs
    - Design decisions updated: two USB-C ports, TPS2121 XCOMP with
    OV protection, USBLC6 VBUS pin on +5V, PCF8563T RTC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
2026-10-30 Add work-in-progress warning to README
    Warn that the schematics and board are untested so nobody orders
    boards or parts from the current files, and update the status line
    to "schematic in progress".
2026-10-30 Add 42-key matrix sheet, layout, and USB-C part
    - Key layout from Smidr (KLE format, 42 keys) in hardware/layout,
    with the 7x6 COL2ROW matrix mapping proven on the blad keyboard
    - Keymatrix sheet: 42 Choc hotswap switches and 1N4148W diodes
    (C81598, Basic), every pin labeled; RP2040 ROW/COL nets are now
    global labels, GPIO13/14 freed as spares
    - USB-C receptacles J1/J2 set to HRO TYPE-C-31-M-12 (C165948)
    - Power sheet: CC lines reach the RP2040 ADC again
    - Docs: design decisions, pin assignment, keymatrix spec and
    reference, open items
    Full project netlist matches all 141 intended nets; ERC has no errors.
2026-10-30 Wire the power sheet and use power symbols for +5V_LCD
    Replace the labels on the power sheet with wires, use power symbols for
    +5V_LCD and the VBUS test pads, and change J302 to Conn_01x03_Pin.
2026-10-30 Use power symbols for the CM0 3.3V and 1.8V rails
    Rename CM0_3V3 to +3V3_CM0 and CM0_1V8 to +1V8_CM0, replace their
    labels on the cm0, display and peripherals sheets with power symbols,
    and update the docs to match.
2026-10-30 Assign 0603 parts, use 30k for ILM, and switch the LDO to AP2127
    Give every resistor and capacitor a 0603 footprint and an LCSC number
    (Basic where possible), change the ILM resistor to a 30k Basic part,
    and replace the XC6206 with an AP2127N-3.3 from stock. Record the
    decisions and drop the resolved open items.
2026-10-30 Switch the RTC crystal to a 9 pF part from stock
    Use the JGHC S3132768092070 (C479190, 9 pF load) for Y401 instead of
    the 12.5 pF Epson FC-135, since the PCF8563 is characterized with an
    8 pF crystal. Same 3215 outline; assign the 3215 footprint.
2026-10-31 Add a 3D model for the 8.8-DSI-TOUCH-A display
    Build a STEP model of the 8.8-DSI-TOUCH-A from the vendor dimension
    drawing (20251215): cover lens, viewing area, panel, metal case with
    back bosses, eight standoffs, adapter board and the DSI/touch
    connectors. Origin is the lens centre, Z = 0 on the standoff ends.
    Track it via a .gitignore exception since it is our own model.
2026-10-31 Add audio, microSD and keyboard I2C, and place parts on the PCB
    Schematics:
    - Swap the MAX98357A for the TLV320DAC3100 (headphone and speaker out).
    A 12 MHz oscillator drives MCLK and the codec is the I2S clock master,
    so the stock simple-audio-card works without a custom machine driver.
    - Add the microSD slot for the CM0Lite; the SD pull-ups are footprints only.
    - Add HID over I2C from the RP2040 to the CM0 (KB_SDA/KB_SCL/KB_INT) on
    i2c-gpio, so the keyboard works on stock Raspberry Pi OS. Add test pads.
    - Use power symbols for +1V1, assign footprints and LCSC numbers, and
    fix global label shapes.
    PCB: 228.6 x 146.2 mm outline and a provisional bottom-side placement,
    with HID USB t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
2026-11-01 Add per-key RGB, finish schematic wiring, and document HID over I2C
    - Add SK6812MINI-E per-key RGB with a switched +5V_LED rail and an
    AHCT buffer on the data line; remove SW102 to free GPIO20
    - Use D_Small for the matrix diodes and replace labels with wires
    - Tidy the keymatrix sheet layout without changing connectivity
    - Document the HID over I2C keyboard path, back-power rules and
    role split across README and docs
2026-11-01 Decide output switching and how to survive sudden unplugging
    - Switch the physical key output by USB mount state, with a manual
    override from a key combination or the touch UI
    - Keep the root read-only, put writable data on its own partition,
    and show a warning on screen while it is writable
2026-11-01 Place the key RGB LEDs and assign the Choc hotswap socket
    - Put each SK6812MINI-E 4.93 mm above the switch center, using the
    stock reverse-mount footprint and its cutout
    - Assign Kailh CPG135001S30 (C5333465) to the hotswap sockets for now
    - Record the serpentine LED chain order and drop the confirmed
    footprint check from open items
2026-11-01 Place the key RGB LEDs and set JLCPCB design rules
    - Update the PCB from the schematic: add the per-key SK6812MINI-E LEDs
    and their control parts, and remove SW102
    - Put each LED 4.93 mm above its switch, and lay out the capacitors
    and diodes from the hand-placed C501/C513 and D501 templates
    - Set the board minimums to JLCPCB 2-layer 1 oz capabilities and add
    the rules it cannot express to skjar.kicad_dru
2026-11-01 Add per-size key footprints and Choc V2 stabilizer cutouts
    - Rename the key footprint to CPG135001S30_1U and add 1.25U, 1.75U,
    2.25U and 2.75U; the schematic and board pick one from each
    switch's Size field
    - Point the footprints at Choc V2 red switch models and the
    low-profile keycaps
    - Add CPG1353G24D01 stabilizer cutouts for the board (Keebio size)
    and the plate (from measurements), and place them on both spaces
    - Move the key decoupling caps and diodes to the hand-placed
    templates, and add the routing done so far
2026-11-02 Make the key footprints Choc V2 only and route the LED rows
    - Drop the Choc V1 side-post holes from CPG135001S30_<size>U: the
    stabilizers and keycaps assume Choc V2
    - Update the LED footprints from the library and route the LED
    data and power along the rows
2026-11-02 Make the board 1.2 mm and route DSI and USB as GCPW
    - Set the stackup to 1.2 mm (1.13 mm FR-4 core)
    - Add DSI (100 ohm: 0.25 / 0.2 mm) and USB (90 ohm: 0.25 / 0.15 mm)
    net classes, sized with a 2D field solver
    - Let the GND pour come within 0.2 mm of those pairs and keep 0.5 mm
    from everything else
    - Record the decision and the dimensions, and include the routing
    done so far
2026-11-03 Add the case, turn the display and place the parts under it
    - Case: tray-mount, two-piece STEP generated by hardware/case/make_case.py
    from the board (outline on User.1, Edge.Cuts, DISP1 position and
    rotation, connector positions); 3.5 degree typing angle; shown in the
    KiCad 3D view through the CASE1 footprint.
    - Display footprints for the 8.8-DSI-TOUCH-A (DISP1) and the 8.8inch DSI
    LCD check model (DISP2); both displays stay supported. The display is
    mounted turned 180 degrees so its DSI connector sits right of centre.
    - J301 pin order reversed (board pin n to panel pin n) so the DSI lanes
    line up with the CM0 without crossing; the FFC is folded twice and the
    connector must be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
2026-11-03 Use a Hirose FH12 bottom-contact connector for J301
    The supplied FFCs could be plugged into a double-contact connector the
    wrong way round, swapping 3V3 and GND. The FH12-22S-0.5SH(55) has a
    single bottom contact, so the cable only mates with its conductors facing
    the board, which is the orientation that gives board pin n to panel pin n.
    J301 uses KiCad's stock footprint, turned so its pads face the CM0, its
    opening faces the FFC slot and pin 1 (3V3) is at the front.
    Also note that the 8.8inch DSI LCD's 12 cm cable has the same 22-pin end
    as the TOUCH-A cable, so its lanes line up too.
2026-11-03 Add the one-piece case model and a render to the README
    The top/tray split did not let the board go in, because the back
    connectors poke past the board edge into the back-wall holes. This
    one-piece case (drawn in Fusion) drops the frame screws and lowers the
    key area so the board can be tilted in. make_case.py still builds the
    old two-piece case.
    Also adds a render of SKJÁR to the README and KiCad's re-save of the
    board and project.
2026-11-03 Generate the one-piece case from make_case.py
    make_case.py now builds the case as one solid after the user's Fusion
    model (skjar-case.step): no frame screws or parting plane, the key area
    4.0 mm lower than the glass with a 15 degree rounded slope, a 0.22 mm
    gap around the glass and a 0.3 mm round-over on the bottom edge. The
    result, skjar-case-onepiece.step, matches the Fusion model within
    1 mm3. CASE1 shows it in the KiCad 3D view, replacing the two-piece
    top and tray STEPs.
2026-11-03 Place the board mounting holes H1-H12
    Add Skjar:MountingHole_M2_CaseBoss (M2 from the top into an insert in a
    case boss; the screw head and the boss are on the courtyards) and place
    it at the 12 spots make_case.py used, which now reads them from the board.
2026-11-04 Tidy the schematic layout
    - keymatrix: lay the RGB LEDs out in chain order without rotation and
    gather C501-C542 into a decoupling bank on shared rails
    - power, rp2040, cm0, display, peripherals: move overlapping fields and
    parts apart, draw the RTC supply and CC sense paths as wires
    - add a short note to each sheet that links to its docs page
    ERC is clean and the netlist is unchanged.
2026-11-05 Move the display guides into DISP1 and DISP2
    Draw the 8.8inch DSI LCD standoffs on DISP2's F.Fab and move the
    display guides from Cmts.User into the footprint of each display
    (the FFC slot and LCD cable hole guides stay on the board). Also cut
    the FFC slot and move the USB-C connectors 0.79 mm forward.
2026-11-05 Ignore the board's exported STEP
2026-11-05 Leave 0.5 mm around the display studs
    Shrink DISP1's outer holes to 5.2 mm and make the inner ones 6.5 x 10.5
    mm slots centred on the 8.8inch DSI LCD standoffs, so every stud and
    standoff has at least 0.5 mm all round.
2026-11-05 Notch the board edge at the display holes near it
    Open the DISP1 and DISP2 holes that sat within about 1.5 mm of the board
    edge into notches.
2026-11-05 Turn the display back, move CM0 to the middle and take the FFC from the left
    - Display at 0 deg again (connector on the left). CM0 turned 180 deg and
    moved to the middle; J301 to its right with the FFC slot on its left,
    the cable folded once above and passed through the slot in an S.
    - J301: single-sided top-contact Hirose FH12A-22S-0.5SH(55); pins back in
    the Raspberry Pi order (3V3 on pin 22, at the back).
    - J1 and J201 above CM0, the audio, RTC and battery where CM0 was, J302
    mirrored with the display, mounting holes moved out of the way.
    - Board outline: the notches mirrored to the new hole positions.
    - CM0 footprint: CPU, wireless, eMMC and antenna connector on F.Fab, and a
    3D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
2026-11-05 Place the eMMC on the CM0 footprint and model from the EDATEC drawing
    Use the eMMC frame of the EDATEC top view (checked against the SoC
    position in the Raspberry Pi datasheet), with the chip shifted down in it
    as on a photo of a CM0 with eMMC. List the EDATEC document in the
    references.
2026-11-06 Ground the flash's exposed pad and share IOVDD 49's cap with USB_VDD
    The W25Q128JVP gets its own symbol with the exposed pad (pin 9) on GND.
    USB_VDD drops its own 100 nF so the caps on the crowded right side can sit
    closer to the pins; IOVDD 49's cap serves both.
2026-11-06 Swap the microSD to the TF-01A, route DSI and SD, and raise the display
    - J201 is now a Korean Hroparts TF-01A (push-push) on a self-made
    footprint and model, front of the body on the board edge.
    - DSI and the SD lines are routed on B.Cu with GND stitching along DSI.
    Custom rules keep DSI pairs 0.75 mm apart and P/N within 0.15 mm.
    - The 8.8inch DSI LCD's corner standoffs are too short to reach the
    board, so DISP2 has no holes and the top edge is straight there.
    - The display sits 0.4 mm higher (case glass top 12.16 mm).
    - J1, J2 and J201 positions are fixed; the USB-C openings in the back
    wall shrink to 10.0 x 4.4 mm since the plug overmold stays outside.
    - Docs follow the new posit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
2026-11-06 Add a 3D model for the TS-1187A tact switch
    Drawn from the XKB drawing (TS-1187A-X-X-X rev A2); KiCad ships no model for
    this footprint.
2026-11-06 Resave the CM0 footprint in the KiCad 10 format and colour its model
2026-11-06 Route around the RP2040 and reorder the key matrix GPIOs
    Swap ROW/COL across GPIO0-12 so the matrix lines leave U101 without crossing,
    and move the ADC resistors, flash, regulator and LED driver parts to suit.
    +3V3 joins the Power netclass.
2026-11-06 Update the GPIO table and re-export the schematic reference sheets
2026-11-08 Place the microSD pull-ups and route them, and move the CM0 5V caps in
    R203-R207 sit beside J201 with the SD lines dropping to F.Cu where needed.
    C201/C202 move next to CM0 pins 67/68; R201/R202, R208-R210, U3 and J301 move.
2026-11-08 Round the rectangular pads of the microSD, battery holder and FPC footprints
    Use KiCad's standard corner ratio (25 % of the short side, at most
    0.25 mm) and drop the 45-degree thermal spokes from the microSD pads.
2026-11-08 Move the CM0 and microSD caps, route +5V and +3V3_CM0, and round the J201/BT401 pads
    Also move U202 and J302, drop the STAB1/STAB2 edge-clearance DRC
    exclusions, and update the J201 and BT401 pads to match the library.
2026-11-08 Tidy the TPS2121 footprint: reference, courtyard, silk and pin 1
    Bring the reference in to 2.1 mm from the centre, grow the courtyard
    to clear the pads, move the silk outline and pin-1 dot off the pads,
    round pin 1, and resave the footprint in the KiCad 10 format.
2026-11-08 Route power around U3, update U3 to the new footprint, and put DISP2 back on DISP1
    Move and rotate U3 and continue the VBUS/+5V routing, add 1.5 and
    2.0 mm track widths, update U3 to the tidied footprint, and move the
    8.8inch DSI LCD check model (DISP2) back to the TOUCH-A position.
2026-11-08 Add the RMK keyboard spike, the LVGL touch UI spike and the CM0 config
    Firmware (firmware/rp2040): an RMK 0.9 spike for a Pico. It reads the
    key matrix and passes RMK's reports to the CM0 as a HID over I2C
    target (0x2C), with the keyboard overlay in software/os/overlays.
    Linux (software/ui, software/os): a touch UI in LVGL 9.6 (C) that draws
    to the framebuffer, turns the 480x1920 panel to 1920x480 and reads the
    touch through evdev. It has touch keys, media keys, the backlight, the
    output selector and a status bar, and talks to the RP2040 over the
    UART. Also config.txt, a systemd unit and a fake RP2040 for testing.
    Docs: choose RMK and LVGL, draft the UART line format (protocol.md 1),
    recor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
2026-11-09 Add the RP2040 side of the CM0 UART link
    cm0_link.rs speaks the draft line format from protocol.md chapter 1 on
    UART0 (GPIO16 / 17): it reads HELLO, ALIVE, KEY, OUT, LCD and UF2, and
    sends ALIVE every second, BLMAX, OUT and LAYER (from RMK's layer
    events). Lines that are not well-formed frames, such as the CM0's boot
    log, are dropped. PWR and SHUTDOWN wait for the CC and power logic.
    reports.rs merges touch keys with RMK's reports (modifiers ORed, up to
    six keys, physical consumer key first) before they go to HID over I2C,
    and releases all touch keys on HELLO or when the CM0 is quiet for 3 s.
    Builds and passes clippy for both the pico and skjar features. Not yet
    tried on hardware.
    Co-Auth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
2026-11-09 Run the touch UI on Windows
    Add a windows backend (LVGL's Win32 driver, LV_OS_WINDOWS) next to
    fbdev and SDL, so the screen can be tried on a Windows PC. The POSIX
    parts move behind small layers: platform.c (clock, sleep, localtime)
    and serial_port.c (tty on Linux, COM port on Windows). sysinfo reads
    Windows CPU and memory, and the backlight is a no-op there.
    tools/build_windows.py builds it with zig cc (pip install ziglang),
    so neither CMake nor Visual Studio is needed; CMake picks the windows
    backend on WIN32 too. --zoom scales the PC window. On the PC the
    power-off button only logs.
    Also switch LV_COLOR_DEPTH to LV_COLOR_FORMAT_DEFAULT (deprecated in
    LVGL 9.6).
    Checked: builds and star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
2026-11-09 Add a multi-touch trackpad: Pad tab, PTR/WHEEL and a mouse report
    UI: a Pad tab with a touch area and L / R buttons. trackpad.c turns the
    number of fingers and their centroid into pointer motion and buttons:
    one finger moves, a tap clicks, tap then move drags, two fingers
    scroll, a two-finger tap right-clicks and a three-finger tap
    middle-clicks. Position jumps (stale first points, noise) are not
    counted as motion. touch_source.c reads every finger from the touch
    panel's evdev (multi-touch protocol B) on Linux, because LVGL's pointer
    and gesture recognisers cannot do a trackpad; elsewhere it uses LVGL's
    pointer, with Shift / Ctrl standing for two / three fingers on Windows.
    Swiping between t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
2026-11-09 Rework the touch UI around a 2x12 touch-key strip
    Layout: the 1920x480 screen is a 160 px top bar (clock, tab buttons,
    status) over a 320 px body next to the physical keys. The Keys tab is
    2 rows of 12 touch keys at a 160 px (18.32 mm) pitch: the 219.88 mm
    view area cannot fit 12 x 19.05 mm, so the keys are spread evenly and
    line up with the physical columns in the middle (about 4 mm off at the
    ends). Defaults: F1-F12 over Esc 1-0 Bksp, with the shifted symbol
    shown above each digit.
    Firmware: the keymap grows from 7 to 11 rows; rows 7-10 are the touch
    keys, fed to RMK as key events from the UART TK message, so layers and
    Vial apply to them like to the physical keys. The RP2040 reads each
    t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
2026-11-09 Keep the header at 80 px and show status as coloured chips
    The header is now always one 80 px row (it used to be 160 px and only
    shrank on the Pad tab): time with the date under it, the tab buttons,
    and status chips on the right. Chips use colour for state: the layer
    chip turns orange above layer 0, power is green / amber / red for
    3A / 1.5A / Default, CPU turns amber at 70 C, and a red RP2040 chip
    appears only while the link is down. RAM moves to the System tab under
    the CPU chart.
    The body is 400 px. The Keys tab keeps its 2 x 160 px rows at the
    bottom, next to the physical keys, leaving an 80 px gap under the
    header; Pad, Media and System use the full height.
    Checked on the Windows buil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
2026-11-09 Keep the CPU chip the same width as the numbers change
    The CPU chip was one label ("CPU 9% 48C"), so its width and the
    position of every glyph moved with the digits. It is now "CPU" plus two
    right-aligned fields sized to the widest value ("100%", "100C"),
    measured with lv_text_get_size. When the temperature is unknown (on
    the PC) the field shows "--" and keeps its width.
    Checked on the Windows build: four captures at 10 %, 9 %, 7 % and 11 %
    show the same chip width and alignment; tests pass; the aarch64 fbdev
    build links.
2026-11-09 Try a background picture with see-through buttons (Look setting)
    A trial look: a full-screen picture behind the UI, with the header,
    touch keys, pad, Media and System boxes made semi-transparent so the
    picture shows through; checked and pressed buttons stay more opaque so
    they still read. The System tab's new Look selector switches between
    Plain (as before) and Picture, saved in ui.conf.
    background.c puts an lv_image behind everything (ignored by the
    screen's flex layout, inner align COVER). With --background <png> it
    shows that file through LodePNG and the stdio file system ('A:'),
    otherwise it paints an aurora-like picture at startup (dark navy
    gradient with soft teal / purple / blue glow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
2026-11-09 Draw a palette icon for the Look setting
    The Look title borrowed LV_SYMBOL_IMAGE, the same small picture-frame
    glyph the Backlight row used before, and it was easy to miss. icons.c
    now draws a palette too (round board, thumb notch at the lower right,
    four paint holes) and shares one A8 renderer between the sun and the
    palette. The System tab's selector() takes an optional drawn icon for
    its title; the other titles keep their LVGL symbols.
    Checked on the Windows build at 100 %; tests pass; the aarch64 fbdev
    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
2026-11-09 Put the symbols on the lower touch row of layer 1 and drop the arrows
    The lower touch row is easier to reach, so layer 1 now puts the
    symbols that the number row cannot give there (` - = [ ] \ ; ' , . /)
    with Del at the right end, where Bksp is on layer 0. The upper row has
    Home End PgUp PgDn Ins PrtSc, then Caps, Menu (HID Application, 0x65),
    ScrLk and Pause; the arrows are gone and the last two keys are
    transparent, so F11 / F12 from layer 0 show through.
    The UI's default map for layer 1 follows the firmware keymap.
    Checked: firmware builds and passes clippy for pico and skjar; the
    Windows build shows the new layer 1; tests pass.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
2026-11-09 Layer 1 touch keys: arrow cross, no , . / - or F11/F12; show empty keys
    Layer 1's touch rows are now:
    upper Home End PgUp PgDn Ins PrtSc Caps Menu (empty) Up ScrLk Pause
    lower ` = [ ] \ ; ' (empty) Left Down Right Del
    , . / are on the physical keys and - is not needed, which leaves room
    for an inverted-T arrow cluster (Up above Down). F11 / F12 are already
    on layer 0, so the right end takes ScrLk and Pause. The two empty keys
    sit left of the arrows, which keeps fingers off Up and Left by mistake.
    UI: an empty key's label was "", which buttonmatrix reads as the end
    of the map, so every key after it vanished. Empty keys now get a
    single space and the disabled state, drawn at 20 % so the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
2026-11-09 Layer 1 touch keys: Caps at the lower left, no Menu, ScrLk/Pause after PrtSc
    upper Home End PgUp PgDn Ins PrtSc ScrLk Pause (empty) Up (empty) (empty)
    lower Caps ` = [ ] \ ; ' Left Down Right Del
    Menu (Application) is dropped, Caps moves to the left end of the
    easier lower row, ScrLk and Pause follow PrtSc, and every other upper
    slot is an empty (no-op) key. The UI's default map follows.
    Windows build shows the new layer 1; tests pass.
    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
2026-11-09 Colour the power chip only when the supply is Default
    1.5A only caps the backlight and is a normal way to run SKJÁR, so
    showing it amber (and 3A green) on every glance was noise. The power
    chip now stays the muted colour for 3A and 1.5A and turns red only for
    Default, when the CM0 and the screen are off. This matches the other
    chips, which take a colour only when something needs attention.
    Checked on the Windows build with PWR,B,1.5A and PWR,A,DEF; tests pass.
2026-11-09 Show held touch keys and Pad buttons darker, like the Media buttons
    Touch keys used the CHECKED state to show a held key, which the theme
    draws in bright primary blue. They now keep their normal colour and get
    the theme's pressed look (black recolor at 35/255), the same as the
    Media buttons.
    The Pad's L / M / R were plain lv_buttons in primary blue. They now use
    the key grey, are not clickable for LVGL, and get the pressed state
    from pad_input, so a second finger pressing L while another moves on
    the pad darkens it too. Leaving the Pad clears the pressed look.
    Checked on the Windows build: a held "1" key and a held L button are
    drawn darker than their neighbours (L 40,43,47 vs M 47,50,55);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
2026-11-09 Make pressed buttons equally dark on every tab in the Picture look
    With the background picture on, a pressed button's opacity depended on
    the tab: touch keys (shown as CHECKED) went to 230, Media buttons
    (PRESSED) to 200, and the Pad's L / M / R stayed at 110. The darkening
    itself (black recolor at 35/255) was the same everywhere, but the
    different amount of background showing through made them look
    different.
    Pressed buttons now keep the normal see-through opacity (110) and are
    only darkened. Selected tabs and System options (blue CHECKED) stay at
    230 so they still stand out; touch keys use CHECKED as their pressed
    mark, so they keep 110 for it.
    Checked on the Windows build at 100 % in Pi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
2026-11-09 Darken pressed buttons a bit more, the same on every button
    Pressed buttons now get black recolor at 60/255 instead of the theme's
    35, through one press_look() helper: touch keys (CHECKED), the tab bar,
    Media buttons, System selectors (PRESSED items), the Pad's L / M / R
    and the hold buttons. Before, the tab bar, Media and the System
    buttons relied on the theme's own pressed style and only the touch
    keys set it themselves.
    Checked on the Windows build: in Picture a held "1" key goes from
    33,49,66 to 28,44,60 (0.89 of its brightness, was 0.93); tests pass.
    Media and Pad could not be re-measured this time because the test
    window did not get the synthetic mouse clicks; they use the same
    helper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
2026-11-09 Balance the pressed look between Plain and Picture
    At 60/255 the pressed darkening was strong in Plain but weak in
    Picture: the recolor only darkens a button's semi-transparent fill,
    and the background showing through keeps its brightness.
    Plain now darkens by 45/255. Picture darkens by 60 and also raises a
    pressed button's opacity from 110 to 180 so less of the background
    shows through. press_look() records each button so apply_look() can
    switch the amount with the Look setting. Selected tabs and options
    (blue) stay at 230, also while pressed.
    Measured on the Windows build (pressed / unpressed brightness):
    Plain 0.82 on Keys, Media and Pad L alike; Picture 0.83, 0.80 and
    0.77 (the backgro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
2026-11-09 Add a hidden movie player with key lights synced to the frames
    Tapping the header clock five times plays a full-screen movie and
    lights the keys to match it; a tap stops it (not within the first
    second, so a sixth tap of the trigger does not end it at once). The
    movie itself is not in the repository: tools/make_movie.py turns the
    user's own video into movie.skm (screen and key-light frames) and
    movie.wav with ffmpeg, and *.skm / movie.wav are git-ignored.
    .skm: 320x240 frames at 30 fps in four grey levels, run-length coded,
    plus 42 key brightnesses (0-15) per frame, taken by stretching the
    12u x 4u keyboard over the whole picture and averaging nine points per
    key. The UI shows the picture d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
2026-11-09 Split the hidden movie between the screen and the keys
    The screen and the keyboard now act as one picture: the converter
    places the video on a frame laid out like the real thing (the
    keyboard's width, from the top of the screen's view area down to the
    bottom of the keys, using the drawing's view area and the PCB key
    positions), shows the part over the view area on the screen and
    lights each key with the brightness at its own position. The video is
    fitted to the frame whole (--fit contain, default) or to cover it
    (--fit cover).
    Screen frames are now 960x240, which the UI doubles to fill the whole
    1920x480 screen (old 320x240 files still play in the middle). The key
    preview moves to a small b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
2026-11-09 Reserve the strip above the touch keys for future widgets
    The 1920 x 80 px strip between the header and the two rows of touch
    keys on the Keys tab is to hold widgets later: for example a timer, a
    player for music on the microSD card, and a news ticker fetched over
    Wi-Fi that scrolls like an LED sign. It stays empty for now.
    Recorded in design-decisions (chapter 4) and open-items, with the
    questions still to settle (how many widgets at once, how to pick them,
    how to plug them in, other tabs); the code comment says the same.
2026-11-09 Switch between keyboard mode and cyberdeck mode, with a keymap for each
    The touch UI is keyboard mode: physical keys go to the PC and use layers
    0-2. "Open console" on the System tab closes the UI and hands tty1 back
    to the login console (cyberdeck mode: keys to the CM0, layers 3-5).
    Typing `skjar` in the console starts the UI again.
    - RP2040: OUT,PC / OUT,CM0 set the default layer to 0 / 3 by pressing
    DF keys on a virtual row 11. USB state (configured, suspended) is sent
    as USB,<0|1>. Falls back to keyboard mode when the CM0 goes quiet.
    - UI: replaces "Physical keys to" with an Open console button, shows
    "Connect SKJAR to a PC" while USB,0, and with --start boot goes straight
    to th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
2026-11-09 Add the Widget strip with a Pomodoro timer and a news ticker
    The 1920x80 strip above the touch keys now shows one widget at a time,
    switched by swiping left and right. None is first and the default; the
    System tab's "Widget strip" picks which widgets follow it (saved in
    ui.conf).
    - Pomodoro: 25/5 min with a 15 min break every 4 rounds. Start/pause,
    skip, reset. When a round ends it stops, shows a toast and flashes the
    key lights (LEDF). Keeps counting while hidden.
    - News: an amber electric sign scrolling the headlines in news.txt next
    to ui.conf. tools/fetch_news.py writes it from RSS/Atom feeds (ASCII
    only, to match the font); skjar-news.timer runs it every 15 minutes.
    - Touches i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
2026-11-09 Save Widget strip choices after the button toggles, not before
    The button matrix reports VALUE_CHANGED on press, before a checkable
    button flips, so turning a widget on saved it as off. Ask for the event
    on release (CLICK_TRIG) and log each change.
2026-11-09 Keep the news ticker at its set speed however long the headlines are
    LVGL's speed-encoded anim_duration clamps one loop to 10 s, so twenty
    headlines raced across the strip at many times NEWS_SPEED. Work out the
    loop time from the text width instead.
2026-11-09 Tone down the news ticker in the Picture look
    Over the background picture the black-and-amber sign was too loud. In
    Picture the board and NEWS badge now use the header's own panel colour
    and opacity (110) with white text; Plain keeps the amber sign.
2026-11-09 Add Typing and Weather widgets and rearrange the System tab
    - Typing: counts ACT key presses into a 15 s WPM, today's keys and best
    WPM, and a 2-minute bar chart.
    - Weather: reads weather.txt from tools/fetch_weather.py (Open-Meteo,
    no API key; Tokyo by default, --city or --lat/--lon). Shows now, today's
    range and rain chance, the next four 3-hour slots and tomorrow, with
    weather icons drawn at start-up like the other icons.
    skjar-weather.timer fetches it every 30 minutes on the device.
    - Widget order is Typing, Pomodoro, Weather, News, and the last shown
    widget is remembered in ui.conf.
    - System tab: the Widget strip gets the wide slot as a 2x2 grid; "Back on
    typing" moves und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
2026-11-09 Record demo videos from the UI itself, and fix the Typing chart
    - --record <mp4> --demo <script> (src/recorder.c): runs the UI on its own
    clock, plays a script of actions (link lines such as LAYER and ACT,
    touch keys, tabs, look, widget swipes, the Pomodoro button) and pipes
    each 1920x480 frame to ffmpeg. No window capture or mouse, and the same
    video every time. Settings are not saved while recording.
    - tools/make_demo.py and tools/demo/: the demo script with sample
    settings, news and weather, made into a 16:9 video with a title and a
    screen-only video in build-demo/.
    - link_inject() feeds a line as if it came from the RP2040 (shared with
    the stdin test input).
    - Typing: durin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
2026-11-09 Also make a 2.39:1 demo video without the title
    make_demo.py now writes demo_2.39.mp4 (1920x804, the screen centred,
    tagline below, no title) next to the 16:9 one. --reuse keeps the existing
    recording and only remakes the framed videos.
2026-11-10 List what comes with the 8.8-DSI-TOUCH-A
    Add the package contents and what each cable is for (the 12 cm DSI
    cable for trying it on a Pi 4B, the 22-pin FFCs for J301, the 5 V
    cable), and note the 5 V input is a 2-pin MX1.25.
2026-11-10 Note the 12 cm DSI cable is 15-pin to 22-pin
    The product photo shows it, so it no longer needs checking on arrival.
2026-11-10 Choose the news genres on the widget
    Tapping the News widget opens a list of genres (NHK's eight and BBC
    World); any number can be picked and Done saves them to news_feeds= in
    ui.conf, which fetch_news.py now reads. The headlines are then fetched
    at once, as for the weather place: skjar-news.path on the device, the
    UI itself on Windows. With several genres fetch_news.py takes one from
    each in turn and keeps up to 40.
    The weather place list and the genre list now share the picker code.
2026-11-10 Keep the weather place button to the width of its text
    The tappable area no longer stretches over the gap before the hourly
    forecast; a fixed-width holder keeps the hourly slots where they were.
2026-11-10 Scroll the news ticker evenly however long it is
    LVGL's linear anim path rounds progress to 1024 steps, so with several
    genres (a loop of tens of thousands of px) the ticker stood still for a
    few frames and then jumped 20-40 px; only Top was short enough to look
    smooth. The ticker now moves its own row of labels with an unrounded
    path, at a whole 5 px per 33 ms refresh (about 152 px/s). One label per
    headline also keeps LVGL from walking every glyph of one huge label on
    each refresh. The loop length is logged.
2026-11-11 Add setup steps for the Pi 4B / Zero 2 W test boards
    devboard.md walks through flashing the Pico, wiring, installing
    Raspberry Pi OS Lite and the overlay, UART, UI and fetchers, and what
    to check. config-devboard.txt holds only what the test boards need
    (keyboard overlay, UART, the DSI panel on the 4B) and is appended to
    the OS's own config.txt. The keyboard overlay's bus node loses its
    unit address so dtc no longer warns.
2026-11-11 Silence GCC format-truncation warnings seen on the Pi
    file_path now always has room for the folder plus /ui.conf, and the
    city= value is cut at 47 characters explicitly.
2026-11-11 Note what makes the test board boot slowly
    On the Pi 4B with Raspberry Pi OS Lite it took 41 s: cloud-init cost
    about 5 s, and NetworkManager about 18 s because it rewrites the netplan
    files each boot and netplan asks for four daemon-reloads of about 3 s.
    The image should keep connections as NetworkManager keyfiles, leave out
    cloud-init and not make the UI wait for the network.
2026-11-11 Build the firmware for a Seeed XIAO RP2040 too
    The XIAO brings out only 11 pins, so the xiao feature keeps I2C on
    GPIO26 / 27, moves KB_INT to D2 (GPIO28) and the UART to D6 / D7
    (GPIO0 / 1), and wires only ROW0 / ROW2 by COL0-3 of the matrix (Esc Q
    W E / Tab A S D); the other rows and columns sit on pins that are not
    brought out. The README has the wiring table, and devboard.md points to
    it. Choosing more than one board feature now stops the build.
    Also notes in devboard.md to turn cloud-init off after the first boot
    and how to add Wi-Fi without re-imaging, and the boot screen ideas in
    open-items.md.
2026-11-11 Blame the lost SSH on power, not cloud-init, in devboard.md
    The 4B dropped off Wi-Fi because its supply was too weak once the panel
    also drew from the header's 5 V (get_throttled 0x50005); unplugging the
    panel brought it back. Leave cloud-init alone on the test boards, power
    the panel separately, and check get_throttled.
2026-11-11 Make the panel's framebuffer 32-bit to stop gradient banding
    On the Pi 4B, vc4 gave fb0 16 bits per pixel and the Picture
    background's gradients banded. video=DSI-1:480x1920-32@60 in
    cmdline.txt gives 32 bits; the banding goes and scrolling stays
    smooth. devboard.md has the step, config.txt notes it for the CM0, and
    the UI README records the result. The panel's orientation and touch
    were also right on the 4B.
2026-11-11 Let only one UI draw to the framebuffer
    Running both start lines from devboard.md started a second UI with
    --rotate 0, and whichever one redrew last (e.g. on a Look switch) won,
    so the screen seemed to turn back to portrait. The UI now takes a flock
    on the framebuffer and exits with a hint if another one holds it, and
    devboard.md gives the 4B and Zero 2 W start lines separately.
2026-11-11 Take the framebuffer lock out again for now
    It stopped a UI from starting with nothing else apparently running, so
    go back to no single-instance check while that is looked into. The
    separate 4B / Zero 2 W start lines in devboard.md stay.
2026-11-11 Bring back the framebuffer lock
    Taking it out showed it had been right: another UI was running and the
    two drew over each other. If the lock is held, the message now also
    points at systemctl status 'skjar-ui@*'; if flock fails for any other
    reason, the UI starts without it instead of stopping.
2026-11-11 Use the default DPI on the panel too
    The fbdev driver works out the DPI from the panel's physical width
    (about 220 for the 8.8-inch), and the default theme then grows its
    padding and radii, so selector buttons shrank to pills on the Pi while
    they filled their boxes on Windows. The UI is laid out in pixels, so
    set LV_DPI_DEF before rotating (the theme is rebuilt on rotation).
2026-11-11 Clear a stale USB suspend so the RP2040 sees the PC
    On the XIAO RP2040 the firmware kept reporting USB,0 although the PC
    had it as a serial port: a suspend that arrives before enumeration was
    never cleared, since embassy-usb does not call suspended(false) on reset
    or configuration. Clear it then. HELLO now logs the USB state.
    Checked with a XIAO RP2040 and a Pi 4B: i2c-hid finds the keyboard and
    evtest gets KEY_Q, and the UI and the RP2040 exchange their state over
    the UART. open-items.md and the firmware README say what is confirmed
    and what is left.
2026-11-11 Note touch keys reach the Pi, and the RP2040-only restart problem
    UI touch keys (F1, F6) went over the UART as TK, through RMK and back
    over HID over I2C to evtest on the Pi 4B. After re-flashing the XIAO,
    keys stopped until i2c-hid was unbound and bound again: the RP2040 drops
    input until it gets RESET, which i2c-hid sends only when it finds the
    device. open-items.md records both and an idea for the fix.
2026-11-11 Note the trackpad over I2C, and why 250 kHz is out
    The Pad tab's movement reached the Pi 4B as an i2c-hid mouse. Its
    reports come every 24 ms because the Goodix touch panel reports at
    that rate; one report takes about 1.5 ms at 100 kHz. At about 250 kHz
    (delay-us 2) the interval did not change and the reports stopped
    mid-swipe: the Pi stopped reading, the RP2040 queue overflowed, and
    only unplugging the XIAO brought it back. Stay at 100 kHz, and give the
    RP2040 a way to recover its I2C target.
2026-11-11 Align the Typing bars to 5-second slots, and note the console gap
    The Typing chart cut its bars as 5 s back from now, so every second
    each bar's contents shifted and their heights seemed to change while
    nobody typed. The bars now follow fixed 5-second slots: only the newest
    grows, and the rest move left one bar at a time.
    On the XIAO RP2040 and Pi 4B, ACT, the mode switch and the Caps Lock
    LED (output report) worked. open-items.md also records a design gap:
    after Open console the UI stops sending ALIVE, so the RP2040 falls back
    to keyboard mode after 3 s, which on the real board would send the keys
    to the PC instead of the console. Two fixes are sketched there.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
2026-11-12 Keep touches from reaching keys hidden behind the PC notice
    While the Connect SKJAR to a PC notice was up, touches still went to
    the touch keys and the widget strip under it, so pressing near the
    notice's Open console button could also send a touch key. Treat the
    notice like the pickers and hold input until the finger is lifted.
2026-11-12 Send keys to the PC over USB, and let the RP2040 decide the mode
    The firmware now builds its own USB device (keyboard, mouse and media
    keys with RMK's descriptors, plus the log serial port) and sends the
    physical keys, touch keys and trackpad to the PC in keyboard mode and to
    CM0 over HID over I2C in cyberdeck mode, releasing everything on the old
    side when it switches.
    The RP2040 owns the mode. While the UI is up (HELLO or ALIVE) the keys
    go to the PC if one is connected; once it is gone (BYE, or no ALIVE for
    5 s) they go to CM0 if its kernel still reads I2C, and to the PC if not
    (CM0 off, booting, shutting down or hung). The kernel is checked by
    leaving an unchanged keyboard report on I2C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
2026-11-13 Let the XIAO reach layer 2 for the volume and USER keys
    The XIAO's six matrix pins now form 3 rows by 3 columns: rows 2, 4 and
    6 by columns 1, 2 and 5. Holding the thumb row's layer 2 key (D3-D8)
    turns D4-D9 / D4-D10 into Mute / volume down and D5-D9 / D5-D10 into
    USER0 / USER1, so those can be tried before the board exists. The Pi
    wiring does not change. The README table follows.
